generalroboticslab/Cartesian_Hand/media/hand-axes.jpg

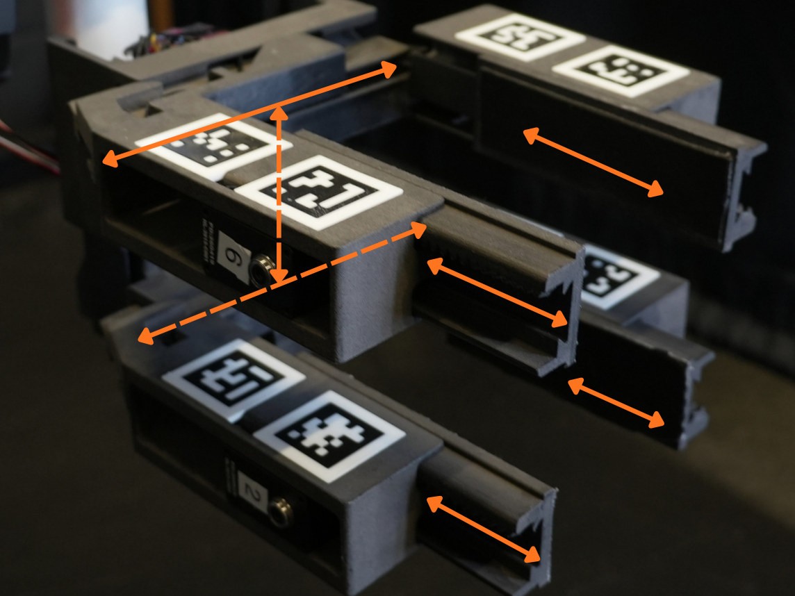
media/hand-axes.jpg
