generalroboticslab/Cartesian_Hand/assets/cartesian_hand/meshes/bridge__steel.obj

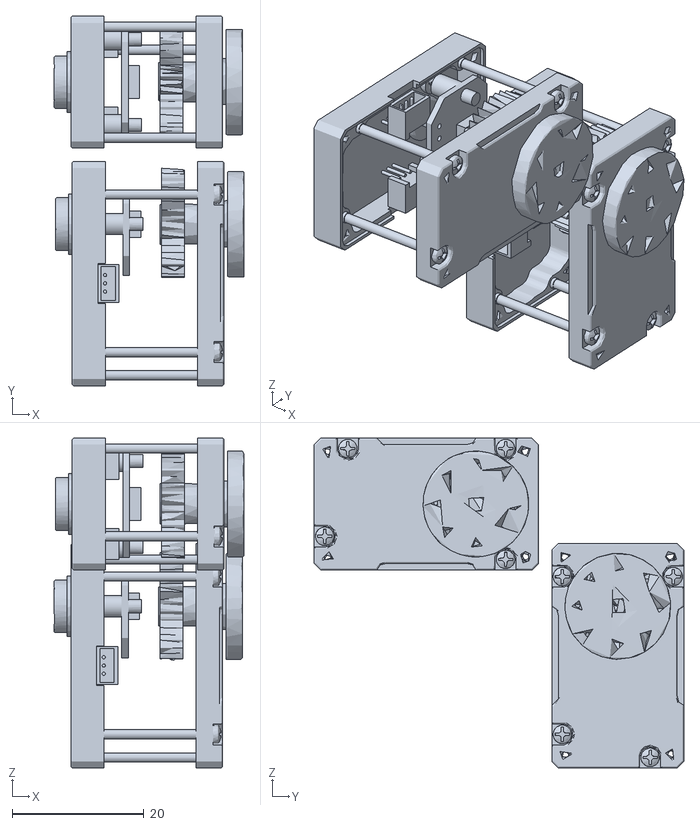
[picture p11: CAD file, 2026-09-22]
assets/cartesian_hand/meshes/bridge__steel.obj
28.7 x 56.0 x 50.0
