generalroboticslab/Cartesian_Hand/assets/cartesian_hand/meshes/collision_pieces/base_02.obj

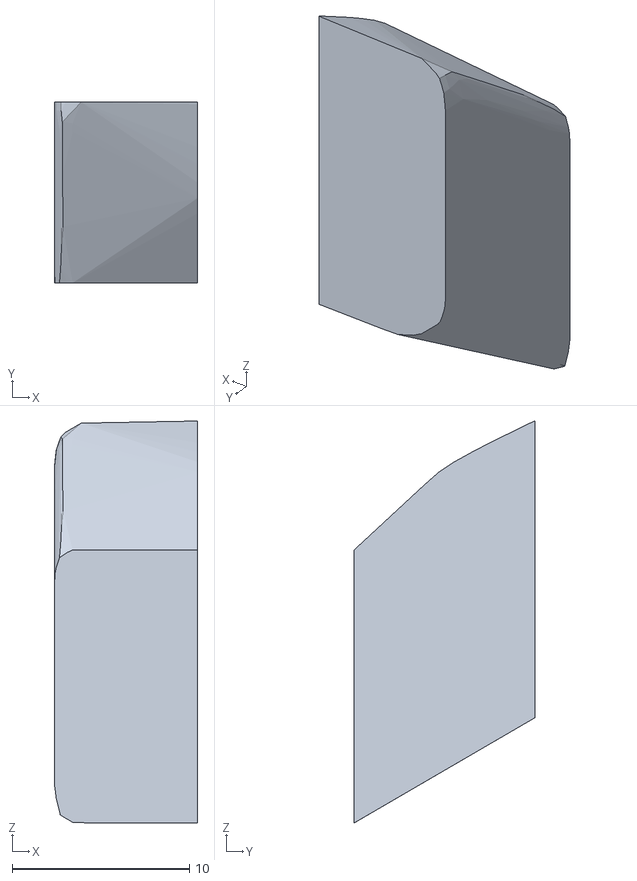
[picture p12: CAD file, 2026-09-22]
assets/cartesian_hand/meshes/collision_pieces/base_02.obj
8.08 x 10.2 x 22.7
