generalroboticslab/Cartesian_Hand/hardware/CAD/franka_mount.step

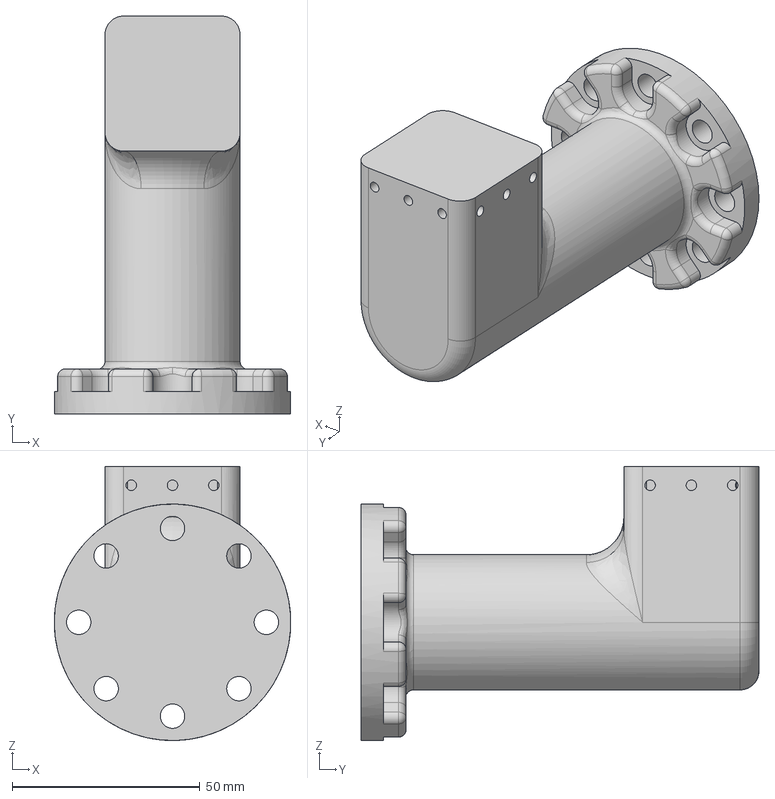
[picture p14: CAD file, 2026-09-28]
hardware/CAD/franka_mount.step
63.0 x 106.0 x 73.0 mm
