generalroboticslab/Cartesian_Hand/assets/cartesian_hand/meshes/collision_pieces/bridge_69.obj

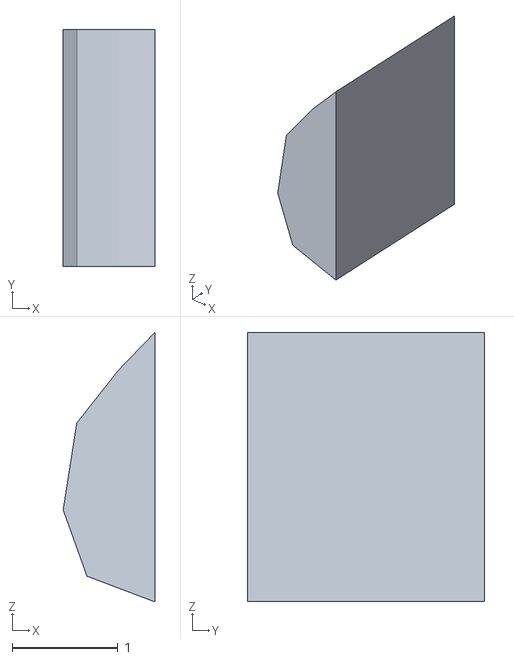
[picture p15: CAD file, 2026-09-22]
assets/cartesian_hand/meshes/collision_pieces/bridge_69.obj
0.865 x 2.24 x 2.54
