generalroboticslab/Cartesian_Hand/assets/cartesian_hand/meshes/left_up_finger__nylon.obj

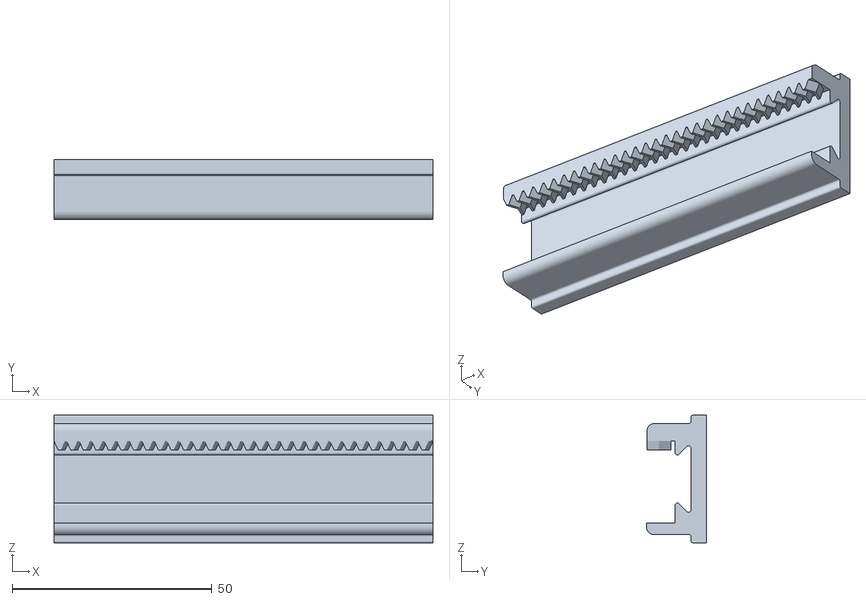
[picture p16: CAD file, 2026-09-22]
assets/cartesian_hand/meshes/left_up_finger__nylon.obj
94.9 x 15.1 x 32.0
