generalroboticslab/Cartesian_Hand/hardware/CAD/finger.step

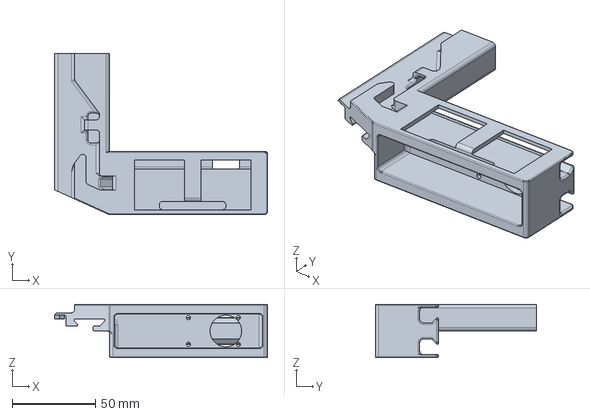
[picture p17: CAD file, 2026-09-28]
hardware/CAD/finger.step
127.9 x 97.0 x 31.9 mm
