generalroboticslab/Cartesian_Hand/assets/cartesian_hand/meshes/collision_pieces/bridge_27.obj

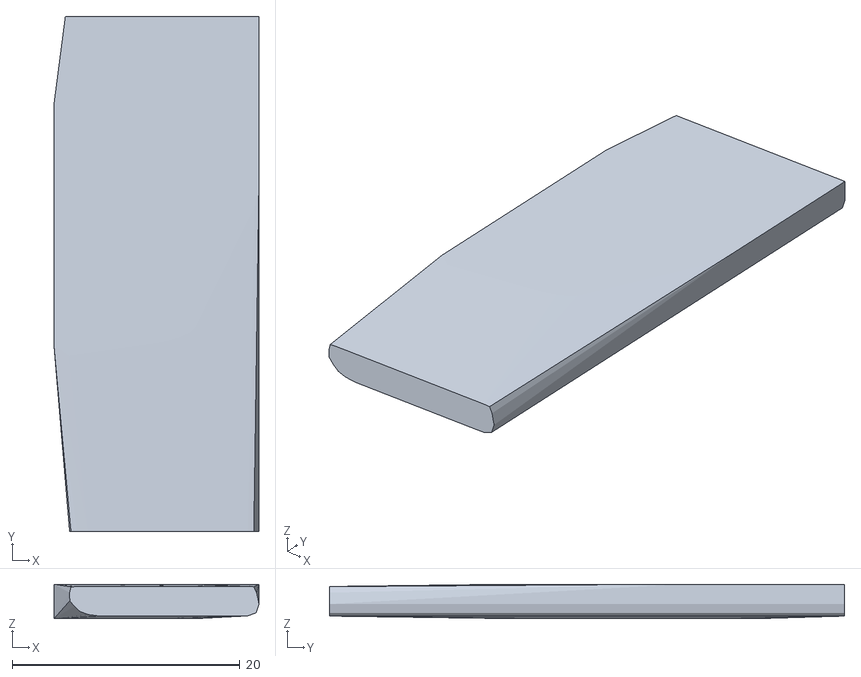
[picture p18: CAD file, 2026-09-22]
assets/cartesian_hand/meshes/collision_pieces/bridge_27.obj
18.0 x 45.2 x 3.02
