generalroboticslab/Cartesian_Hand/assets/cartesian_hand/meshes/collision_pieces/bridge_21.obj

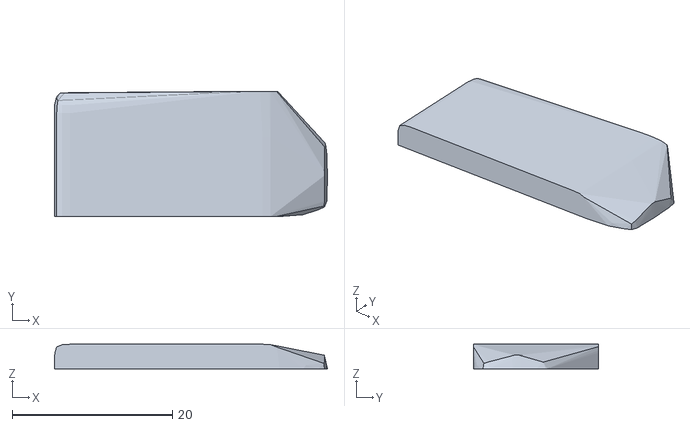
[picture p20: CAD file, 2026-09-22]
assets/cartesian_hand/meshes/collision_pieces/bridge_21.obj
34.1 x 15.6 x 3.07
