generalroboticslab/Cartesian_Hand/assets/cartesian_hand/meshes/left_down_rack__nylon.obj

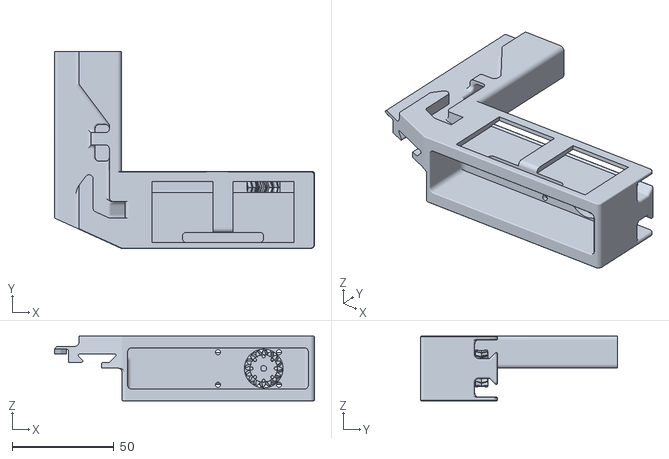
[picture p21: CAD file, 2026-09-22]
assets/cartesian_hand/meshes/left_down_rack__nylon.obj
127.9 x 97.0 x 31.9
