generalroboticslab/Cartesian_Hand/hardware/CAD/base gripper rail.step

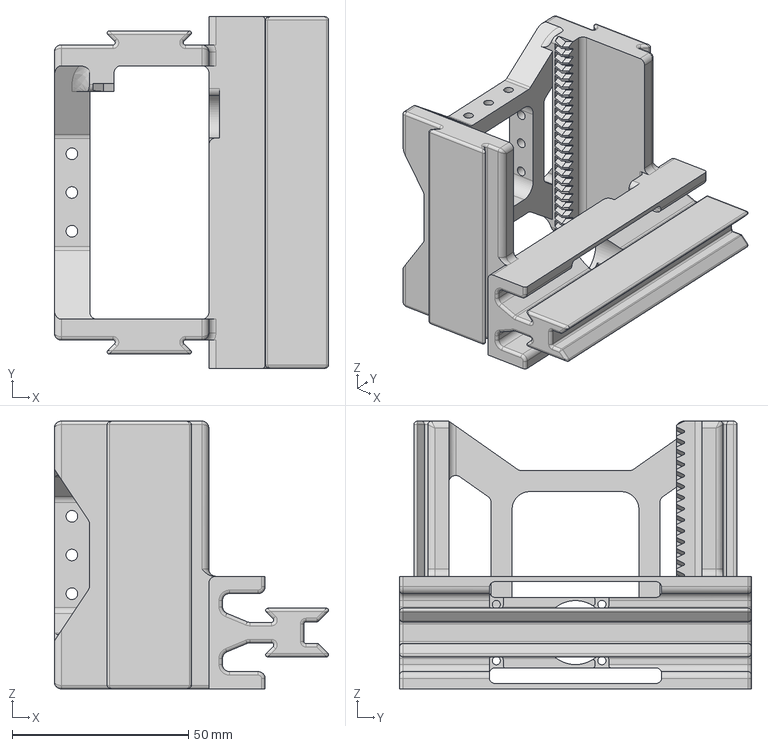
[picture p22: CAD file, 2026-09-28]
hardware/CAD/base gripper rail.step
78.0 x 100.0 x 76.1 mm
