generalroboticslab/Cartesian_Hand/assets/cartesian_hand/meshes/bridge__nylon.obj

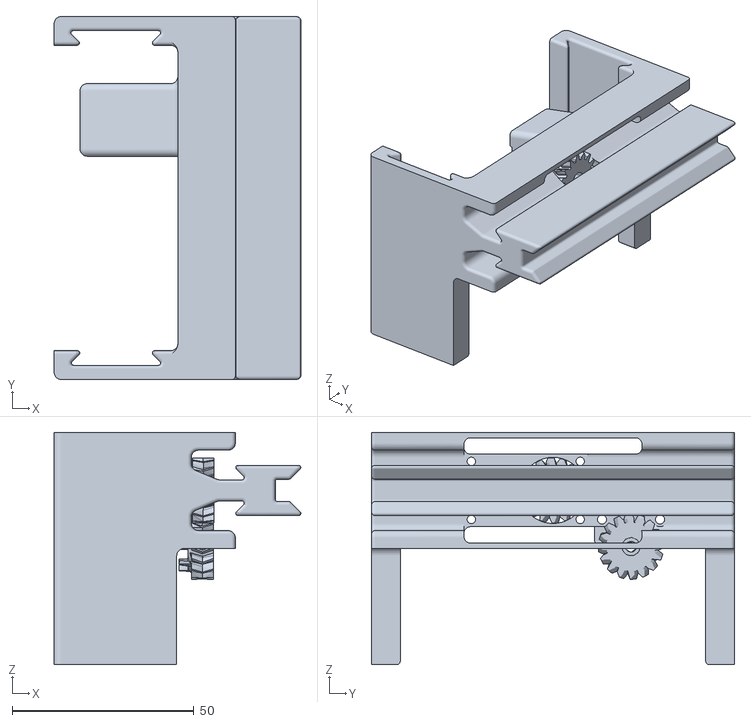
[picture p23: CAD file, 2026-09-22]
assets/cartesian_hand/meshes/bridge__nylon.obj
68.0 x 100.0 x 64.0
