generalroboticslab/Cartesian_Hand/assets/cartesian_hand/meshes/collision_pieces/base_80.obj

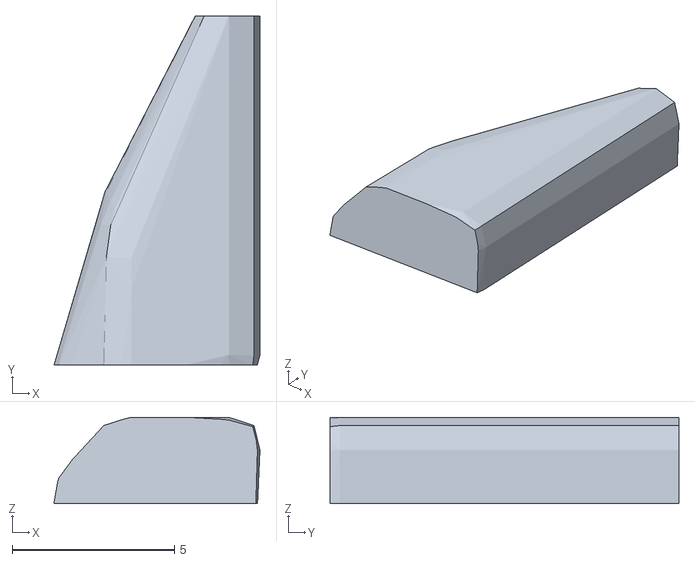
[picture p24: CAD file, 2026-09-22]
assets/cartesian_hand/meshes/collision_pieces/base_80.obj
6.35 x 10.8 x 2.66
