generalroboticslab/Cartesian_Hand/hardware/CAD/gear.step

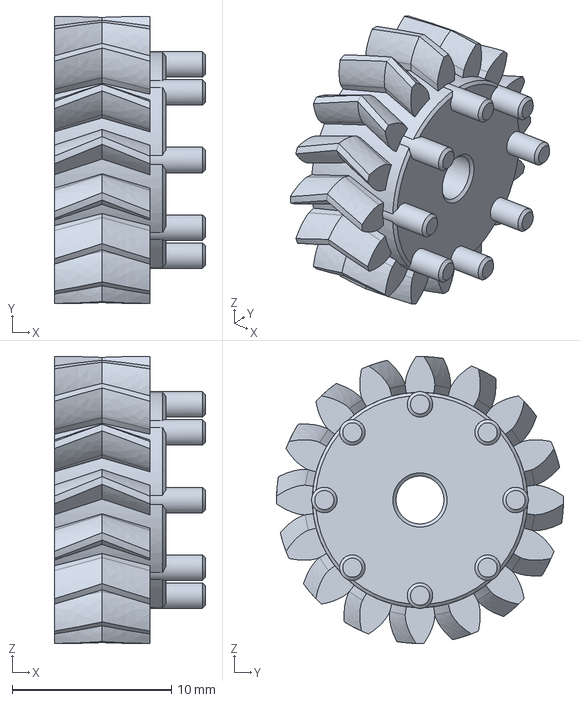
[picture p25: CAD file, 2026-09-28]
hardware/CAD/gear.step
9.50 x 18.0 x 18.0 mm
