generalroboticslab/Cartesian_Hand/assets/cartesian_hand/meshes/collision_pieces/base_18.obj

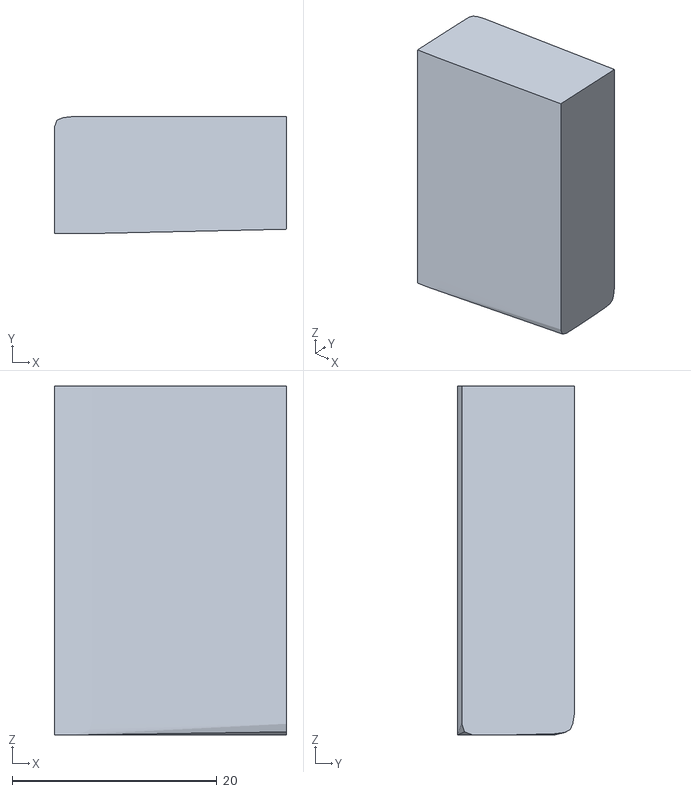
[picture p26: CAD file, 2026-09-22]
assets/cartesian_hand/meshes/collision_pieces/base_18.obj
22.7 x 11.4 x 34.1
