generalroboticslab/Cartesian_Hand/assets/cartesian_hand/meshes/left_up_rack__red.obj

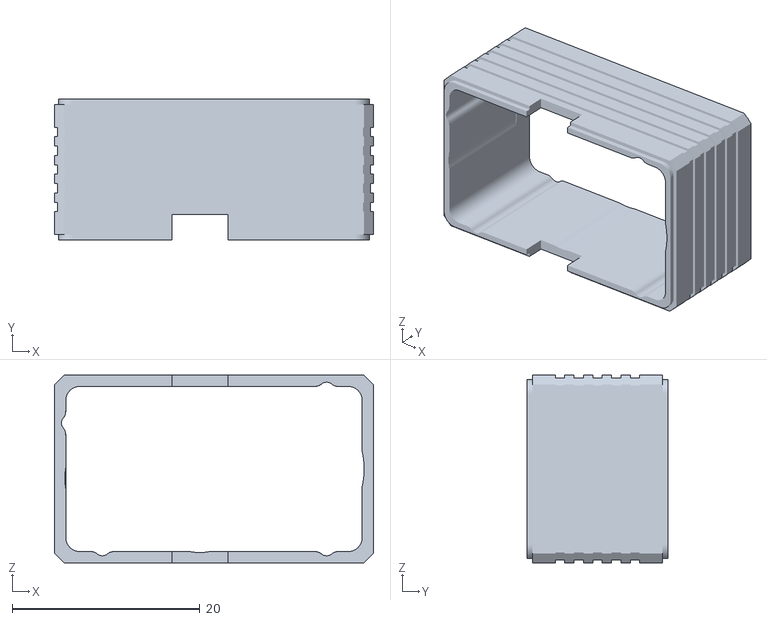
[picture p27: CAD file, 2026-09-22]
assets/cartesian_hand/meshes/left_up_rack__red.obj
34.0 x 15.0 x 20.0
