generalroboticslab/Cartesian_Hand/hardware/CAD/auxiliary gripper rail.step

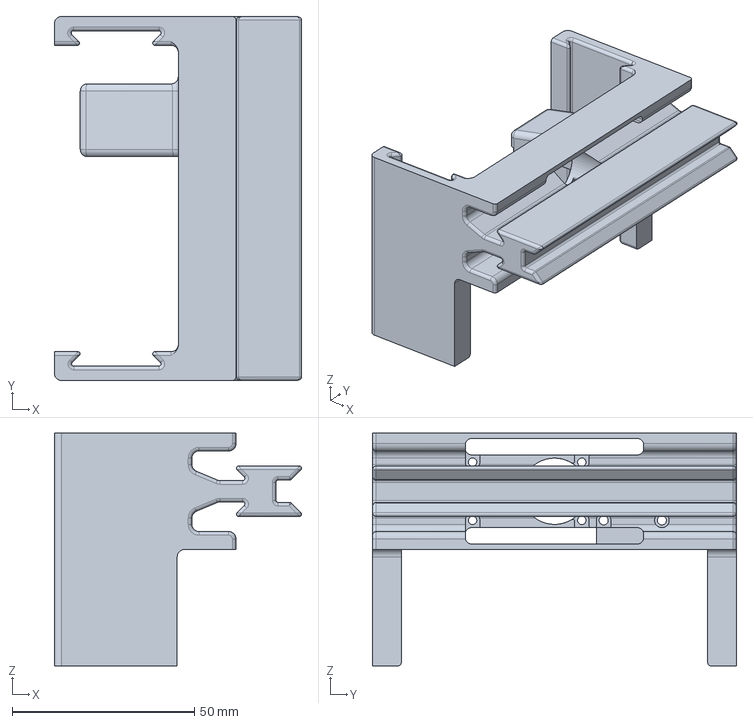
[picture p28: CAD file, 2026-09-28]
hardware/CAD/auxiliary gripper rail.step
68.0 x 100.0 x 64.0 mm
