generalroboticslab/Cartesian_Hand/assets/cartesian_hand/meshes/collision_pieces/bridge_06.obj

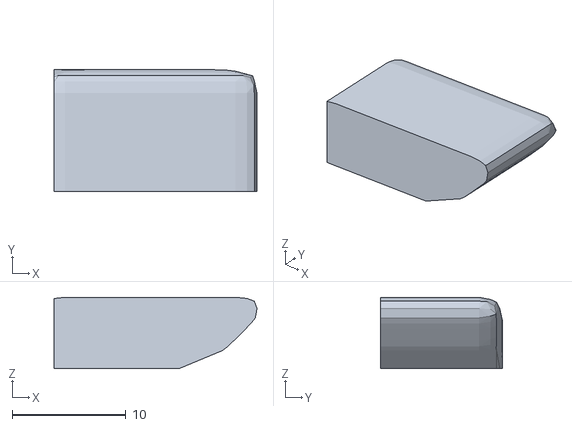
[picture p29: CAD file, 2026-09-22]
assets/cartesian_hand/meshes/collision_pieces/bridge_06.obj
17.9 x 10.7 x 6.29
