generalroboticslab/Cartesian_Hand/assets/cartesian_hand/meshes/collision_pieces/base_56.obj

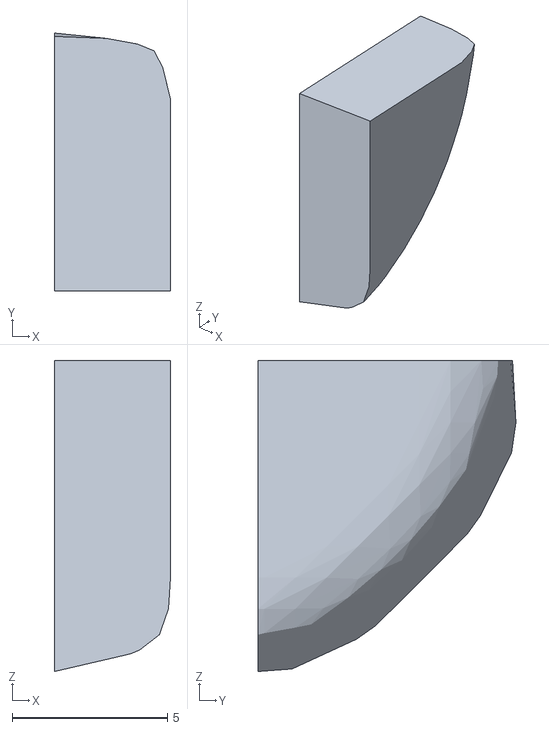
[picture p30: CAD file, 2026-09-22]
assets/cartesian_hand/meshes/collision_pieces/base_56.obj
3.74 x 8.31 x 10.0
