generalroboticslab/Cartesian_Hand/assets/cartesian_hand/meshes/collision_pieces/base_74.obj

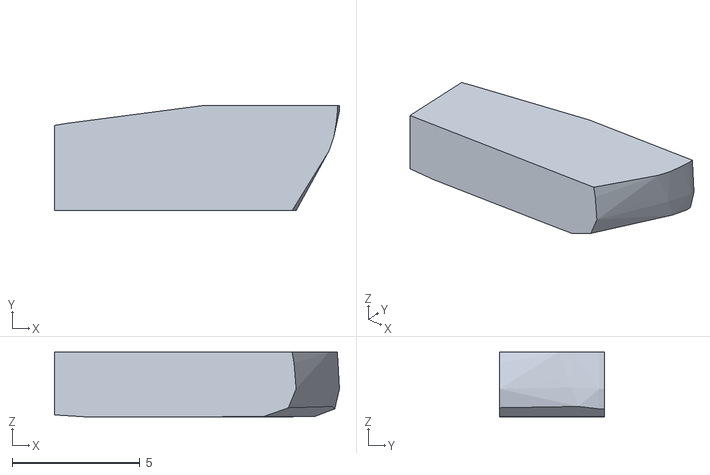
[picture p31: CAD file, 2026-09-22]
assets/cartesian_hand/meshes/collision_pieces/base_74.obj
11.1 x 4.12 x 2.53
