generalroboticslab/Cartesian_Hand/assets/cartesian_hand/meshes/collision_pieces/bridge_62.obj

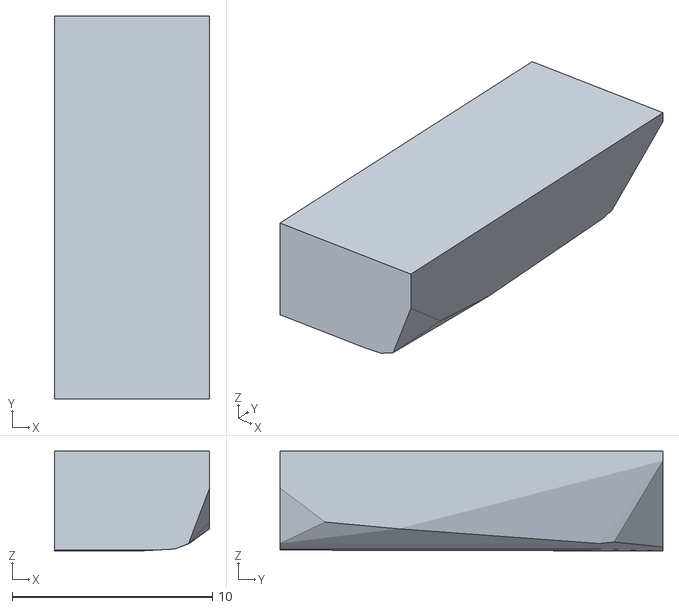
[picture p32: CAD file, 2026-09-22]
assets/cartesian_hand/meshes/collision_pieces/bridge_62.obj
7.74 x 19.1 x 4.98
