generalroboticslab/Cartesian_Hand/assets/cartesian_hand/meshes/collision_pieces/bridge_18.obj

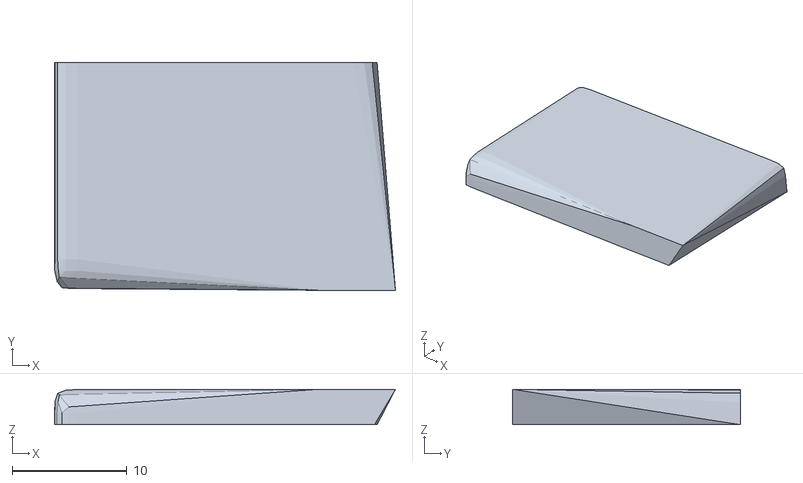
[picture p33: CAD file, 2026-09-22]
assets/cartesian_hand/meshes/collision_pieces/bridge_18.obj
29.7 x 19.8 x 3.07
