generalroboticslab/Cartesian_Hand/assets/cartesian_hand/meshes/left_up_rack__steel.obj

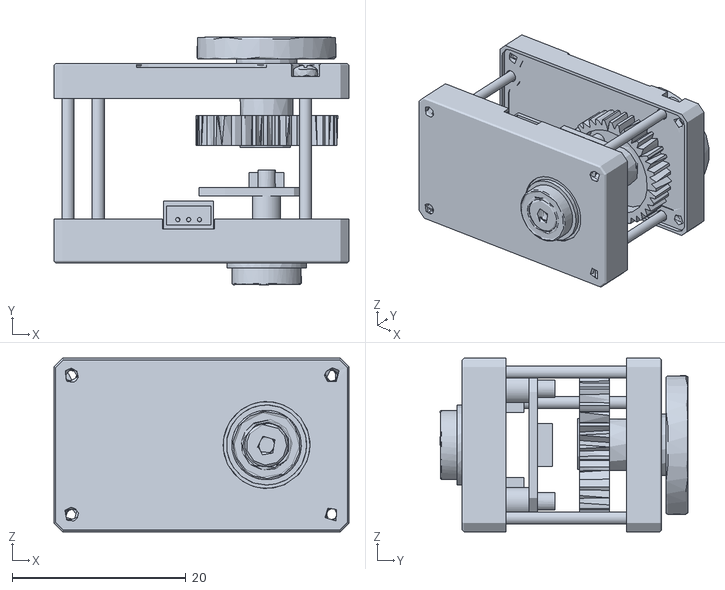
[picture p34: CAD file, 2026-09-22]
assets/cartesian_hand/meshes/left_up_rack__steel.obj
34.0 x 28.5 x 20.0
