generalroboticslab/Cartesian_Hand/assets/cartesian_hand/meshes/collision_pieces/base_32.obj

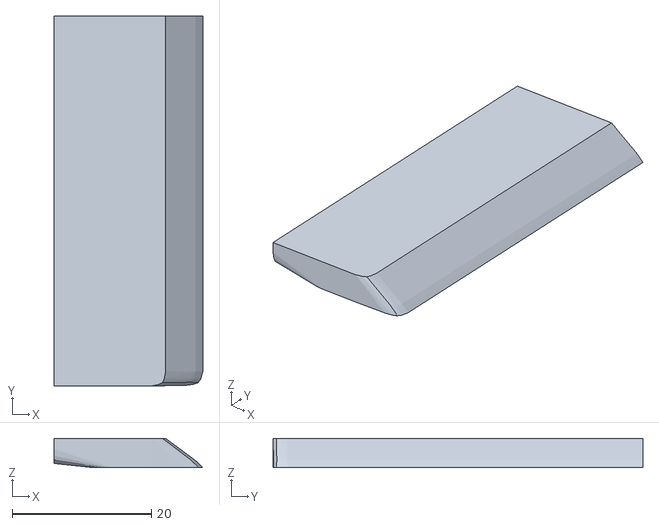
[picture p35: CAD file, 2026-09-22]
assets/cartesian_hand/meshes/collision_pieces/base_32.obj
21.4 x 53.2 x 4.22
