generalroboticslab/Cartesian_Hand/assets/cartesian_hand/meshes/collision_pieces/base_53.obj

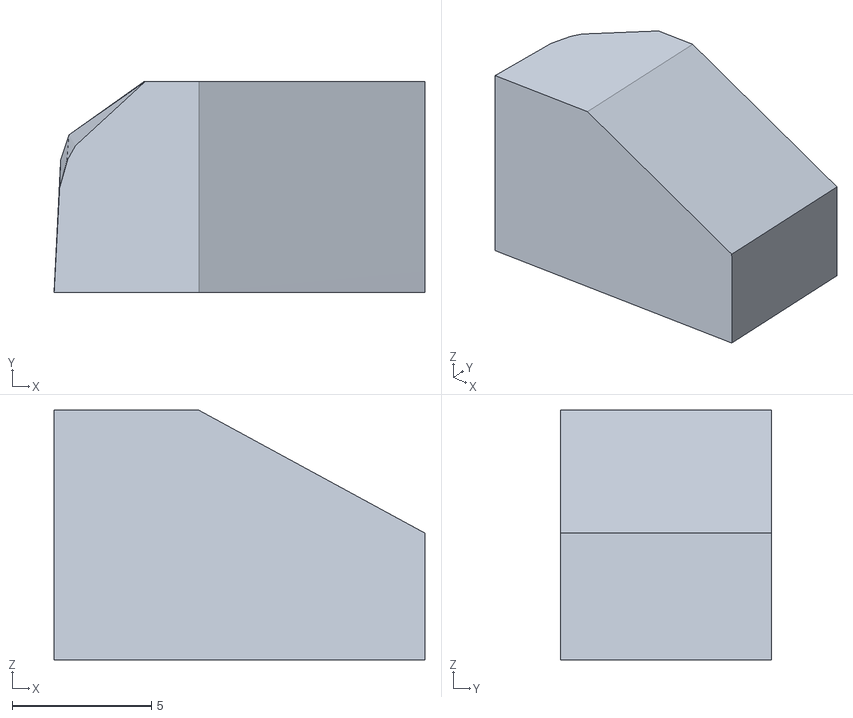
[picture p36: CAD file, 2026-09-22]
assets/cartesian_hand/meshes/collision_pieces/base_53.obj
13.3 x 7.57 x 8.96
