generalroboticslab/Cartesian_Hand/assets/cartesian_hand/meshes/bridge__red.obj

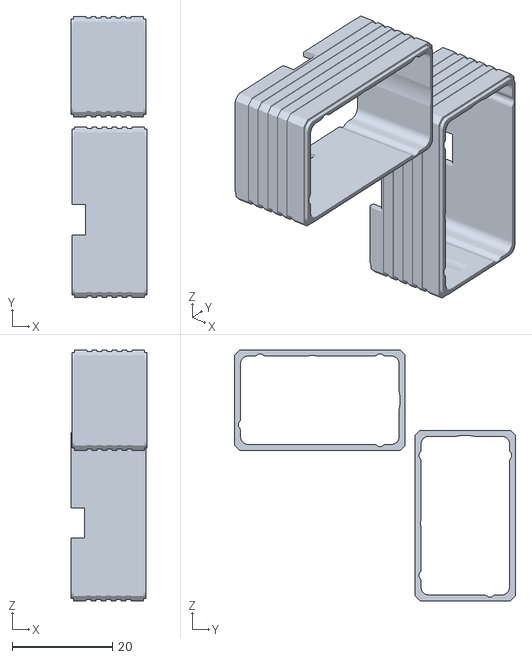
[picture p37: CAD file, 2026-09-22]
assets/cartesian_hand/meshes/bridge__red.obj
15.2 x 56.0 x 50.0
