generalroboticslab/Cartesian_Hand/assets/cartesian_hand/meshes/collision_pieces/bridge_11.obj

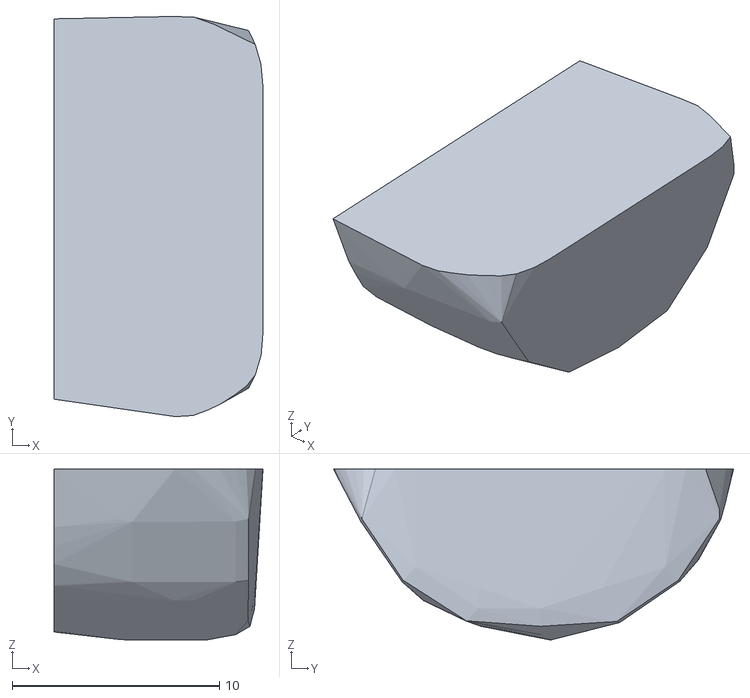
[picture p38: CAD file, 2026-09-22]
assets/cartesian_hand/meshes/collision_pieces/bridge_11.obj
10.1 x 19.3 x 8.23
