generalroboticslab/Cartesian_Hand/assets/cartesian_hand/meshes/collision_pieces/base_63.obj

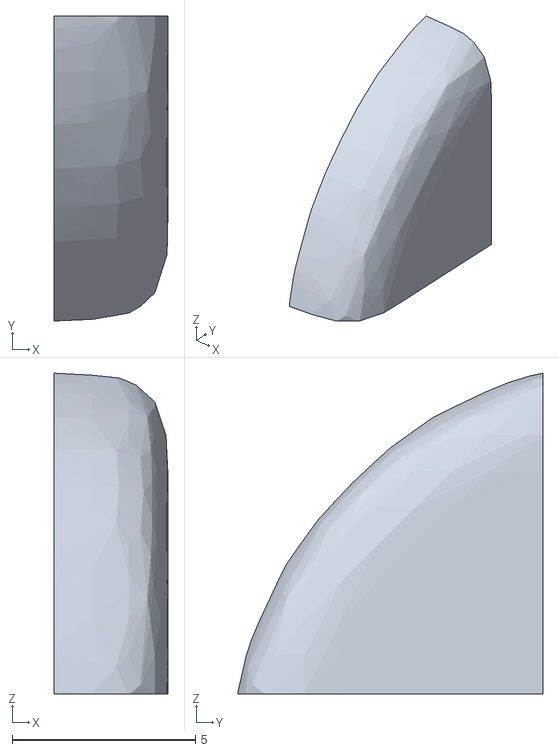
[picture p39: CAD file, 2026-09-22]
assets/cartesian_hand/meshes/collision_pieces/base_63.obj
3.10 x 8.32 x 8.75
