generalroboticslab/Cartesian_Hand/assets/cartesian_hand/meshes/collision_pieces/base_04.obj

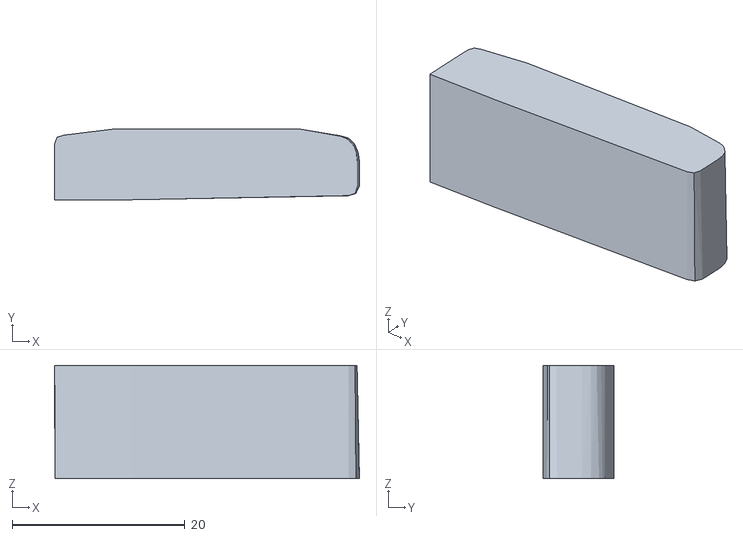
[picture p40: CAD file, 2026-09-22]
assets/cartesian_hand/meshes/collision_pieces/base_04.obj
35.4 x 8.18 x 13.1
