generalroboticslab/Cartesian_Hand/assets/cartesian_hand/meshes/collision_pieces/base_62.obj

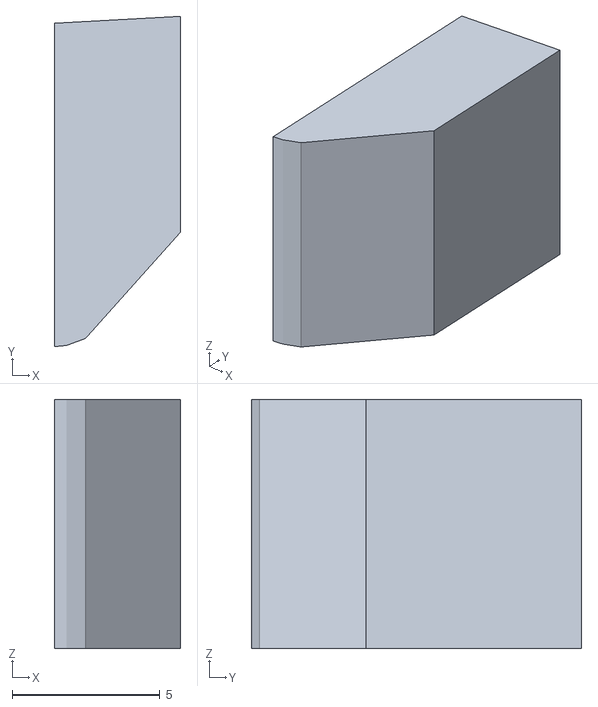
[picture p41: CAD file, 2026-09-22]
assets/cartesian_hand/meshes/collision_pieces/base_62.obj
4.27 x 11.2 x 8.44
