generalroboticslab/Cartesian_Hand/assets/cartesian_hand/meshes/collision_pieces/base_64.obj

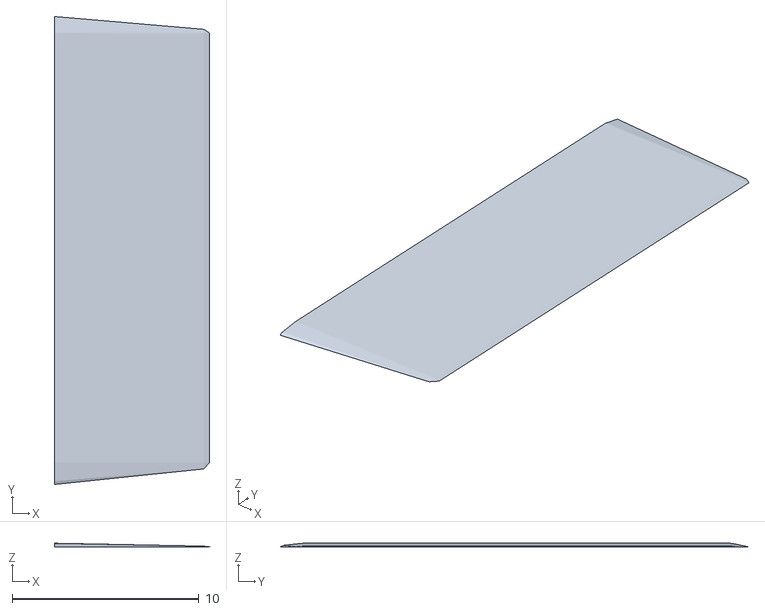
[picture p42: CAD file, 2026-09-22]
assets/cartesian_hand/meshes/collision_pieces/base_64.obj
8.32 x 25.1 x 0.195
