generalroboticslab/Cartesian_Hand/assets/cartesian_hand/meshes/base__nylon.obj

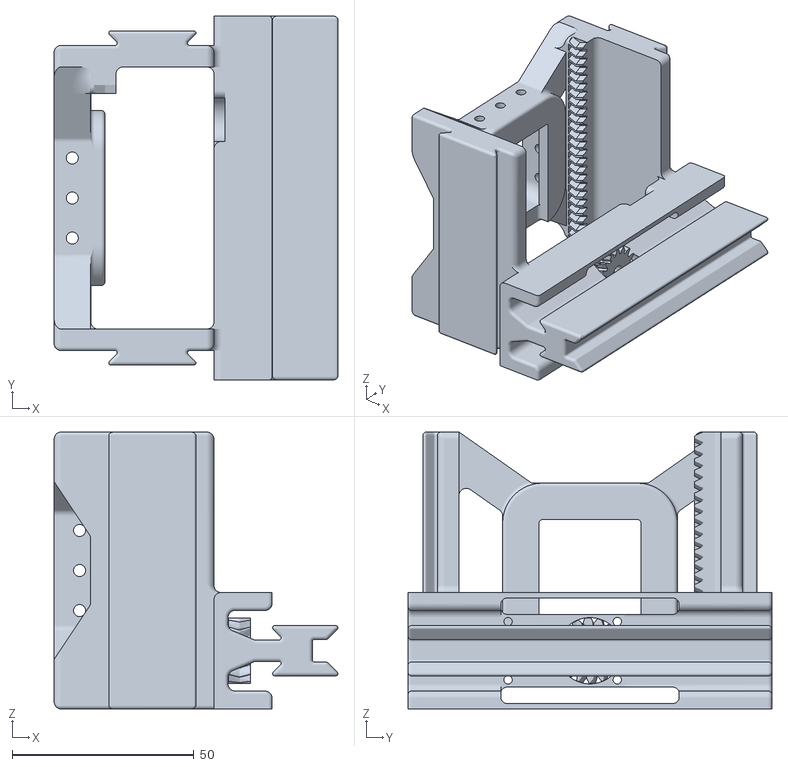
[picture p43: CAD file, 2026-09-22]
assets/cartesian_hand/meshes/base__nylon.obj
78.0 x 100.0 x 76.1
