generalroboticslab/Cartesian_Hand/assets/cartesian_hand/meshes/collision_pieces/base_17.obj

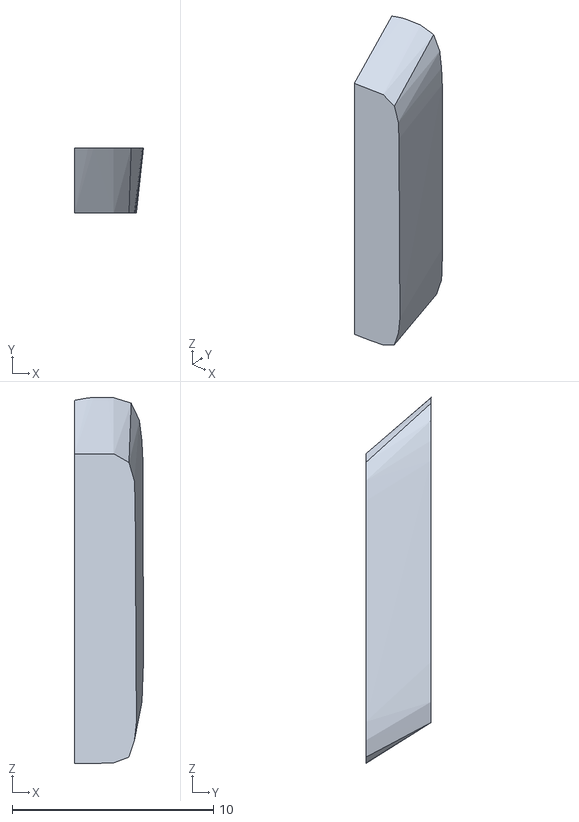
[picture p44: CAD file, 2026-09-22]
assets/cartesian_hand/meshes/collision_pieces/base_17.obj
3.43 x 3.25 x 18.2
