generalroboticslab/Cartesian_Hand/assets/cartesian_hand/meshes/collision_pieces/base_65.obj

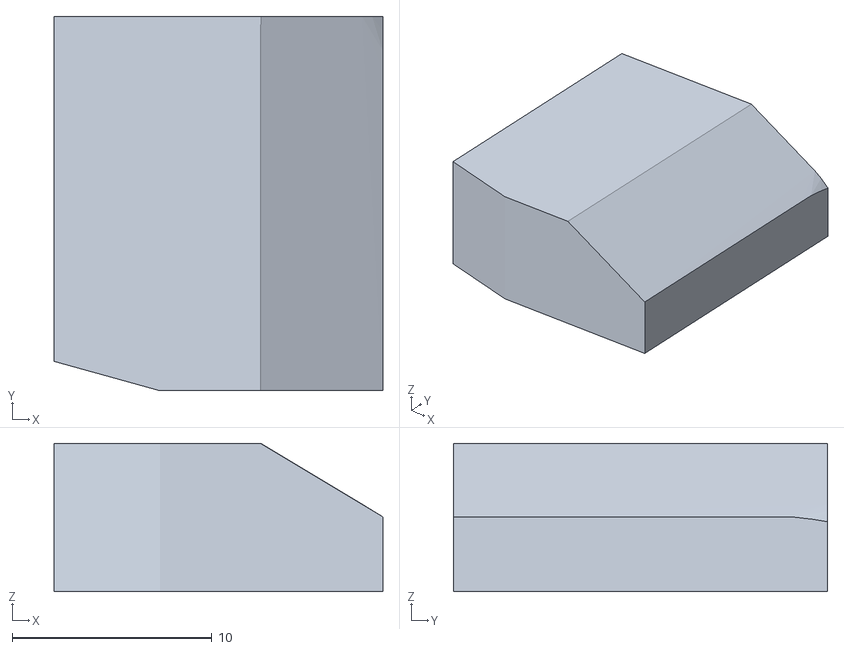
[picture p45: CAD file, 2026-09-22]
assets/cartesian_hand/meshes/collision_pieces/base_65.obj
16.5 x 18.7 x 7.42
