generalroboticslab/Cartesian_Hand/assets/cartesian_hand/meshes/collision_pieces/bridge_49.obj

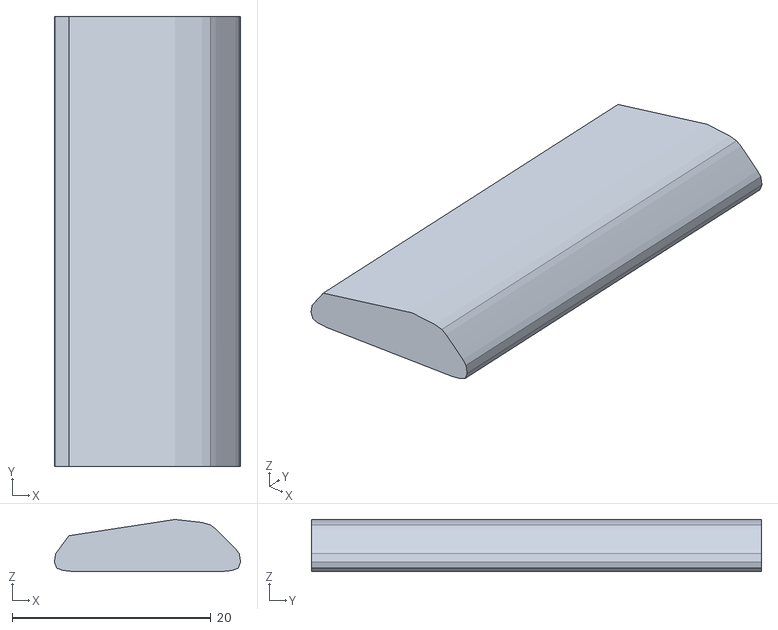
[picture p46: CAD file, 2026-09-22]
assets/cartesian_hand/meshes/collision_pieces/bridge_49.obj
18.7 x 45.2 x 5.23
