generalroboticslab/Cartesian_Hand/assets/cartesian_hand/meshes/collision_pieces/base_55.obj

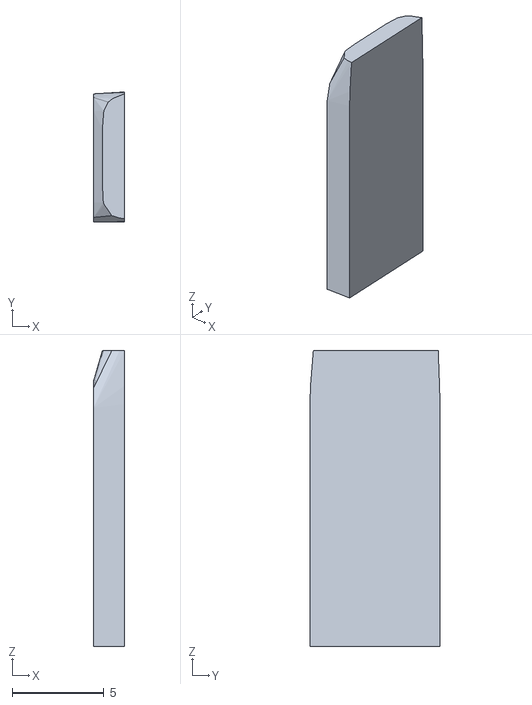
[picture p47: CAD file, 2026-09-22]
assets/cartesian_hand/meshes/collision_pieces/base_55.obj
1.70 x 7.08 x 16.1
