generalroboticslab/Cartesian_Hand/assets/cartesian_hand/meshes/collision_pieces/base_76.obj

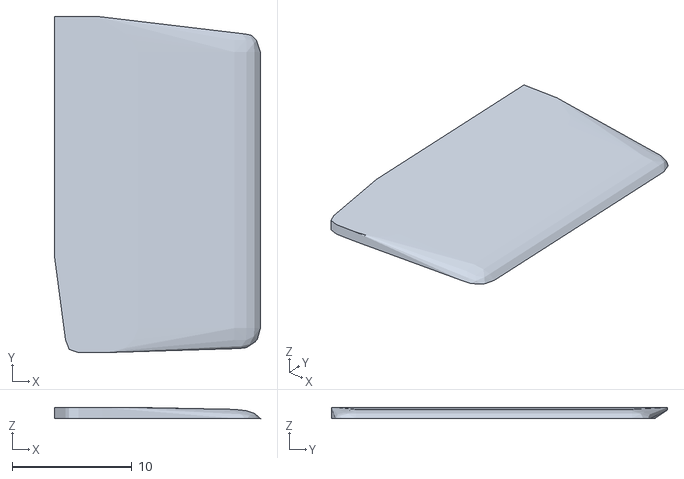
[picture p48: CAD file, 2026-09-22]
assets/cartesian_hand/meshes/collision_pieces/base_76.obj
17.2 x 28.0 x 0.921
