generalroboticslab/Cartesian_Hand/assets/cartesian_hand/meshes/collision_pieces/bridge_00.obj

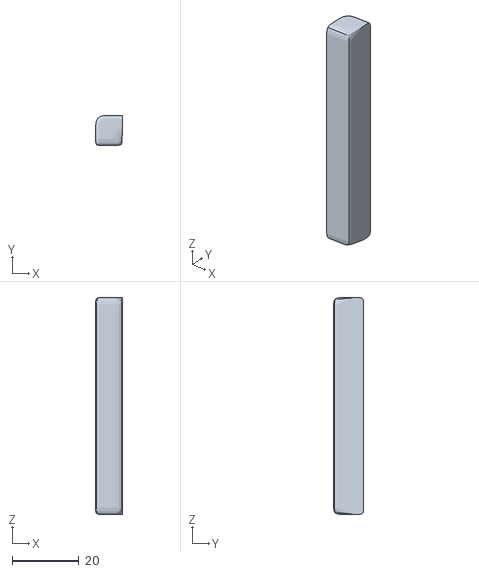
[picture p49: CAD file, 2026-09-22]
assets/cartesian_hand/meshes/collision_pieces/bridge_00.obj
8.02 x 9.03 x 65.1
