generalroboticslab/Cartesian_Hand/assets/cartesian_hand/meshes/collision_pieces/bridge_61.obj

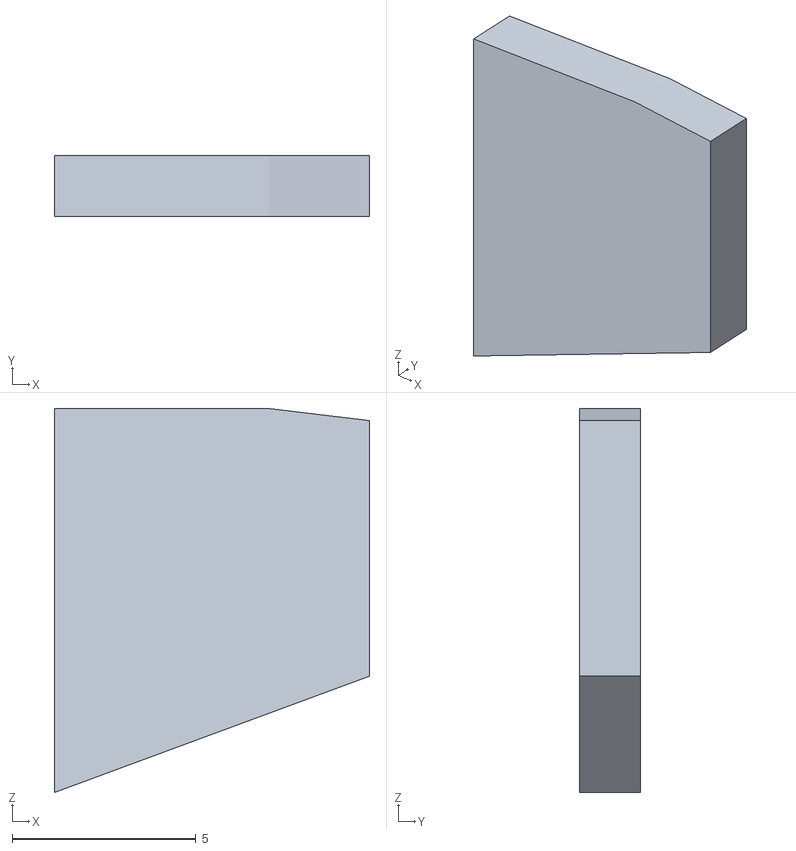
[picture p50: CAD file, 2026-09-22]
assets/cartesian_hand/meshes/collision_pieces/bridge_61.obj
8.57 x 1.66 x 10.4
