generalroboticslab/Cartesian_Hand/assets/cartesian_hand/meshes/collision_pieces/bridge_65.obj

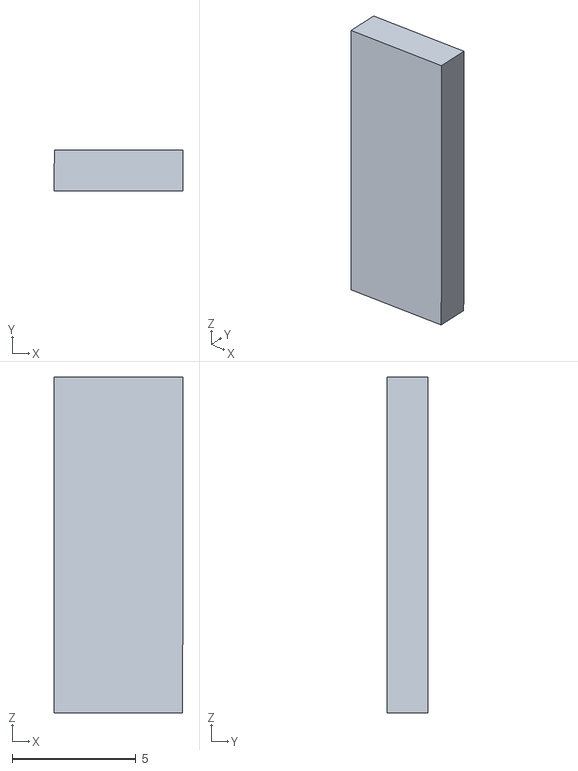
[picture p51: CAD file, 2026-09-22]
assets/cartesian_hand/meshes/collision_pieces/bridge_65.obj
5.19 x 1.66 x 13.6
