generalroboticslab/Cartesian_Hand/assets/cartesian_hand/meshes/collision_pieces/base_45.obj

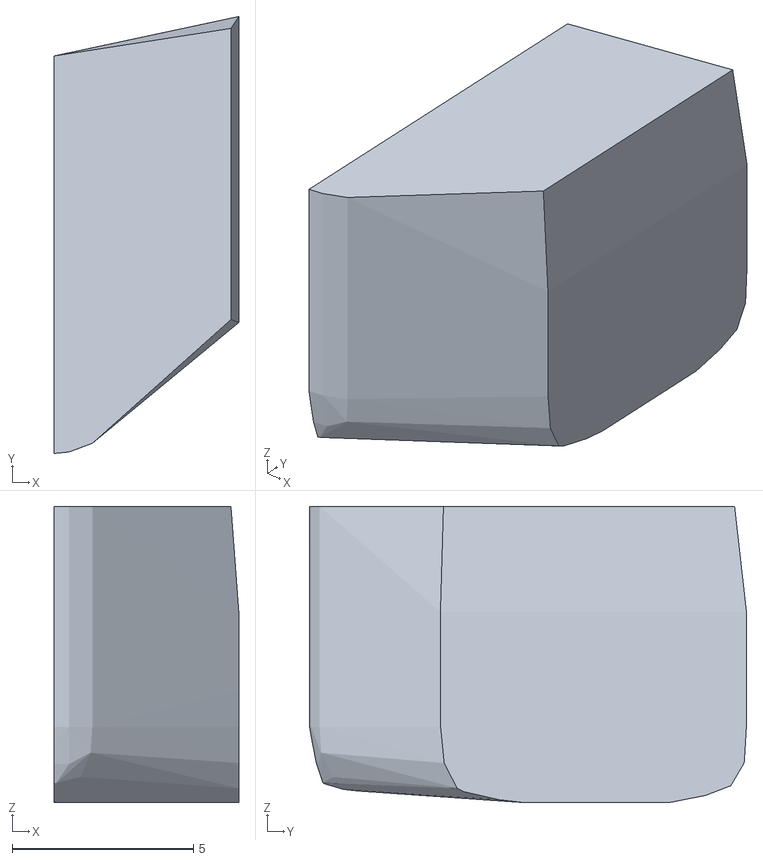
[picture p52: CAD file, 2026-09-22]
assets/cartesian_hand/meshes/collision_pieces/base_45.obj
5.09 x 12.1 x 8.17
