generalroboticslab/Cartesian_Hand/assets/cartesian_hand/meshes/collision_pieces/bridge_34.obj

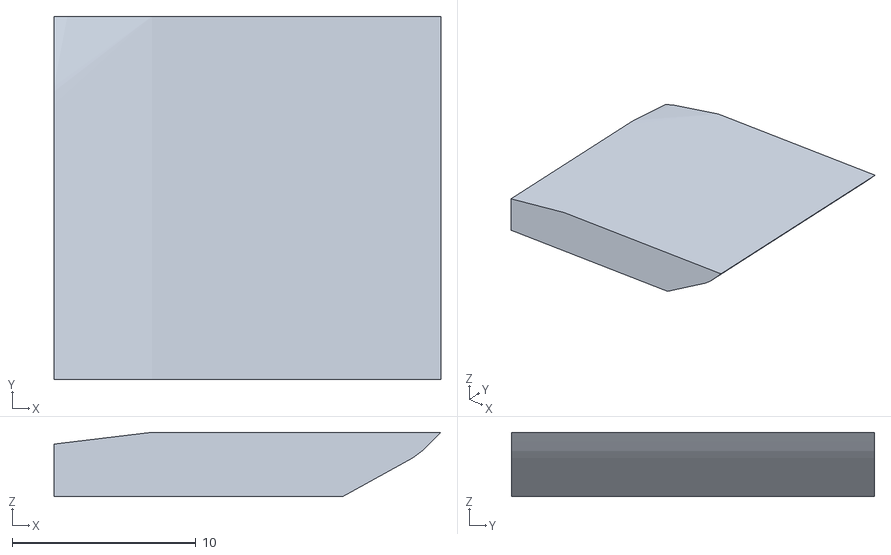
[picture p53: CAD file, 2026-09-22]
assets/cartesian_hand/meshes/collision_pieces/bridge_34.obj
21.1 x 19.8 x 3.51
