generalroboticslab/Cartesian_Hand/assets/cartesian_hand/meshes/collision_pieces/base_66.obj

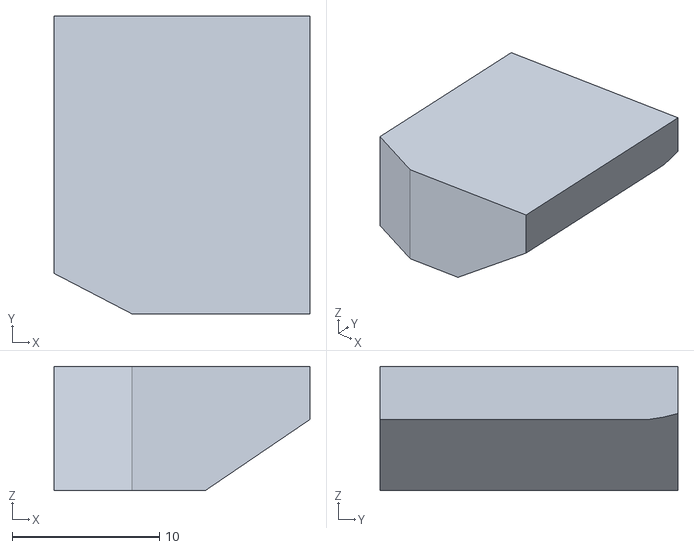
[picture p54: CAD file, 2026-09-22]
assets/cartesian_hand/meshes/collision_pieces/base_66.obj
17.4 x 20.3 x 8.44
