generalroboticslab/Cartesian_Hand/assets/cartesian_hand/meshes/collision_pieces/base_77.obj

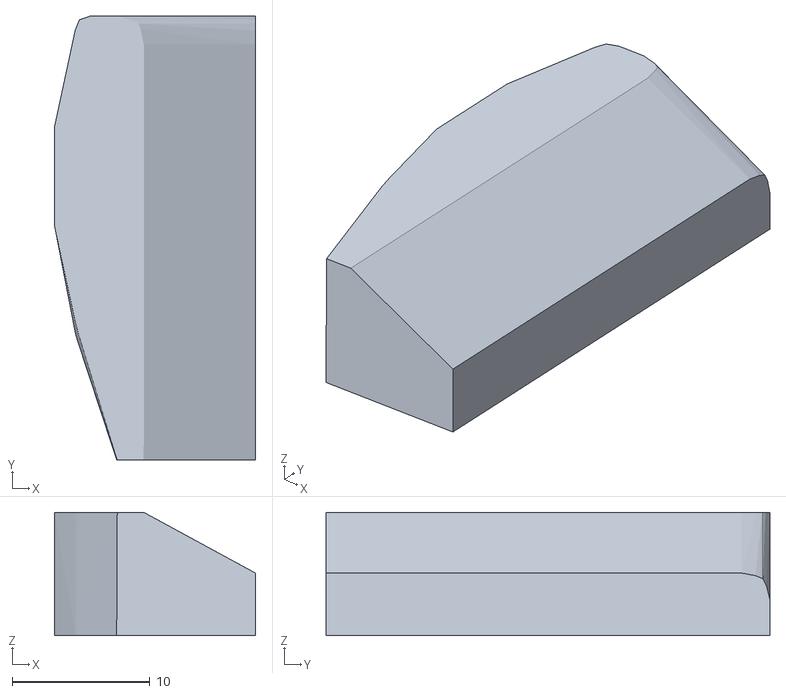
[picture p55: CAD file, 2026-09-22]
assets/cartesian_hand/meshes/collision_pieces/base_77.obj
14.6 x 32.2 x 8.96
