generalroboticslab/Cartesian_Hand/assets/cartesian_hand/meshes/collision_pieces/base_08.obj

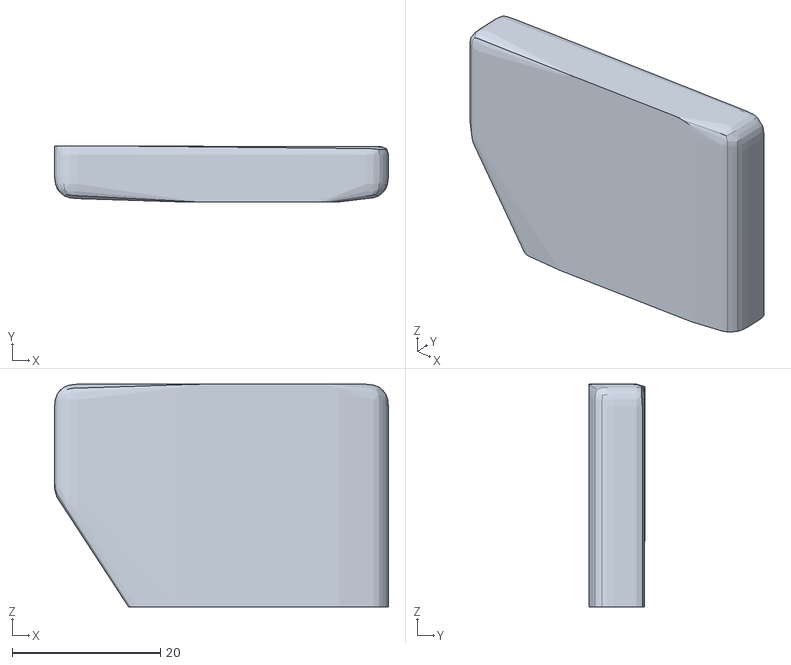
[picture p56: CAD file, 2026-09-22]
assets/cartesian_hand/meshes/collision_pieces/base_08.obj
45.0 x 7.51 x 30.0
