generalroboticslab/Cartesian_Hand/assets/cartesian_hand/meshes/collision_pieces/bridge_43.obj

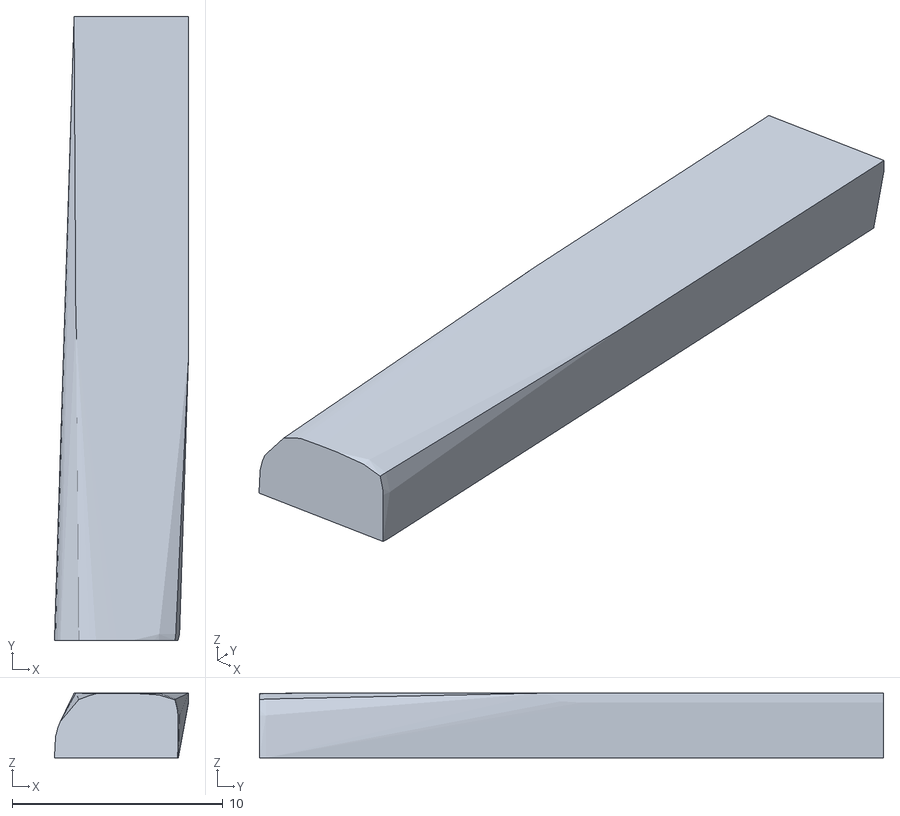
[picture p57: CAD file, 2026-09-22]
assets/cartesian_hand/meshes/collision_pieces/bridge_43.obj
6.37 x 29.6 x 3.08
