generalroboticslab/Cartesian_Hand/assets/cartesian_hand/meshes/collision_pieces/base_33.obj

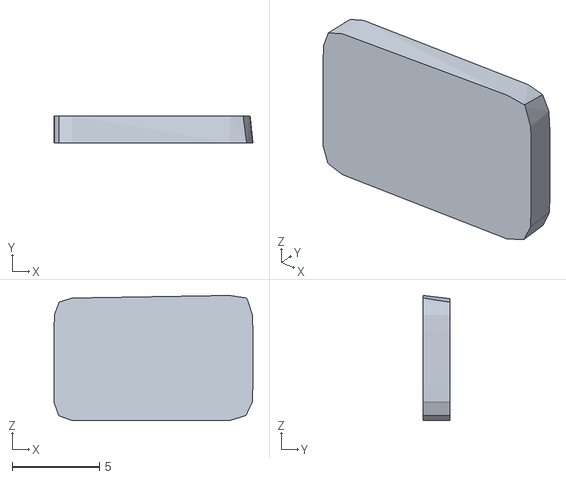
[picture p58: CAD file, 2026-09-22]
assets/cartesian_hand/meshes/collision_pieces/base_33.obj
11.4 x 1.52 x 7.16
