generalroboticslab/Cartesian_Hand/assets/cartesian_hand/meshes/collision_pieces/base_24.obj

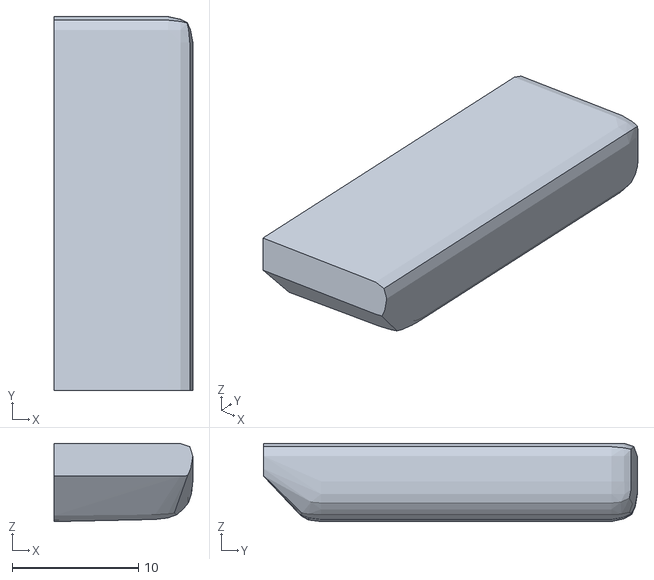
[picture p59: CAD file, 2026-09-22]
assets/cartesian_hand/meshes/collision_pieces/base_24.obj
11.0 x 29.6 x 6.19
