generalroboticslab/Cartesian_Hand/assets/cartesian_hand/meshes/collision_pieces/base_23.obj

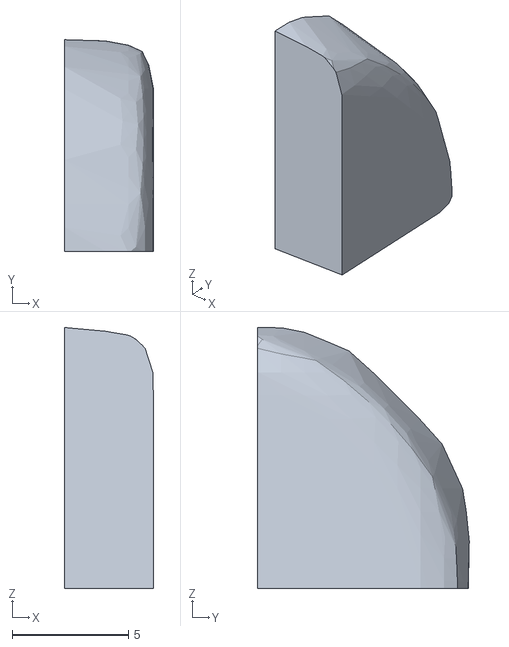
[picture p60: CAD file, 2026-09-22]
assets/cartesian_hand/meshes/collision_pieces/base_23.obj
3.81 x 9.09 x 11.2
