generalroboticslab/Cartesian_Hand/assets/cartesian_hand/meshes/collision_pieces/bridge_24.obj

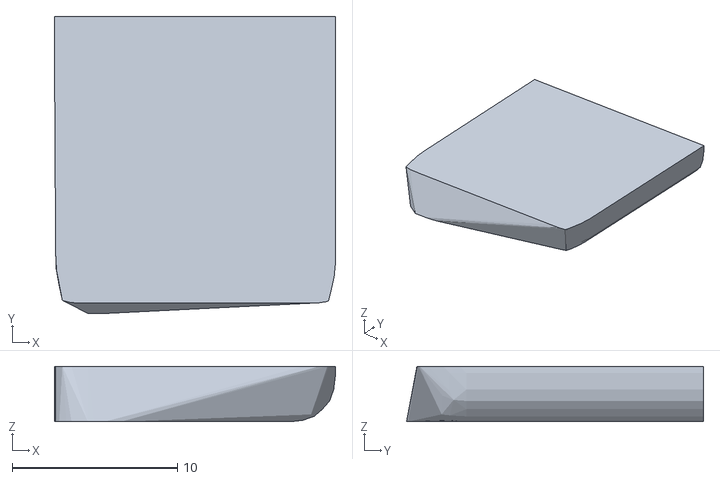
[picture p61: CAD file, 2026-09-22]
assets/cartesian_hand/meshes/collision_pieces/bridge_24.obj
17.0 x 18.0 x 3.35
