generalroboticslab/Cartesian_Hand/assets/cartesian_hand/meshes/collision_pieces/base_79.obj

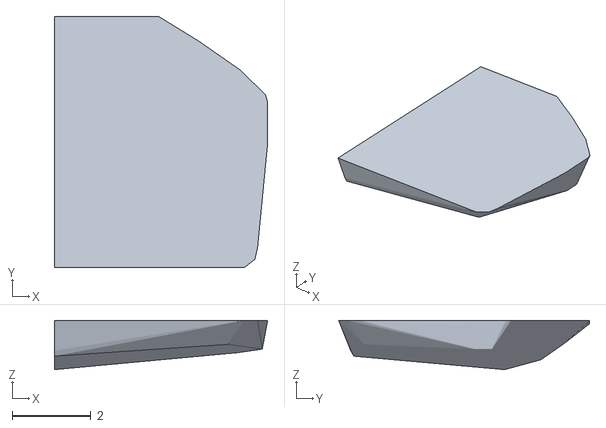
[picture p62: CAD file, 2026-09-22]
assets/cartesian_hand/meshes/collision_pieces/base_79.obj
5.42 x 6.37 x 1.25
