generalroboticslab/Cartesian_Hand/assets/cartesian_hand/meshes/collision_pieces/base_85.obj

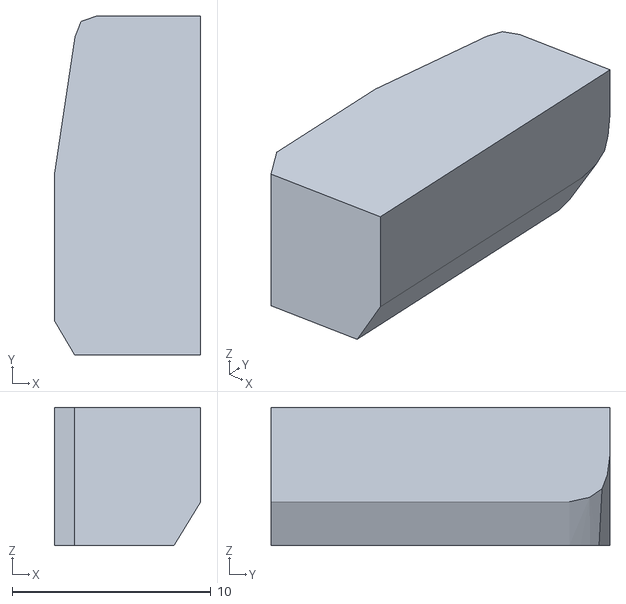
[picture p63: CAD file, 2026-09-22]
assets/cartesian_hand/meshes/collision_pieces/base_85.obj
7.37 x 17.1 x 6.95
