generalroboticslab/Cartesian_Hand/assets/cartesian_hand/meshes/collision_pieces/bridge_54.obj

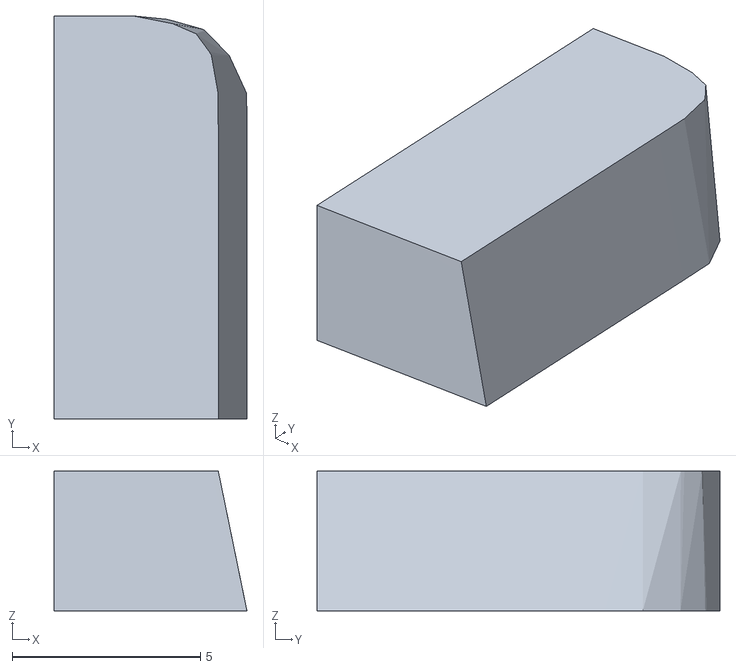
[picture p64: CAD file, 2026-09-22]
assets/cartesian_hand/meshes/collision_pieces/bridge_54.obj
5.13 x 10.7 x 3.72
