generalroboticslab/Cartesian_Hand/assets/cartesian_hand/meshes/collision_pieces/bridge_41.obj

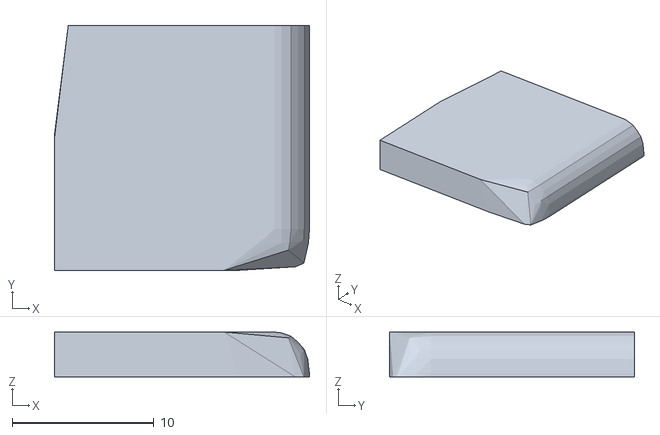
[picture p65: CAD file, 2026-09-22]
assets/cartesian_hand/meshes/collision_pieces/bridge_41.obj
18.0 x 17.3 x 3.17
