generalroboticslab/Cartesian_Hand/assets/cartesian_hand/meshes/collision_pieces/base_47.obj

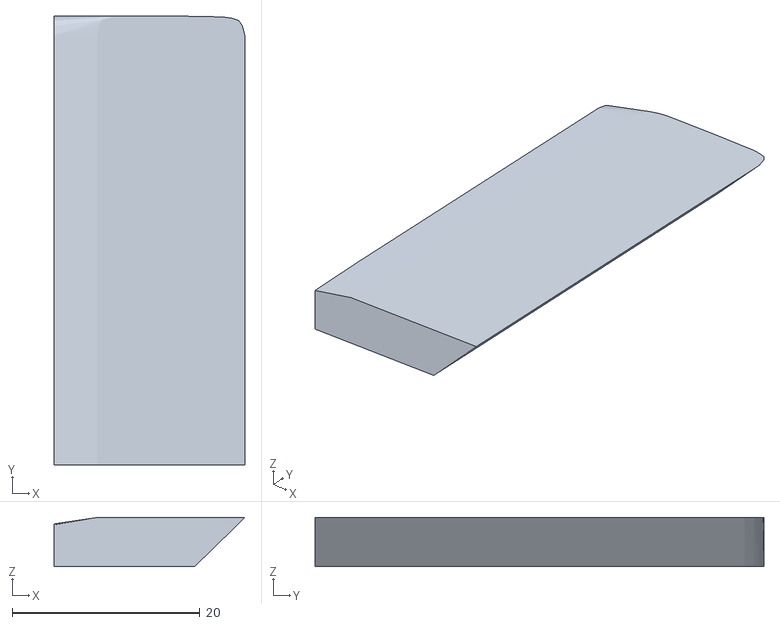
[picture p66: CAD file, 2026-09-22]
assets/cartesian_hand/meshes/collision_pieces/base_47.obj
20.3 x 47.9 x 5.23
