generalroboticslab/Cartesian_Hand/assets/cartesian_hand/meshes/collision_pieces/base_57.obj

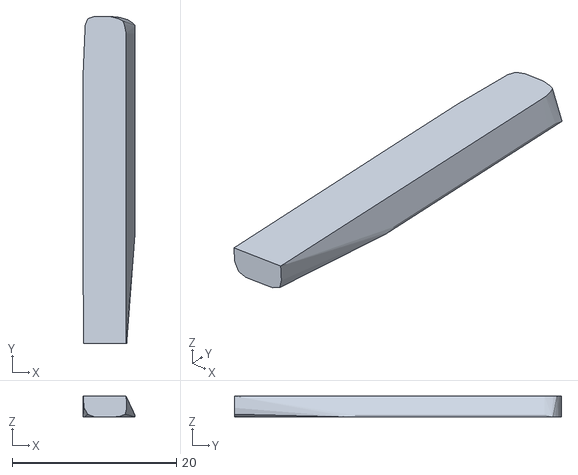
[picture p67: CAD file, 2026-09-22]
assets/cartesian_hand/meshes/collision_pieces/base_57.obj
6.38 x 39.8 x 2.54
