generalroboticslab/Cartesian_Hand/assets/cartesian_hand/meshes/collision_pieces/base_46.obj

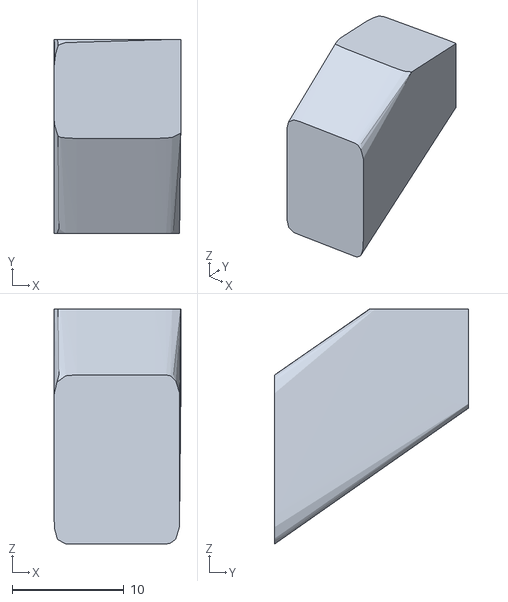
[picture p68: CAD file, 2026-09-22]
assets/cartesian_hand/meshes/collision_pieces/base_46.obj
11.3 x 17.4 x 21.1
