generalroboticslab/Cartesian_Hand/assets/cartesian_hand/meshes/collision_pieces/base_09.obj

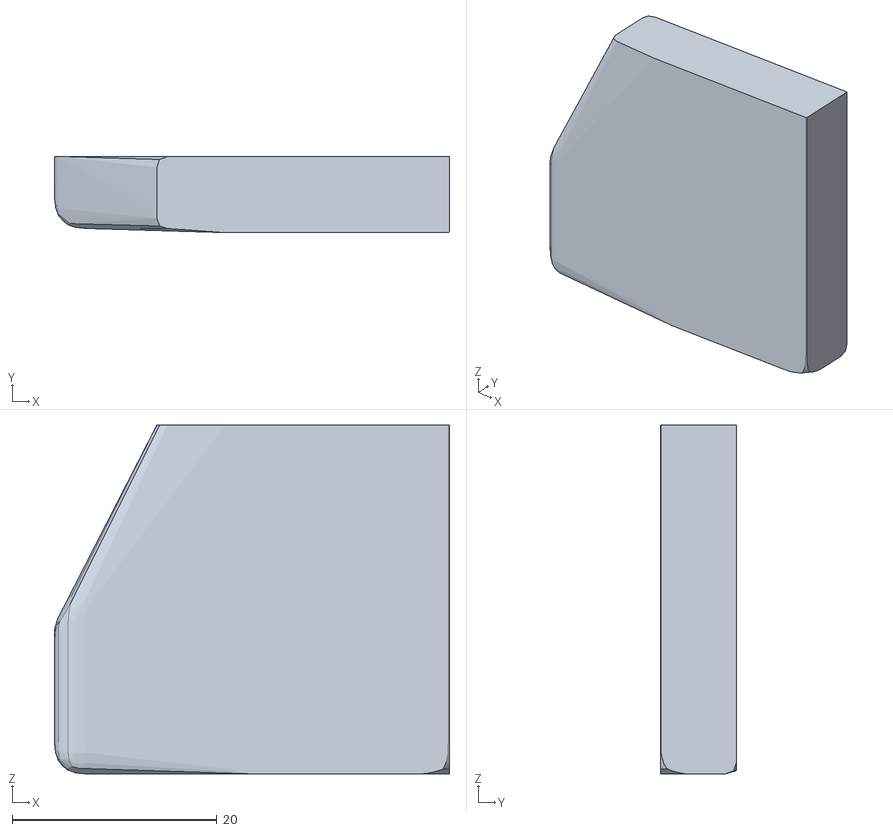
[picture p69: CAD file, 2026-09-22]
assets/cartesian_hand/meshes/collision_pieces/base_09.obj
38.6 x 7.46 x 34.1
