generalroboticslab/Cartesian_Hand/assets/cartesian_hand/meshes/collision_pieces/base_13.obj

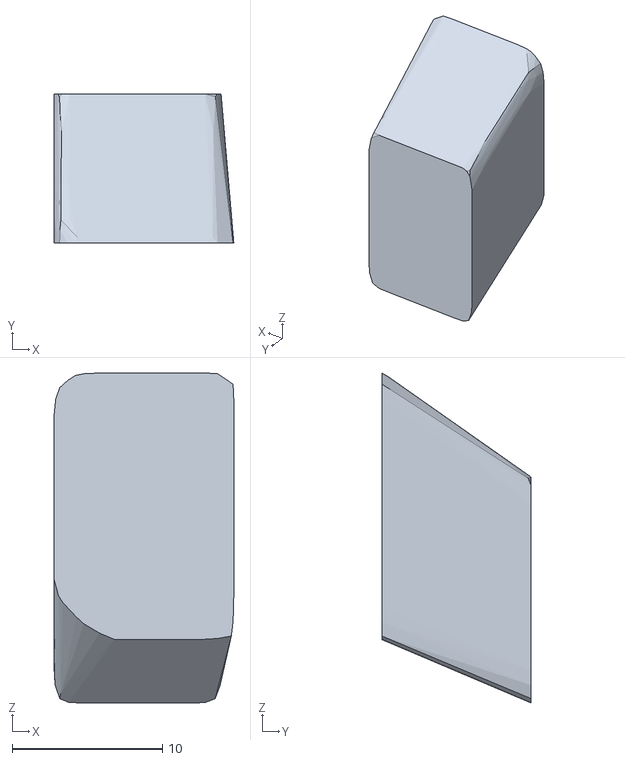
[picture p70: CAD file, 2026-09-22]
assets/cartesian_hand/meshes/collision_pieces/base_13.obj
11.9 x 9.92 x 21.9
