generalroboticslab/Cartesian_Hand/assets/cartesian_hand/meshes/collision_pieces/base_81.obj

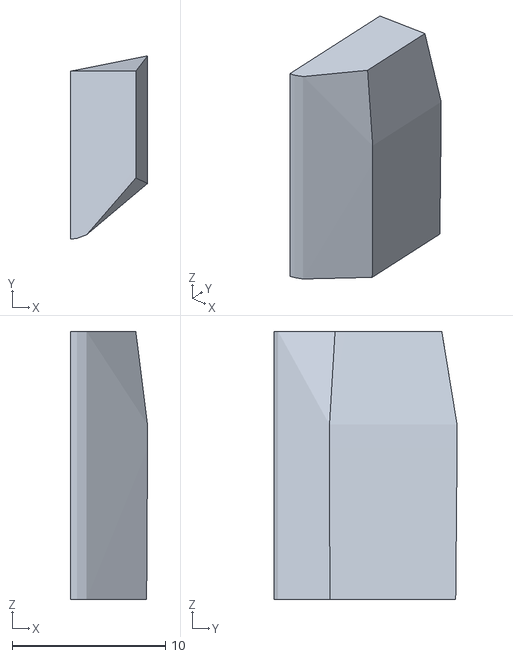
[picture p71: CAD file, 2026-09-22]
assets/cartesian_hand/meshes/collision_pieces/base_81.obj
5.04 x 12.0 x 17.5
