generalroboticslab/Cartesian_Hand/assets/cartesian_hand/meshes/collision_pieces/base_54.obj

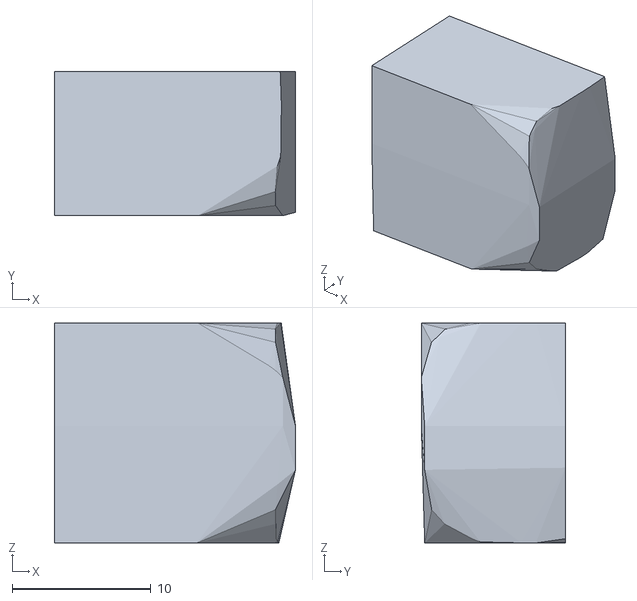
[picture p72: CAD file, 2026-09-22]
assets/cartesian_hand/meshes/collision_pieces/base_54.obj
17.4 x 10.4 x 15.9
