generalroboticslab/Cartesian_Hand/assets/cartesian_hand/meshes/collision_pieces/base_40.obj

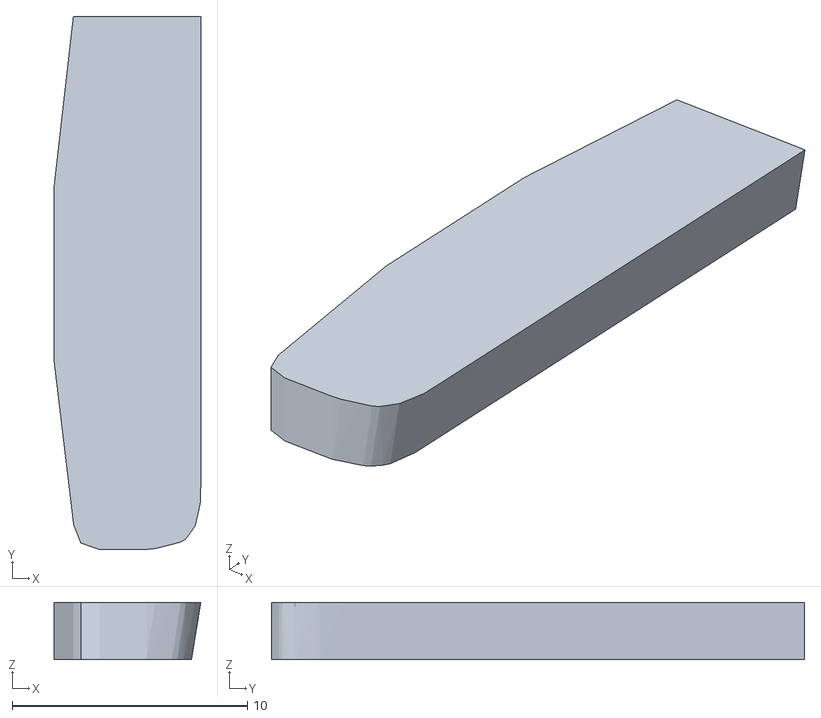
[picture p73: CAD file, 2026-09-22]
assets/cartesian_hand/meshes/collision_pieces/base_40.obj
6.24 x 22.7 x 2.43
