generalroboticslab/Cartesian_Hand/assets/cartesian_hand/meshes/collision_pieces/base_72.obj

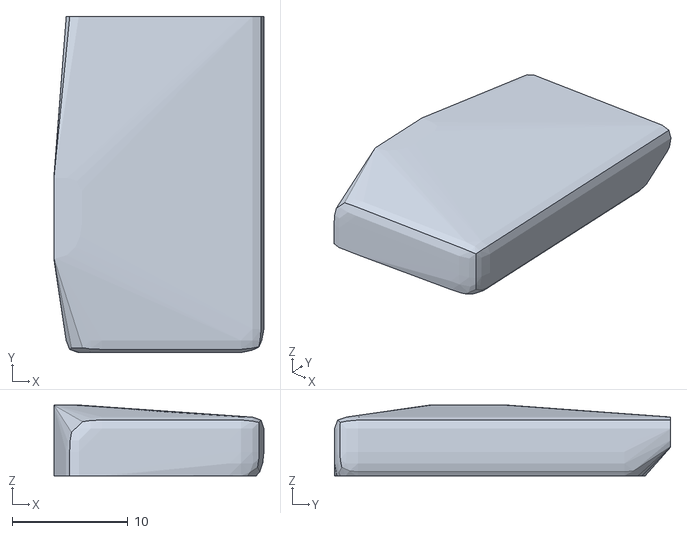
[picture p74: CAD file, 2026-09-22]
assets/cartesian_hand/meshes/collision_pieces/base_72.obj
18.1 x 29.0 x 6.09
