generalroboticslab/Cartesian_Hand/assets/cartesian_hand/meshes/collision_pieces/bridge_04.obj

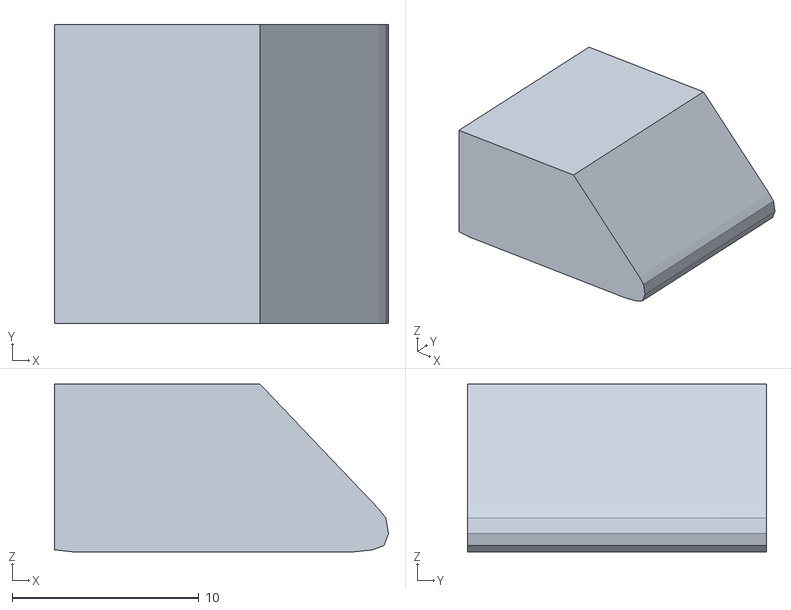
[picture p75: CAD file, 2026-09-22]
assets/cartesian_hand/meshes/collision_pieces/bridge_04.obj
17.9 x 16.0 x 8.97
