generalroboticslab/Cartesian_Hand/assets/cartesian_hand/meshes/collision_pieces/base_71.obj

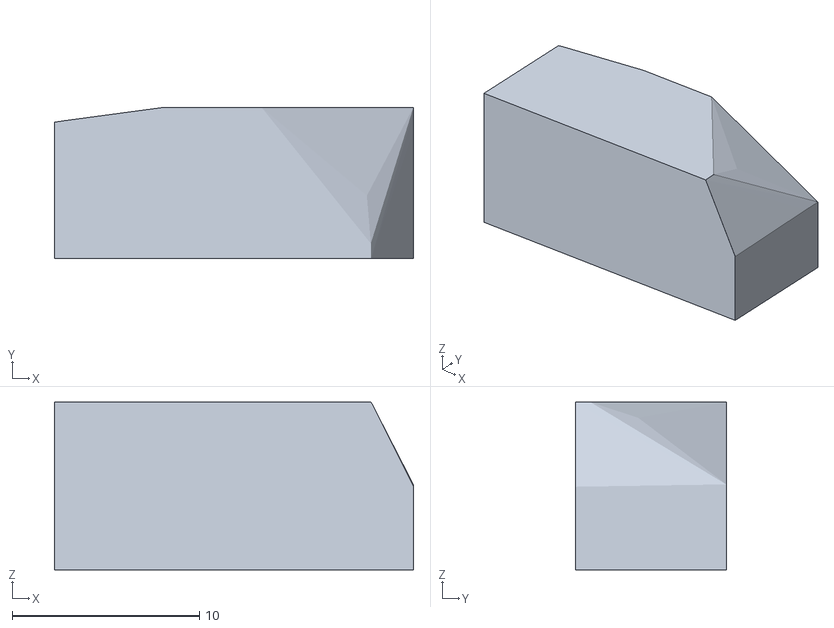
[picture p76: CAD file, 2026-09-22]
assets/cartesian_hand/meshes/collision_pieces/base_71.obj
19.2 x 8.09 x 8.96
