generalroboticslab/Cartesian_Hand/assets/cartesian_hand/meshes/collision_pieces/bridge_07.obj

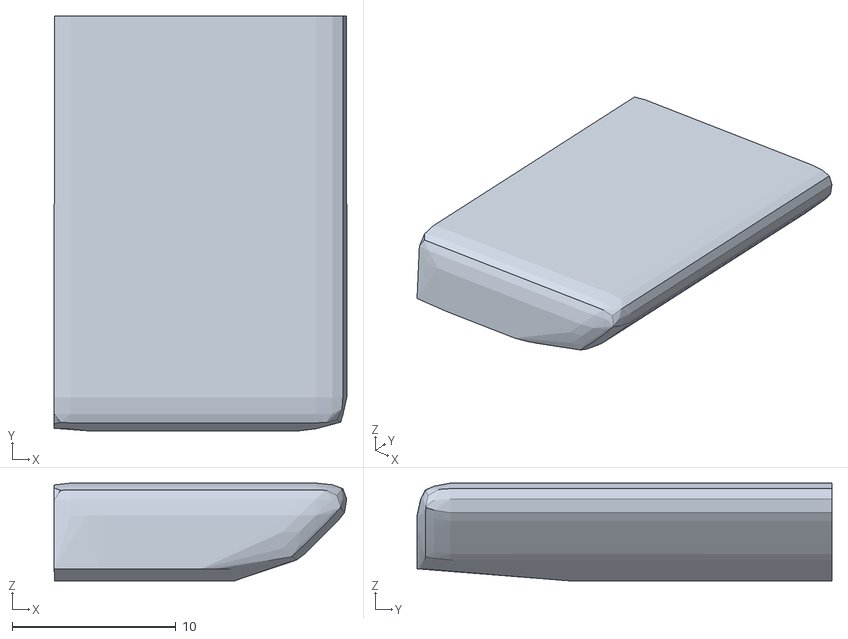
[picture p77: CAD file, 2026-09-22]
assets/cartesian_hand/meshes/collision_pieces/bridge_07.obj
17.9 x 25.3 x 5.98
