generalroboticslab/Cartesian_Hand/assets/cartesian_hand/meshes/collision_pieces/base_78.obj

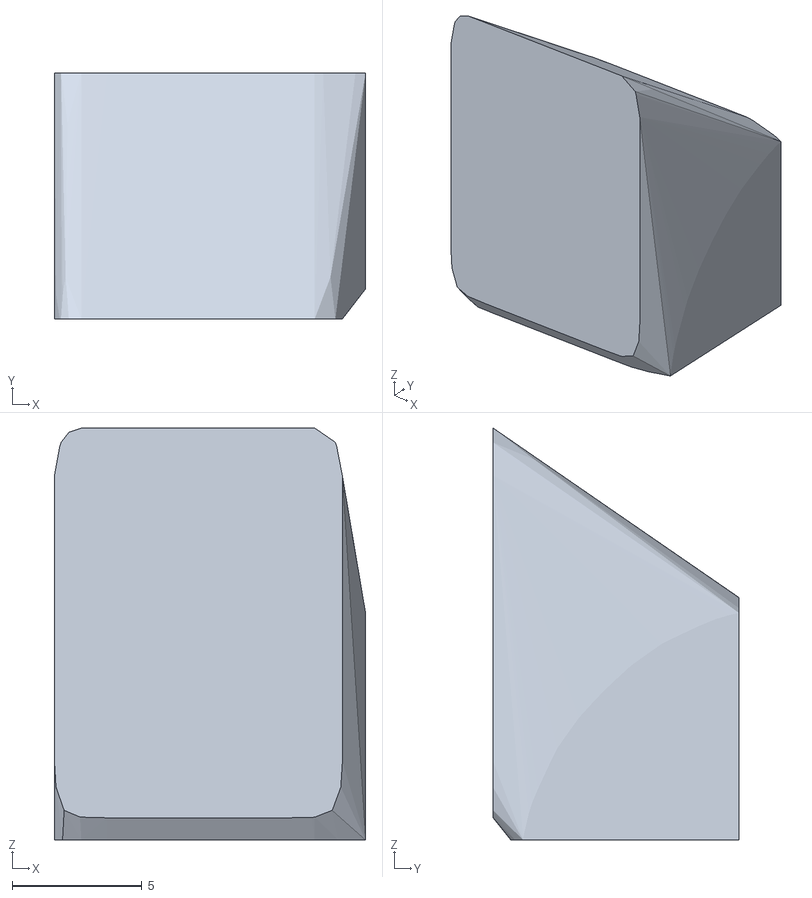
[picture p78: CAD file, 2026-09-22]
assets/cartesian_hand/meshes/collision_pieces/base_78.obj
12.0 x 9.48 x 15.9
