generalroboticslab/Cartesian_Hand/assets/cartesian_hand/meshes/collision_pieces/base_41.obj

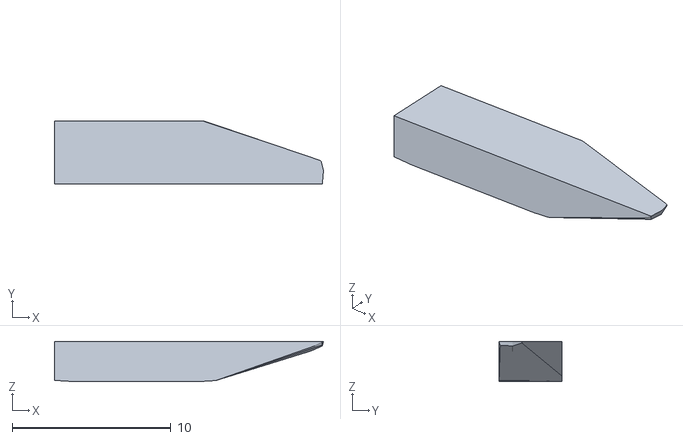
[picture p79: CAD file, 2026-09-22]
assets/cartesian_hand/meshes/collision_pieces/base_41.obj
17.0 x 3.95 x 2.53
