generalroboticslab/Cartesian_Hand/assets/cartesian_hand/meshes/collision_pieces/base_30.obj

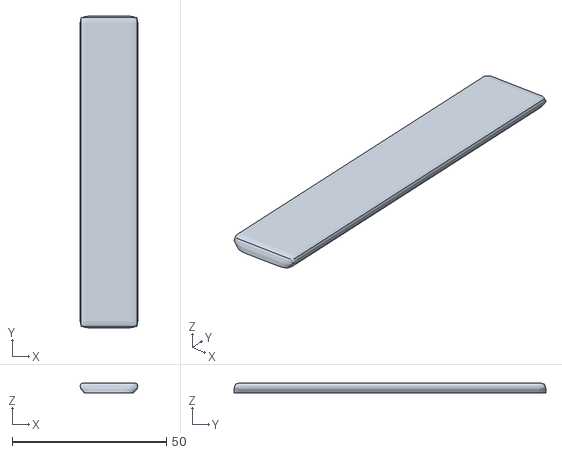
[picture p80: CAD file, 2026-09-22]
assets/cartesian_hand/meshes/collision_pieces/base_30.obj
18.7 x 101.1 x 3.32
