generalroboticslab/Cartesian_Hand/assets/cartesian_hand/meshes/collision_pieces/base_00.obj

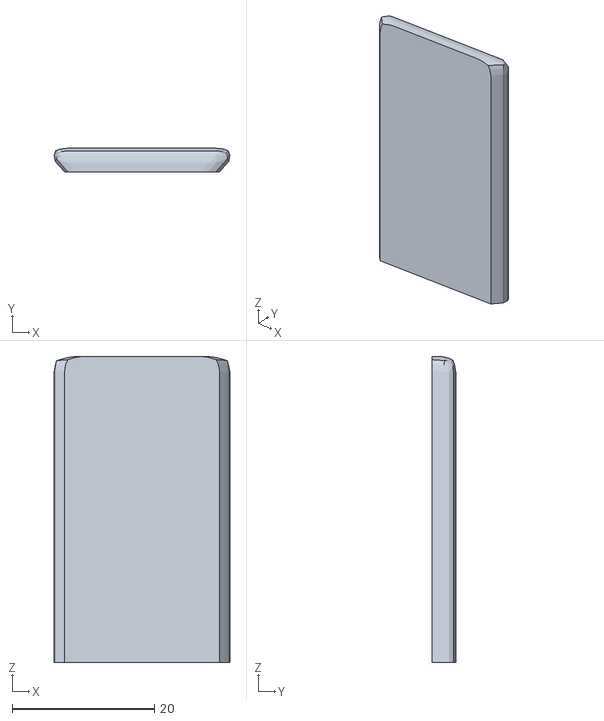
[picture p81: CAD file, 2026-09-22]
assets/cartesian_hand/meshes/collision_pieces/base_00.obj
24.7 x 3.31 x 43.1
