generalroboticslab/Cartesian_Hand/assets/cartesian_hand/meshes/collision_pieces/bridge_22.obj

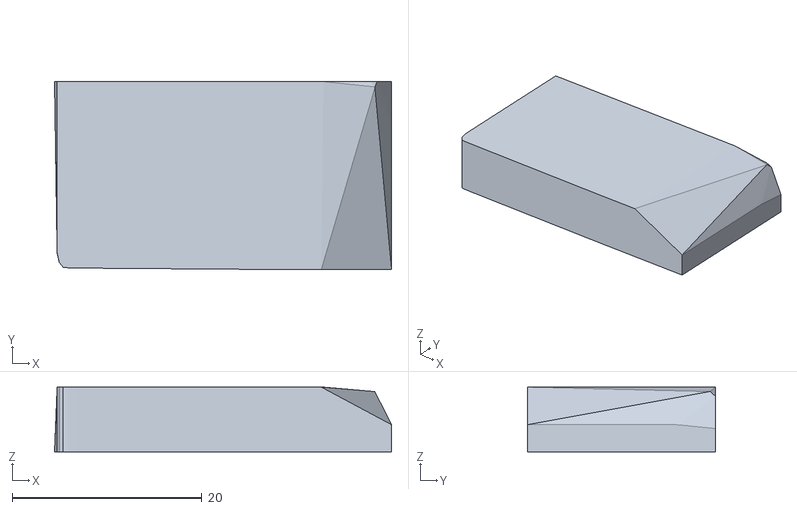
[picture p82: CAD file, 2026-09-22]
assets/cartesian_hand/meshes/collision_pieces/bridge_22.obj
35.5 x 19.8 x 6.82
