generalroboticslab/Cartesian_Hand/assets/cartesian_hand/meshes/collision_pieces/base_20.obj

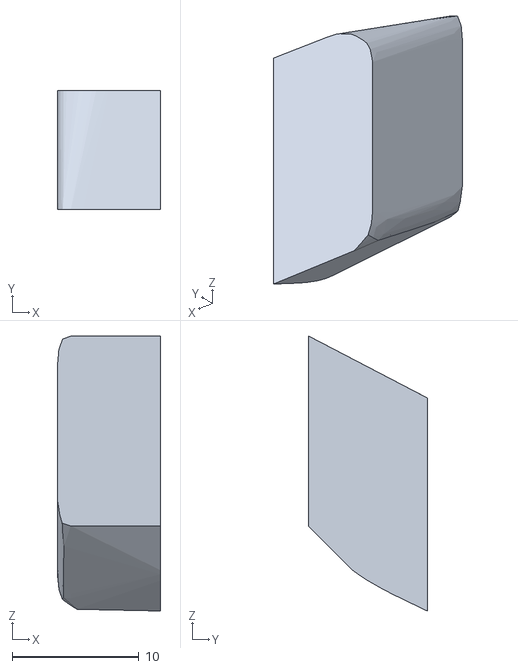
[picture p83: CAD file, 2026-09-22]
assets/cartesian_hand/meshes/collision_pieces/base_20.obj
8.10 x 9.39 x 21.7
