generalroboticslab/Cartesian_Hand/assets/cartesian_hand/meshes/collision_pieces/bridge_59.obj

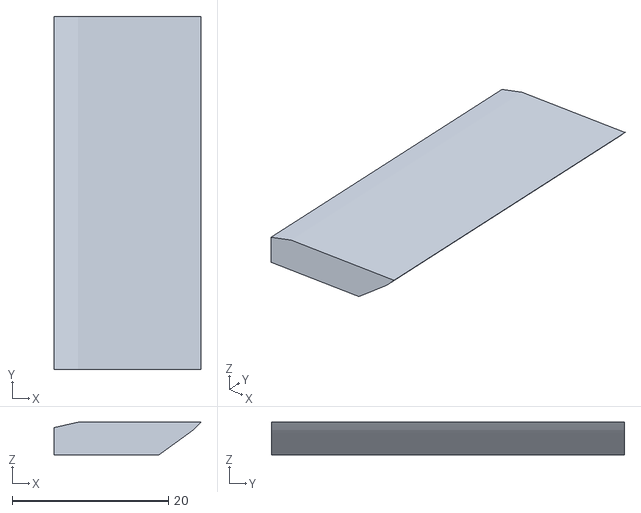
[picture p84: CAD file, 2026-09-22]
assets/cartesian_hand/meshes/collision_pieces/bridge_59.obj
18.8 x 45.2 x 4.18
