generalroboticslab/Cartesian_Hand/assets/cartesian_hand/meshes/collision_pieces/base_37.obj

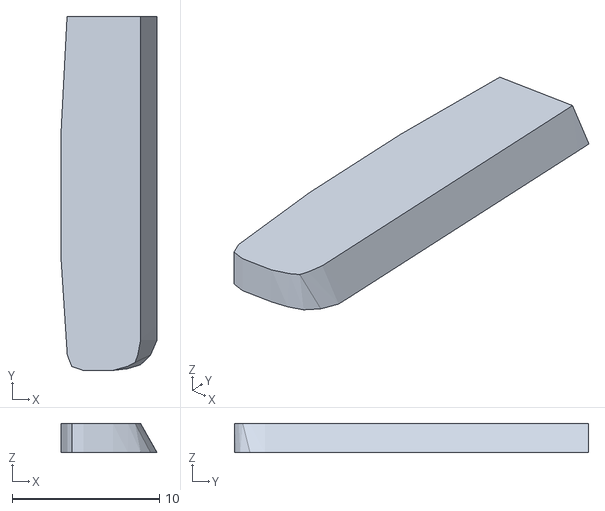
[picture p85: CAD file, 2026-09-22]
assets/cartesian_hand/meshes/collision_pieces/base_37.obj
6.54 x 24.0 x 1.99
