generalroboticslab/Cartesian_Hand/assets/cartesian_hand/meshes/collision_pieces/base_58.obj

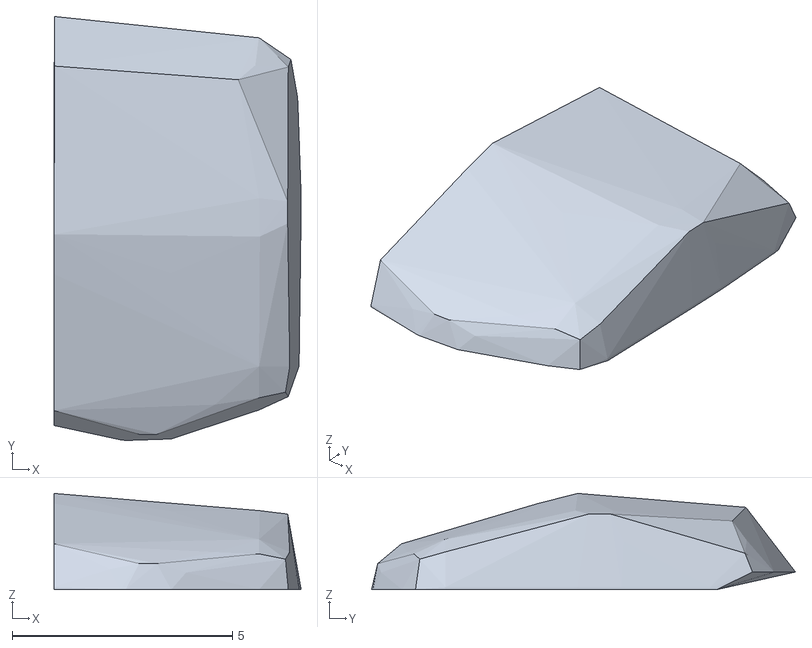
[picture p86: CAD file, 2026-09-22]
assets/cartesian_hand/meshes/collision_pieces/base_58.obj
5.60 x 9.62 x 2.18
