generalroboticslab/Cartesian_Hand/assets/cartesian_hand/meshes/collision_pieces/bridge_46.obj

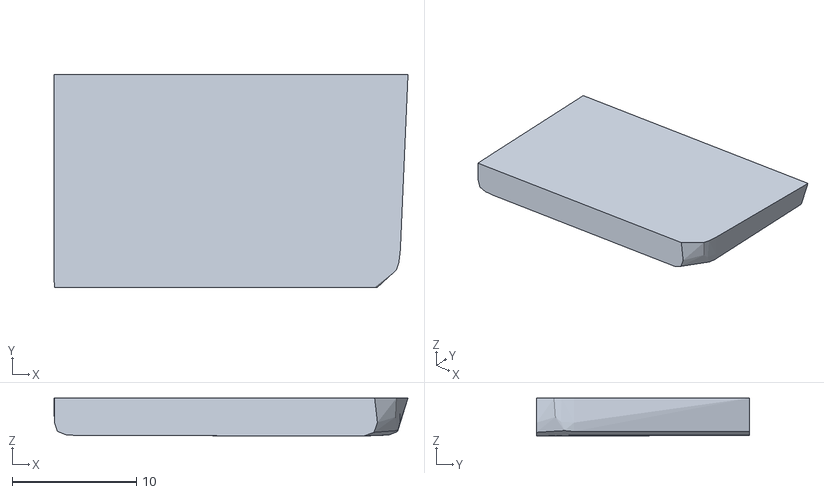
[picture p87: CAD file, 2026-09-22]
assets/cartesian_hand/meshes/collision_pieces/bridge_46.obj
28.5 x 17.1 x 3.04
