generalroboticslab/Cartesian_Hand/assets/cartesian_hand/meshes/collision_pieces/base_03.obj

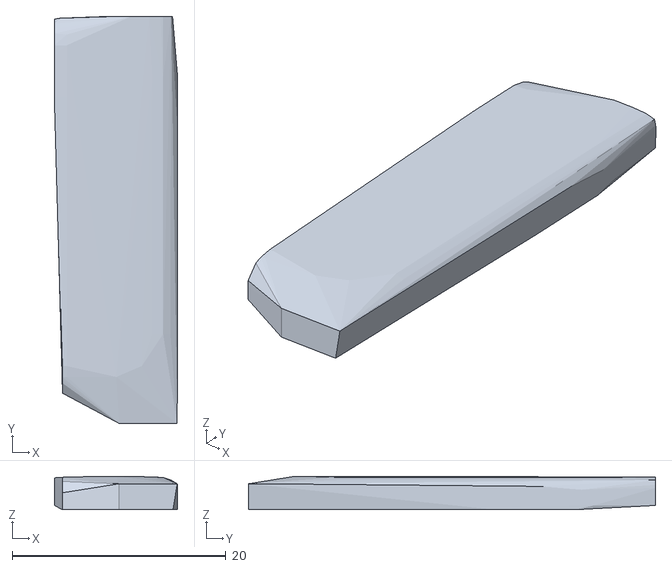
[picture p88: CAD file, 2026-09-22]
assets/cartesian_hand/meshes/collision_pieces/base_03.obj
11.5 x 38.0 x 3.13
