generalroboticslab/Cartesian_Hand/assets/cartesian_hand/meshes/collision_pieces/base_10.obj

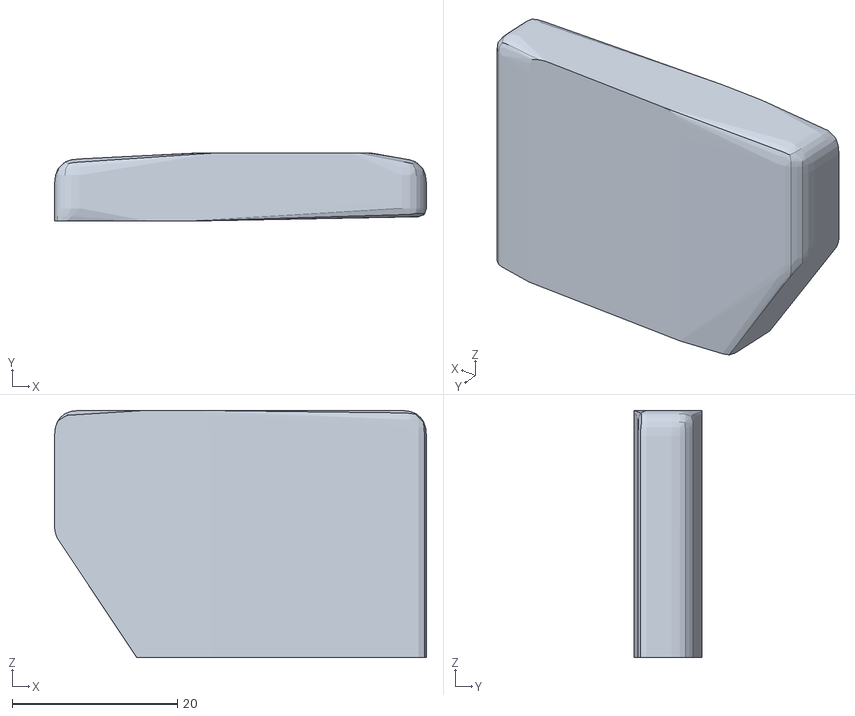
[picture p89: CAD file, 2026-09-22]
assets/cartesian_hand/meshes/collision_pieces/base_10.obj
45.0 x 8.18 x 29.9
