generalroboticslab/Cartesian_Hand/assets/cartesian_hand/meshes/collision_pieces/bridge_29.obj

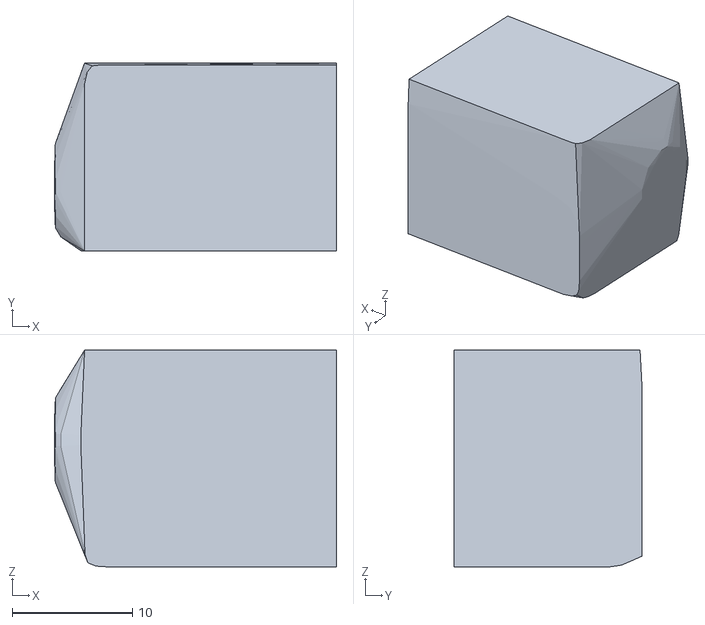
[picture p90: CAD file, 2026-09-22]
assets/cartesian_hand/meshes/collision_pieces/bridge_29.obj
23.4 x 15.6 x 18.0
