generalroboticslab/Cartesian_Hand/assets/cartesian_hand/meshes/collision_pieces/base_16.obj

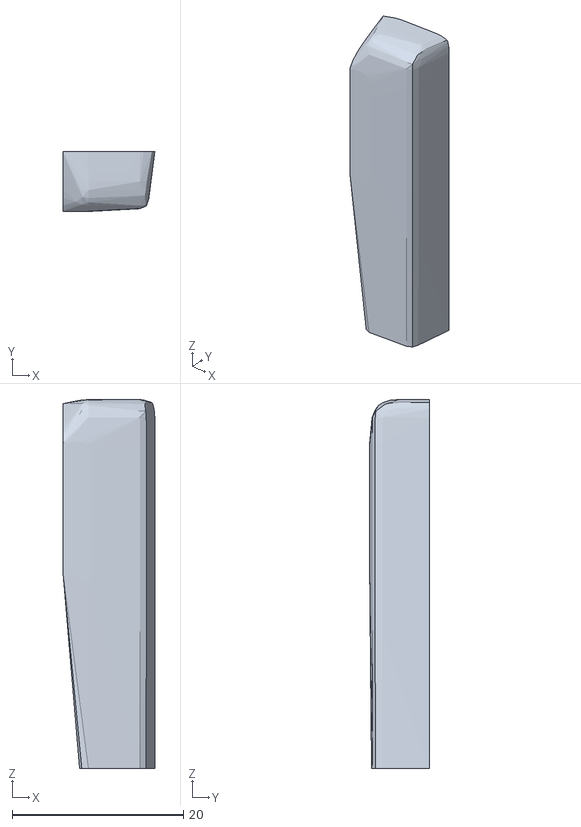
[picture p91: CAD file, 2026-09-22]
assets/cartesian_hand/meshes/collision_pieces/base_16.obj
10.7 x 6.95 x 43.1
