generalroboticslab/Cartesian_Hand/assets/cartesian_hand/meshes/collision_pieces/bridge_60.obj

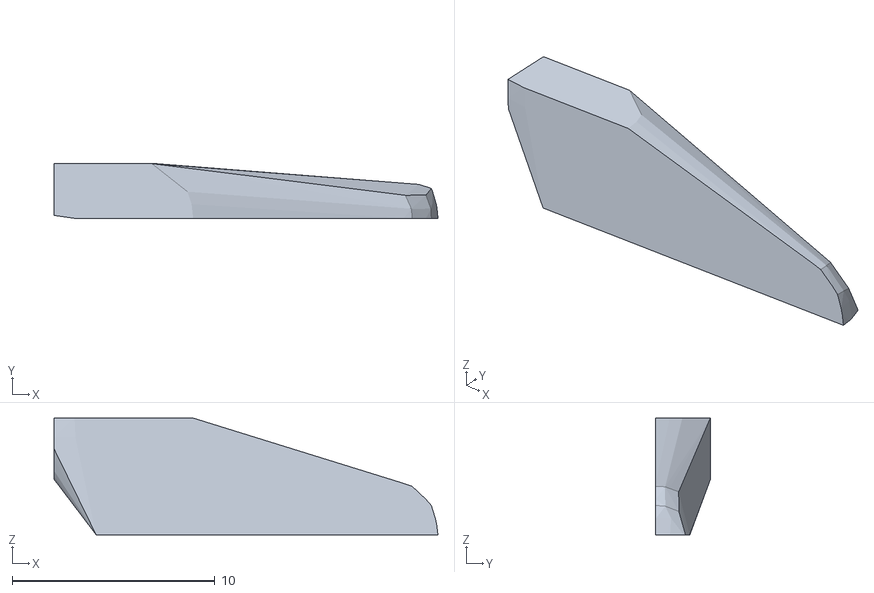
[picture p92: CAD file, 2026-09-22]
assets/cartesian_hand/meshes/collision_pieces/bridge_60.obj
18.9 x 2.69 x 5.76
