generalroboticslab/Cartesian_Hand/assets/cartesian_hand/meshes/collision_pieces/base_73.obj

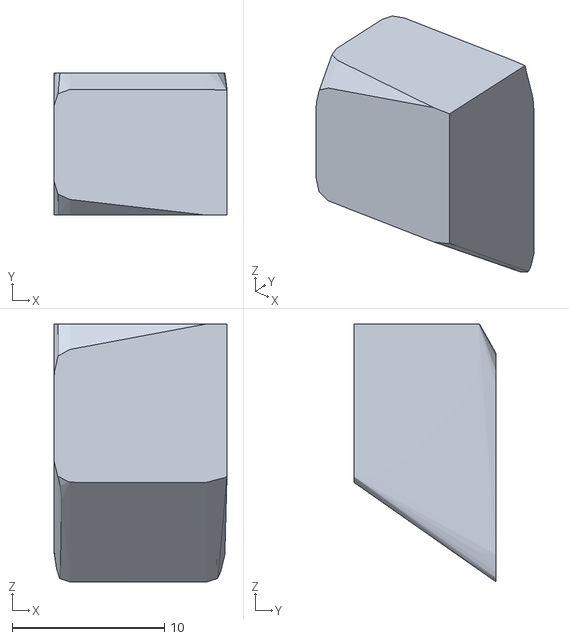
[picture p93: CAD file, 2026-09-22]
assets/cartesian_hand/meshes/collision_pieces/base_73.obj
11.4 x 9.35 x 16.9
