generalroboticslab/Cartesian_Hand/assets/cartesian_hand/meshes/collision_pieces/bridge_57.obj

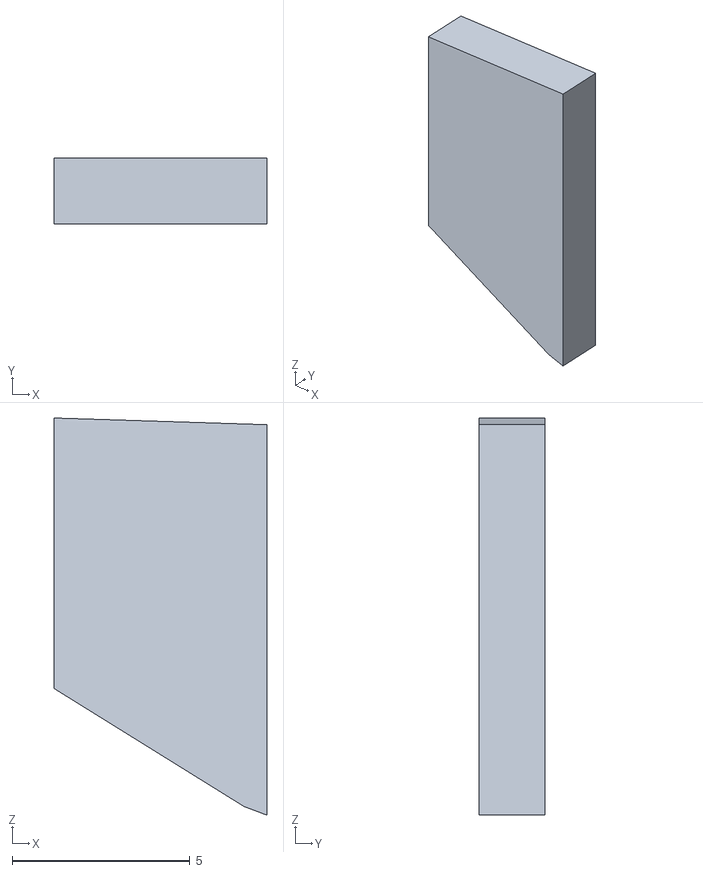
[picture p94: CAD file, 2026-09-22]
assets/cartesian_hand/meshes/collision_pieces/bridge_57.obj
5.98 x 1.85 x 11.2
