generalroboticslab/Cartesian_Hand/assets/cartesian_hand/meshes/collision_pieces/base_52.obj

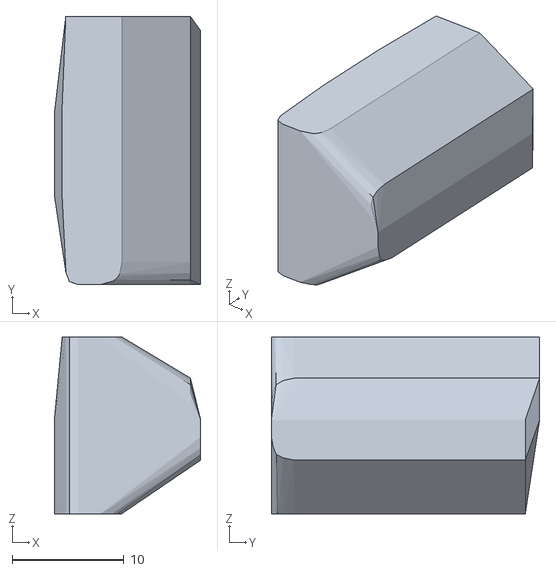
[picture p95: CAD file, 2026-09-22]
assets/cartesian_hand/meshes/collision_pieces/base_52.obj
13.1 x 24.0 x 15.9
