generalroboticslab/Cartesian_Hand/assets/cartesian_hand/meshes/collision_pieces/base_82.obj

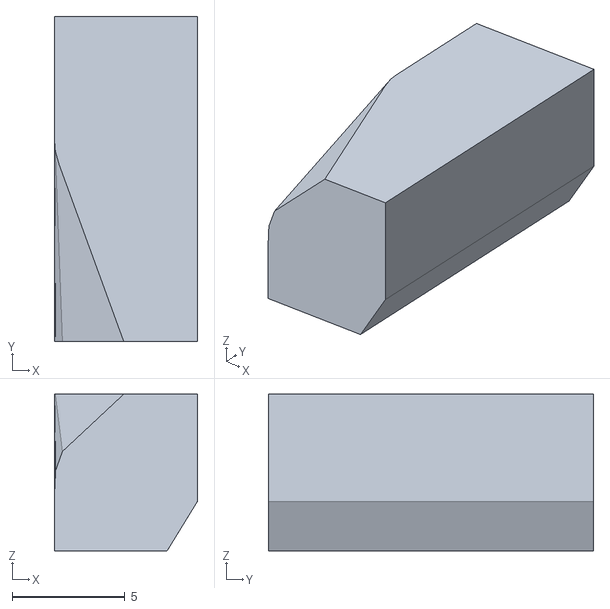
[picture p96: CAD file, 2026-09-22]
assets/cartesian_hand/meshes/collision_pieces/base_82.obj
6.35 x 14.4 x 6.95
