generalroboticslab/Cartesian_Hand/assets/cartesian_hand/meshes/collision_pieces/base_59.obj

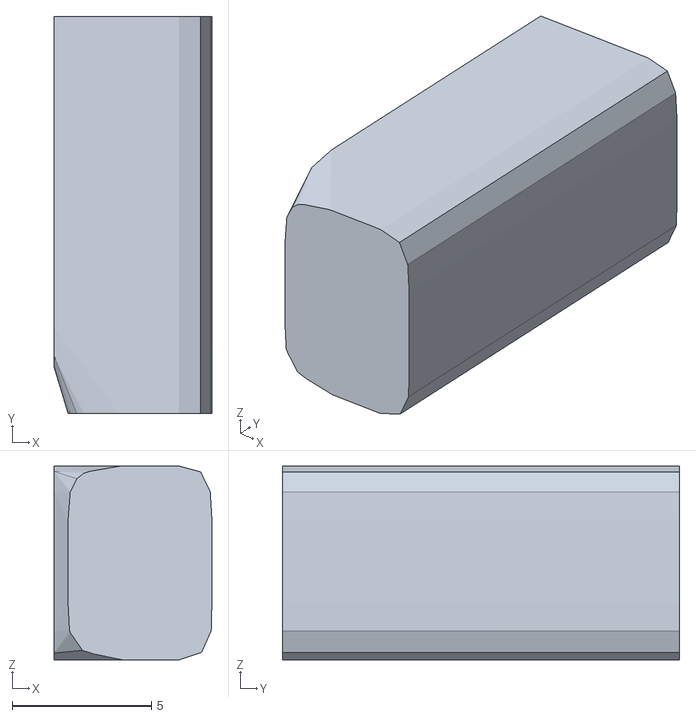
[picture p97: CAD file, 2026-09-22]
assets/cartesian_hand/meshes/collision_pieces/base_59.obj
5.68 x 14.3 x 6.98
