generalroboticslab/Cartesian_Hand/assets/cartesian_hand/meshes/collision_pieces/bridge_02.obj

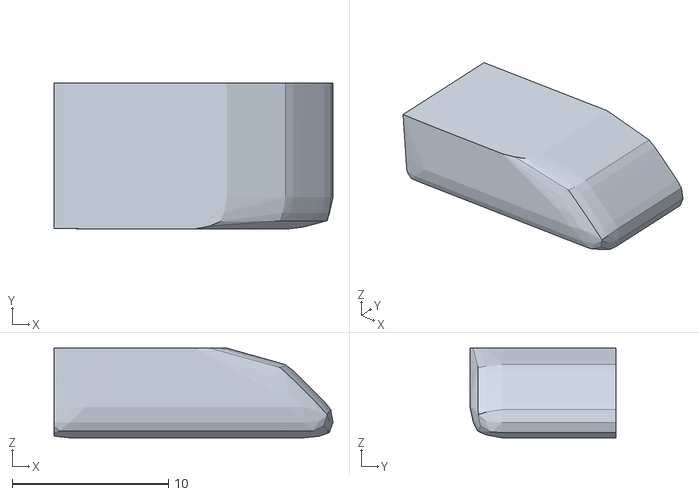
[picture p98: CAD file, 2026-09-22]
assets/cartesian_hand/meshes/collision_pieces/bridge_02.obj
17.9 x 9.37 x 5.75
