generalroboticslab/Cartesian_Hand/assets/cartesian_hand/meshes/collision_pieces/bridge_76.obj

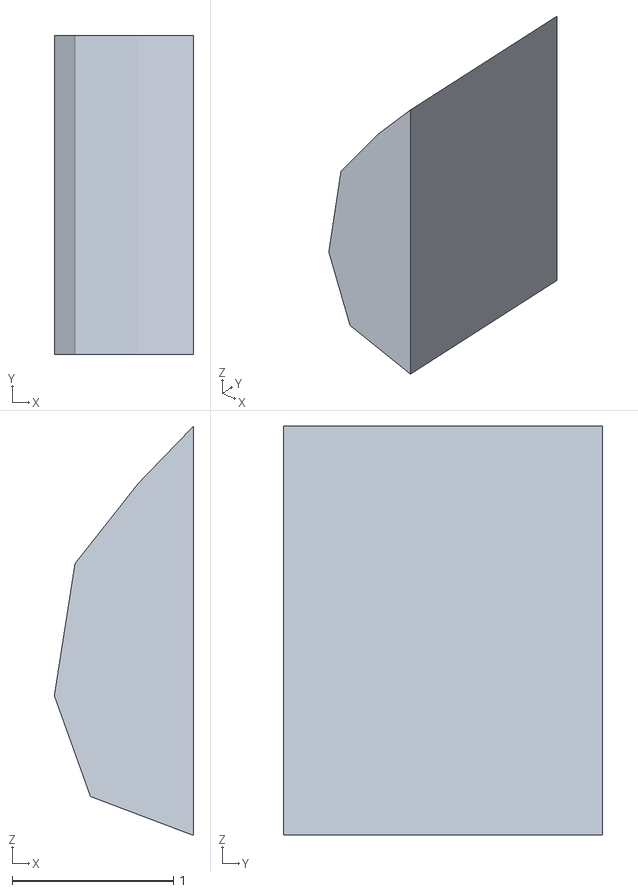
[picture p99: CAD file, 2026-09-22]
assets/cartesian_hand/meshes/collision_pieces/bridge_76.obj
0.865 x 1.98 x 2.54
