generalroboticslab/Cartesian_Hand/assets/cartesian_hand/meshes/collision_pieces/bridge_77.obj

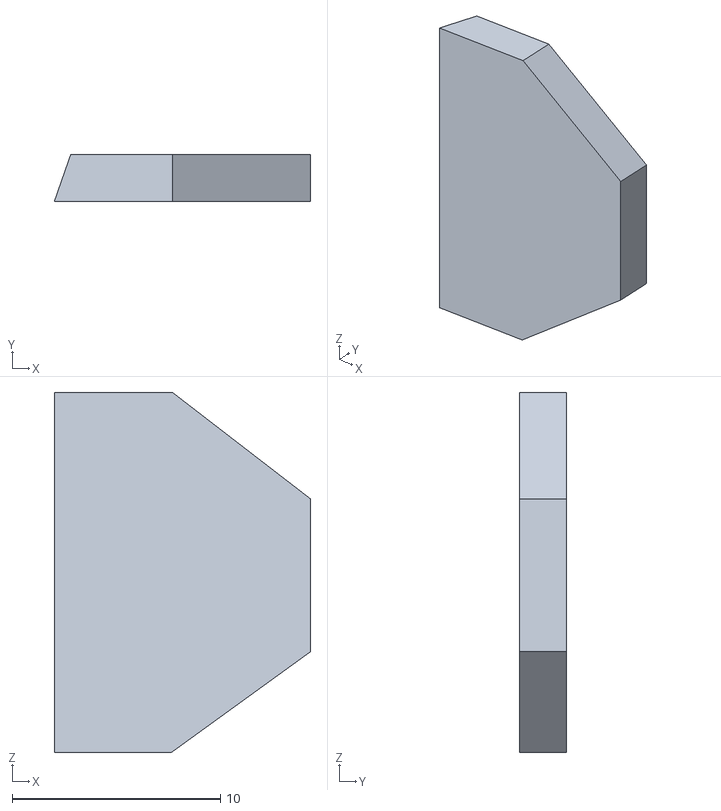
[picture p100: CAD file, 2026-09-22]
assets/cartesian_hand/meshes/collision_pieces/bridge_77.obj
12.3 x 2.24 x 17.3
