generalroboticslab/Cartesian_Hand/assets/cartesian_hand/meshes/collision_pieces/bridge_63.obj

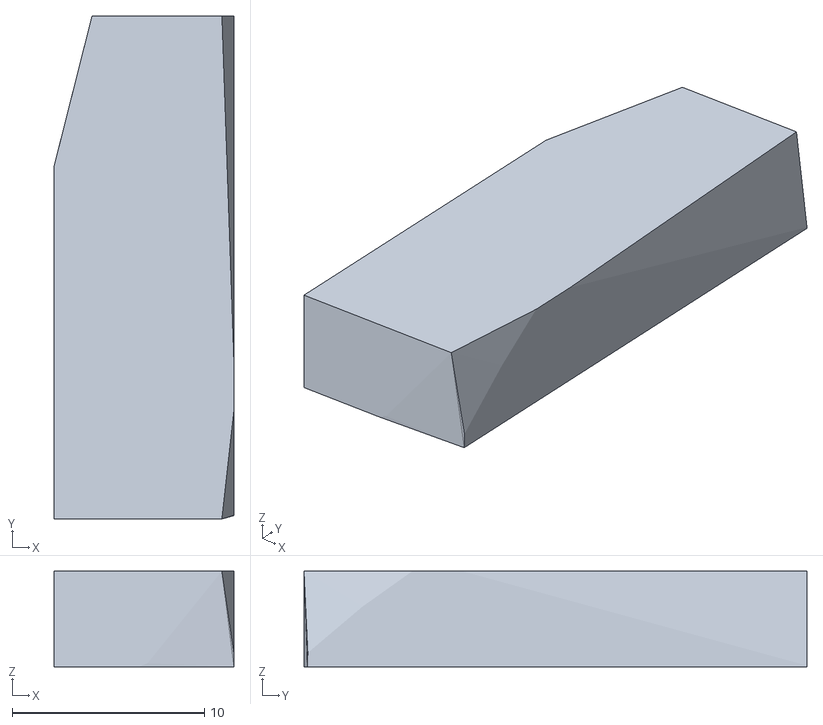
[picture p101: CAD file, 2026-09-22]
assets/cartesian_hand/meshes/collision_pieces/bridge_63.obj
9.34 x 26.1 x 4.98
