generalroboticslab/Cartesian_Hand/assets/cartesian_hand/meshes/collision_pieces/bridge_50.obj

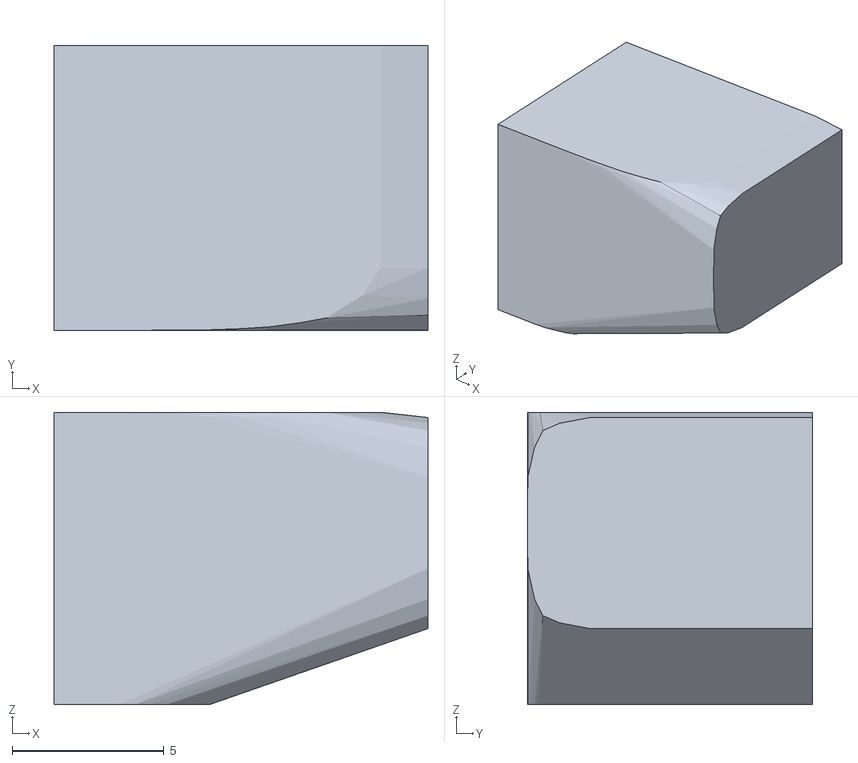
[picture p102: CAD file, 2026-09-22]
assets/cartesian_hand/meshes/collision_pieces/bridge_50.obj
12.3 x 9.37 x 9.63
