generalroboticslab/Cartesian_Hand/assets/cartesian_hand/meshes/collision_pieces/base_68.obj

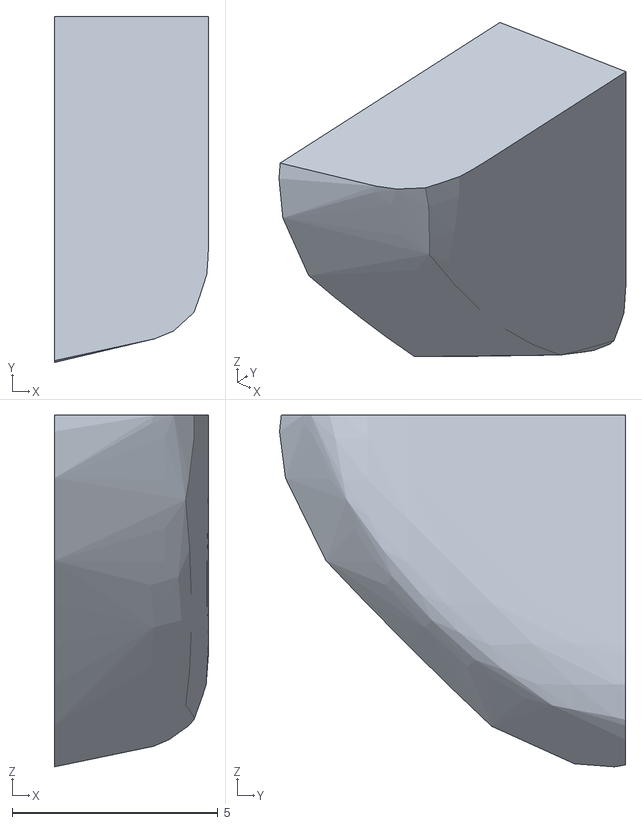
[picture p103: CAD file, 2026-09-22]
assets/cartesian_hand/meshes/collision_pieces/base_68.obj
3.75 x 8.41 x 8.55
