generalroboticslab/Cartesian_Hand/assets/cartesian_hand/meshes/collision_pieces/bridge_58.obj

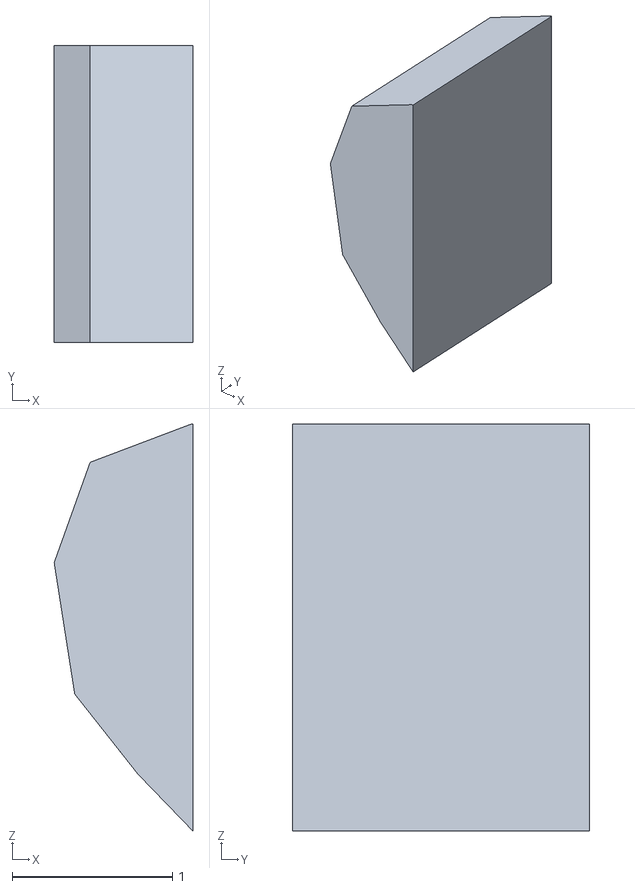
[picture p104: CAD file, 2026-09-22]
assets/cartesian_hand/meshes/collision_pieces/bridge_58.obj
0.865 x 1.85 x 2.54
