generalroboticslab/Cartesian_Hand/assets/cartesian_hand/meshes/collision_pieces/base_69.obj

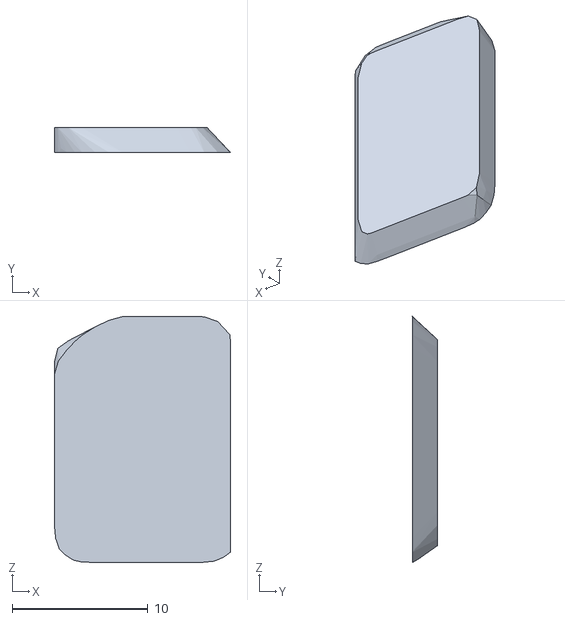
[picture p105: CAD file, 2026-09-22]
assets/cartesian_hand/meshes/collision_pieces/base_69.obj
13.0 x 1.84 x 18.1
