generalroboticslab/Cartesian_Hand/assets/cartesian_hand/meshes/collision_pieces/base_31.obj

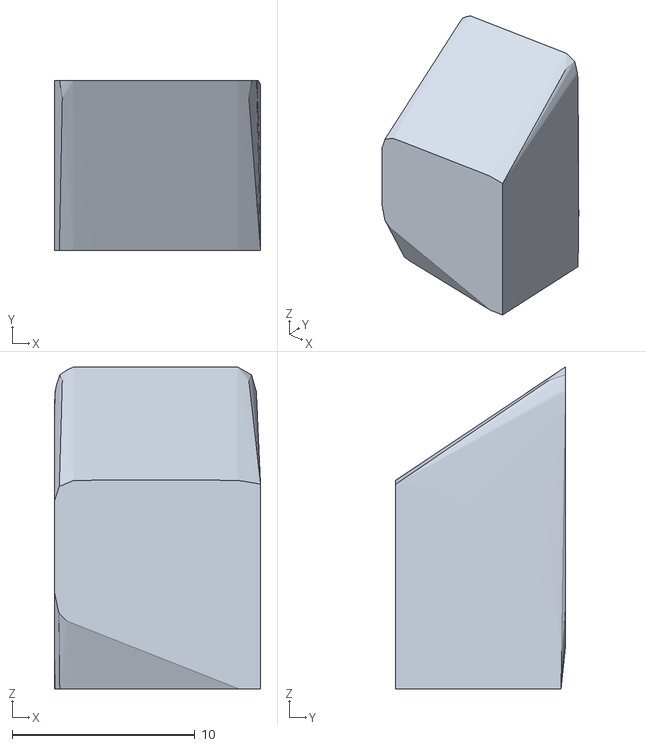
[picture p106: CAD file, 2026-09-22]
assets/cartesian_hand/meshes/collision_pieces/base_31.obj
11.3 x 9.29 x 17.6
