generalroboticslab/Cartesian_Hand/assets/cartesian_hand/meshes/collision_pieces/base_83.obj

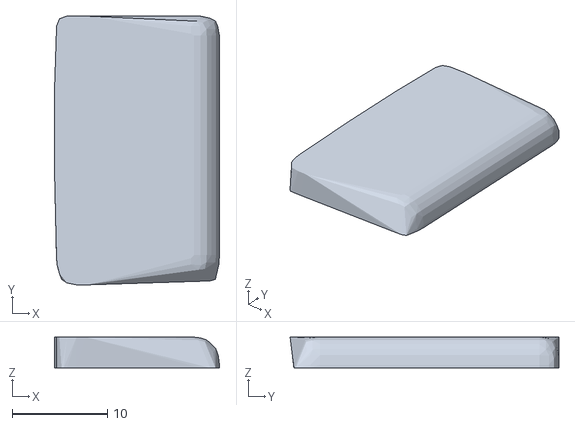
[picture p107: CAD file, 2026-09-22]
assets/cartesian_hand/meshes/collision_pieces/base_83.obj
17.3 x 28.2 x 3.22
