generalroboticslab/Cartesian_Hand/assets/cartesian_hand/meshes/collision_pieces/bridge_47.obj

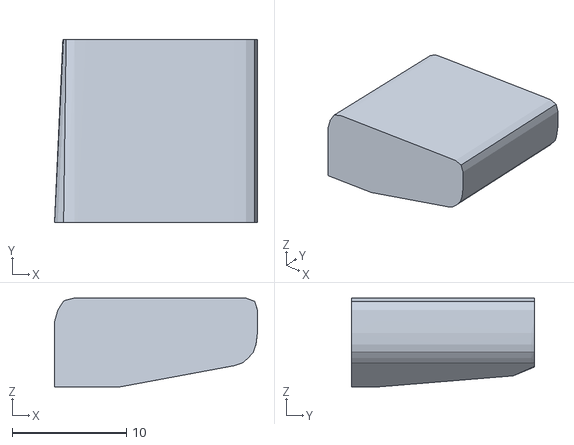
[picture p108: CAD file, 2026-09-22]
assets/cartesian_hand/meshes/collision_pieces/bridge_47.obj
17.7 x 16.0 x 7.77
