generalroboticslab/Cartesian_Hand/assets/cartesian_hand/meshes/collision_pieces/bridge_37.obj

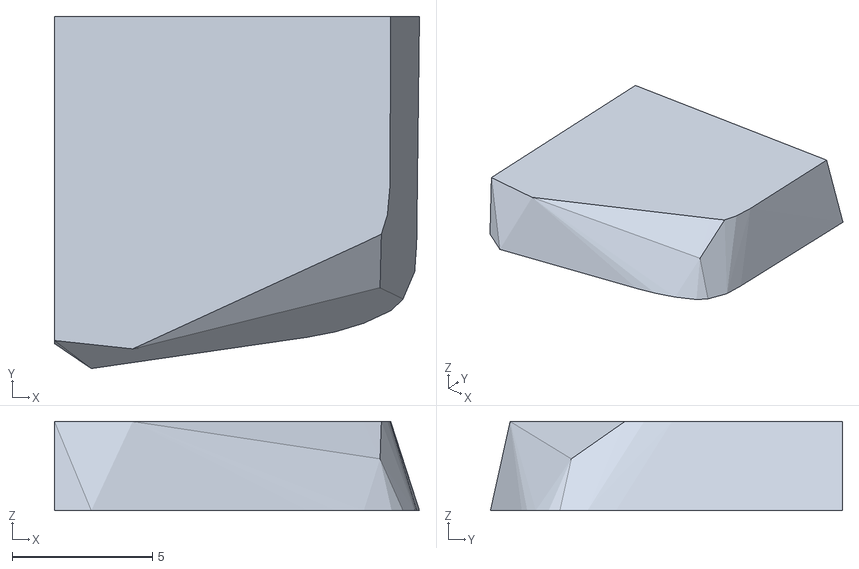
[picture p109: CAD file, 2026-09-22]
assets/cartesian_hand/meshes/collision_pieces/bridge_37.obj
13.0 x 12.5 x 3.17
