generalroboticslab/Cartesian_Hand/assets/cartesian_hand/meshes/collision_pieces/base_36.obj

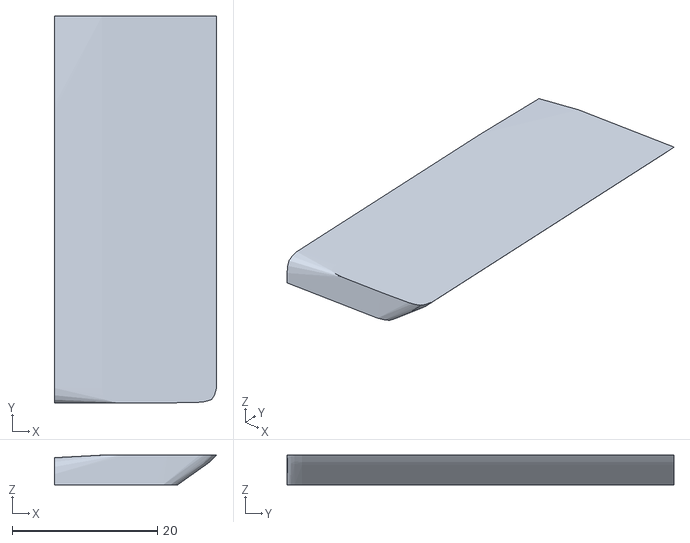
[picture p110: CAD file, 2026-09-22]
assets/cartesian_hand/meshes/collision_pieces/base_36.obj
22.3 x 53.2 x 4.09
