generalroboticslab/Cartesian_Hand/assets/cartesian_hand/meshes/collision_pieces/bridge_13.obj

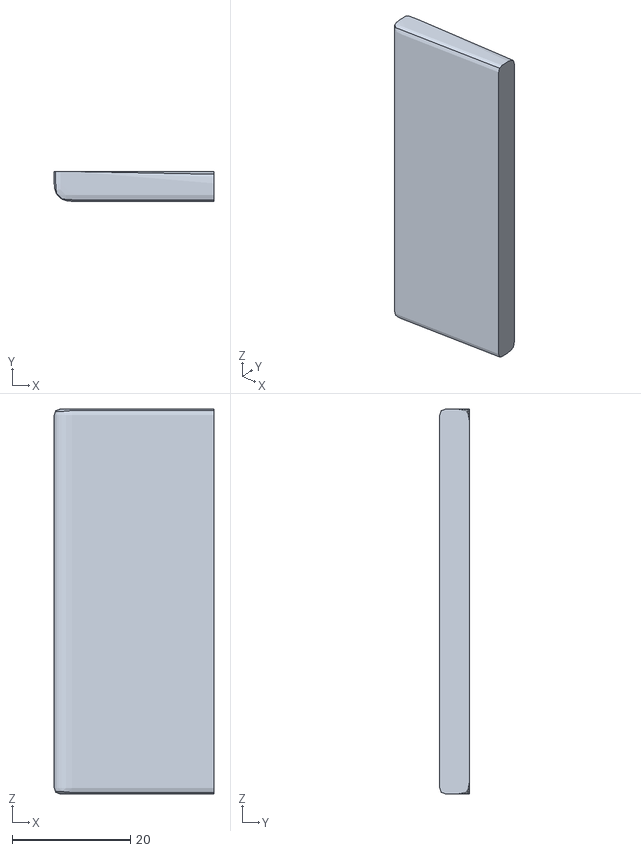
[picture p111: CAD file, 2026-09-22]
assets/cartesian_hand/meshes/collision_pieces/bridge_13.obj
27.0 x 5.03 x 65.1
