generalroboticslab/Cartesian_Hand/assets/cartesian_hand/meshes/collision_pieces/base_01.obj

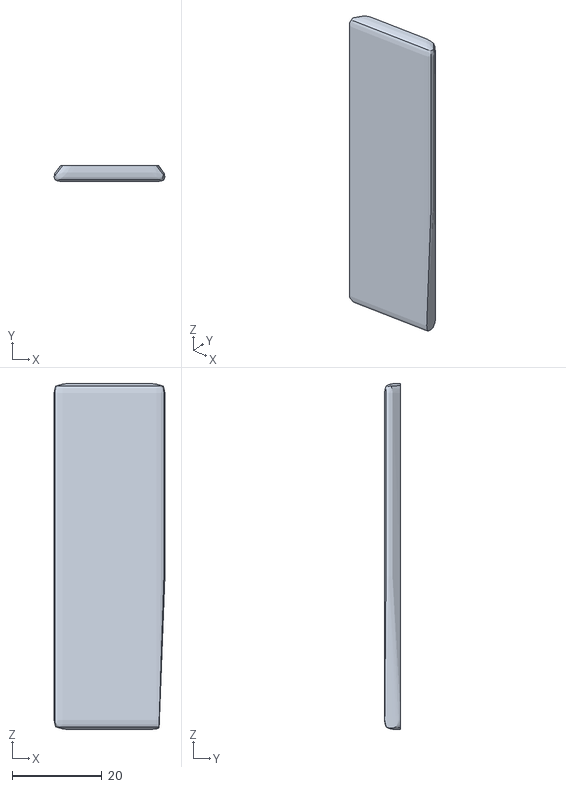
[picture p112: CAD file, 2026-09-22]
assets/cartesian_hand/meshes/collision_pieces/base_01.obj
24.7 x 3.59 x 77.2
