generalroboticslab/Cartesian_Hand/assets/cartesian_hand/meshes/collision_pieces/bridge_45.obj

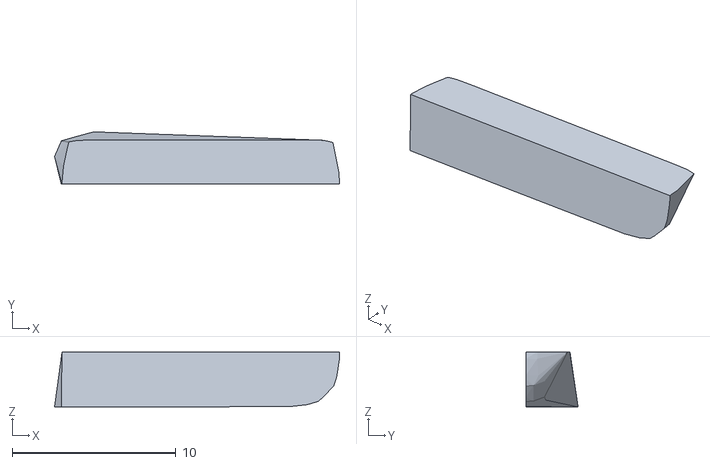
[picture p113: CAD file, 2026-09-22]
assets/cartesian_hand/meshes/collision_pieces/bridge_45.obj
17.4 x 3.19 x 3.35
