generalroboticslab/Cartesian_Hand/assets/cartesian_hand/meshes/collision_pieces/bridge_36.obj

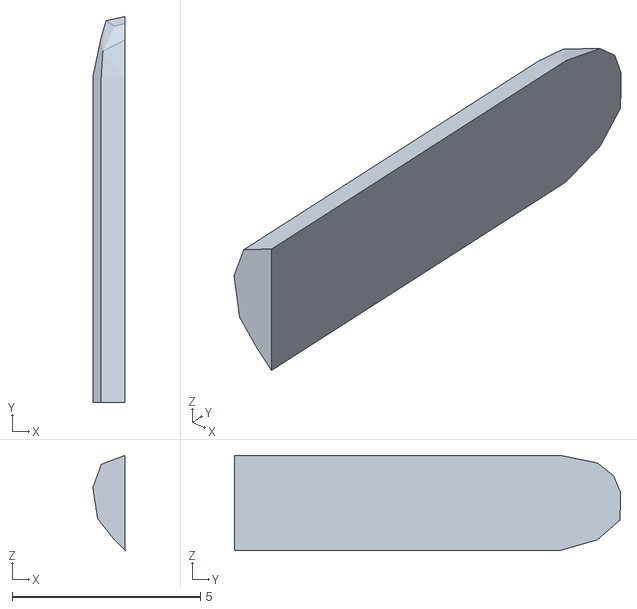
[picture p114: CAD file, 2026-09-22]
assets/cartesian_hand/meshes/collision_pieces/bridge_36.obj
0.861 x 10.3 x 2.53
