generalroboticslab/Cartesian_Hand/assets/cartesian_hand/meshes/collision_pieces/bridge_66.obj

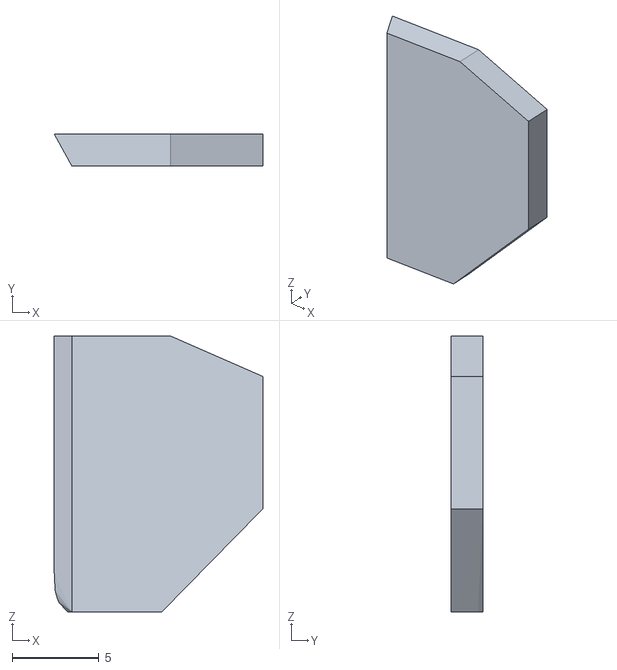
[picture p115: CAD file, 2026-09-22]
assets/cartesian_hand/meshes/collision_pieces/bridge_66.obj
12.0 x 1.85 x 15.9
