generalroboticslab/Cartesian_Hand/assets/cartesian_hand/meshes/collision_pieces/bridge_12.obj

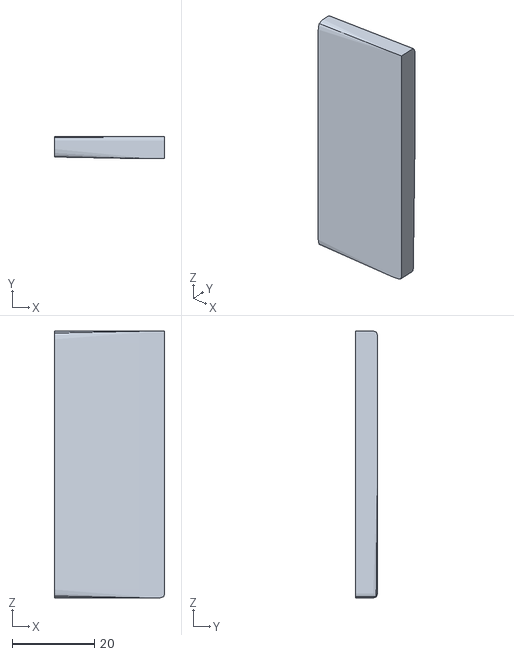
[picture p116: CAD file, 2026-09-22]
assets/cartesian_hand/meshes/collision_pieces/bridge_12.obj
26.9 x 5.41 x 65.1
