generalroboticslab/Cartesian_Hand/assets/cartesian_hand/meshes/collision_pieces/bridge_31.obj

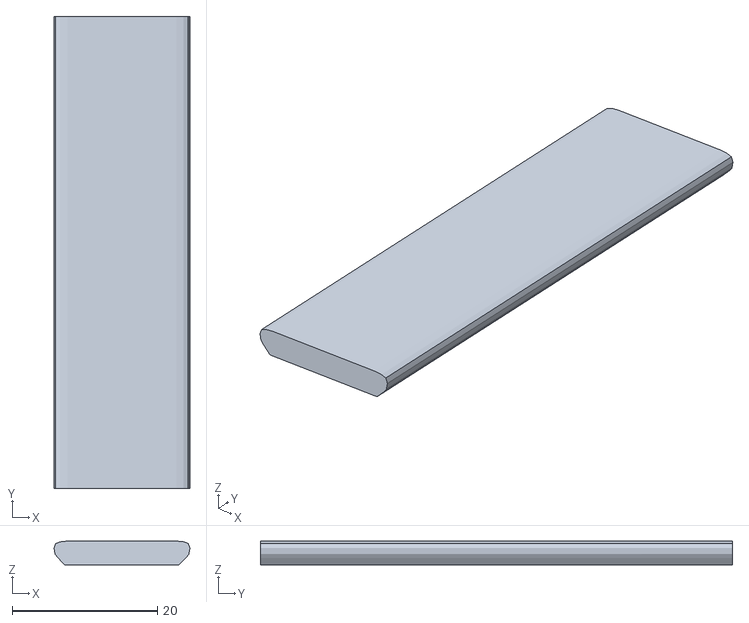
[picture p117: CAD file, 2026-09-22]
assets/cartesian_hand/meshes/collision_pieces/bridge_31.obj
18.7 x 65.0 x 3.31
