generalroboticslab/Cartesian_Hand/assets/cartesian_hand/meshes/collision_pieces/bridge_26.obj

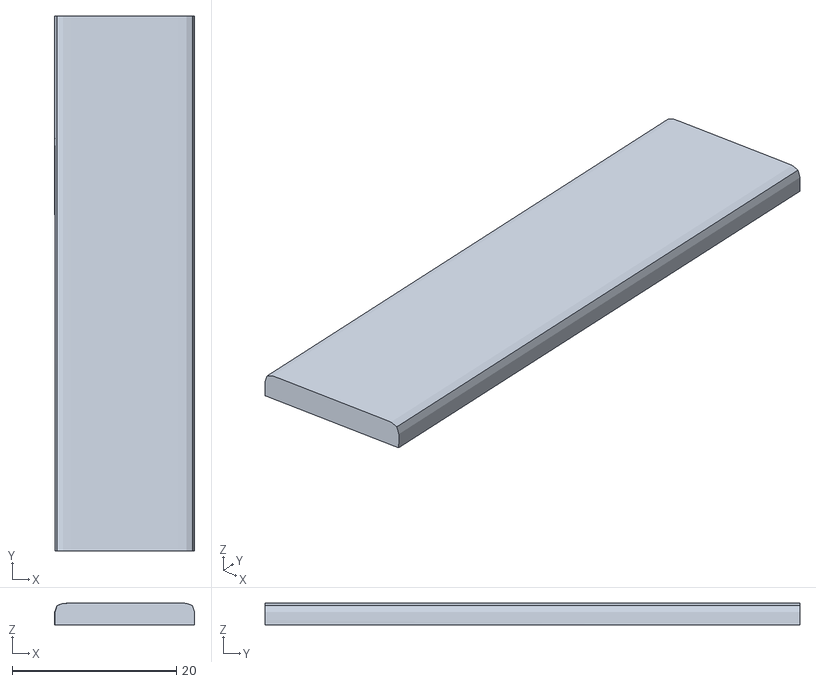
[picture p118: CAD file, 2026-09-22]
assets/cartesian_hand/meshes/collision_pieces/bridge_26.obj
17.0 x 65.0 x 2.64
