generalroboticslab/Cartesian_Hand/assets/cartesian_hand/meshes/collision_pieces/base_15.obj

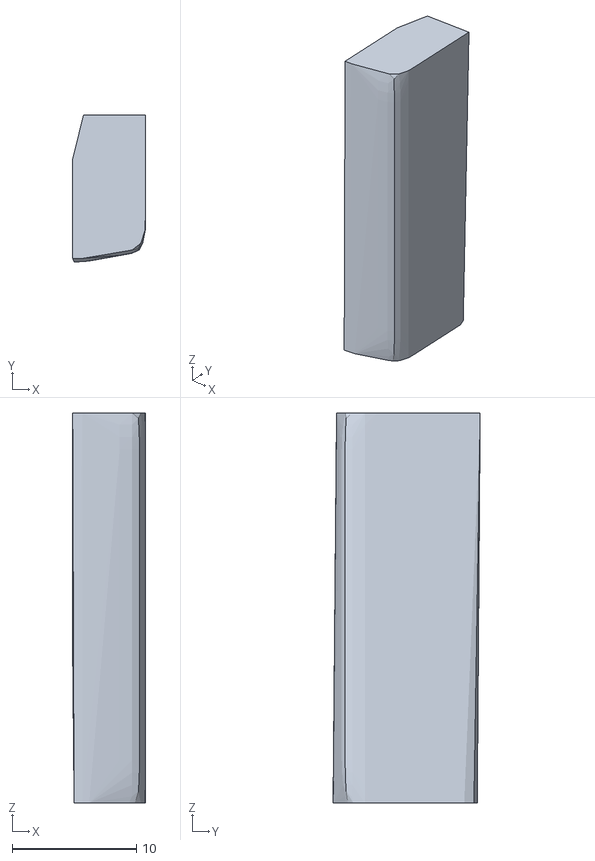
[picture p119: CAD file, 2026-09-22]
assets/cartesian_hand/meshes/collision_pieces/base_15.obj
5.84 x 11.8 x 31.4
