generalroboticslab/Cartesian_Hand/assets/cartesian_hand/meshes/collision_pieces/base_21.obj

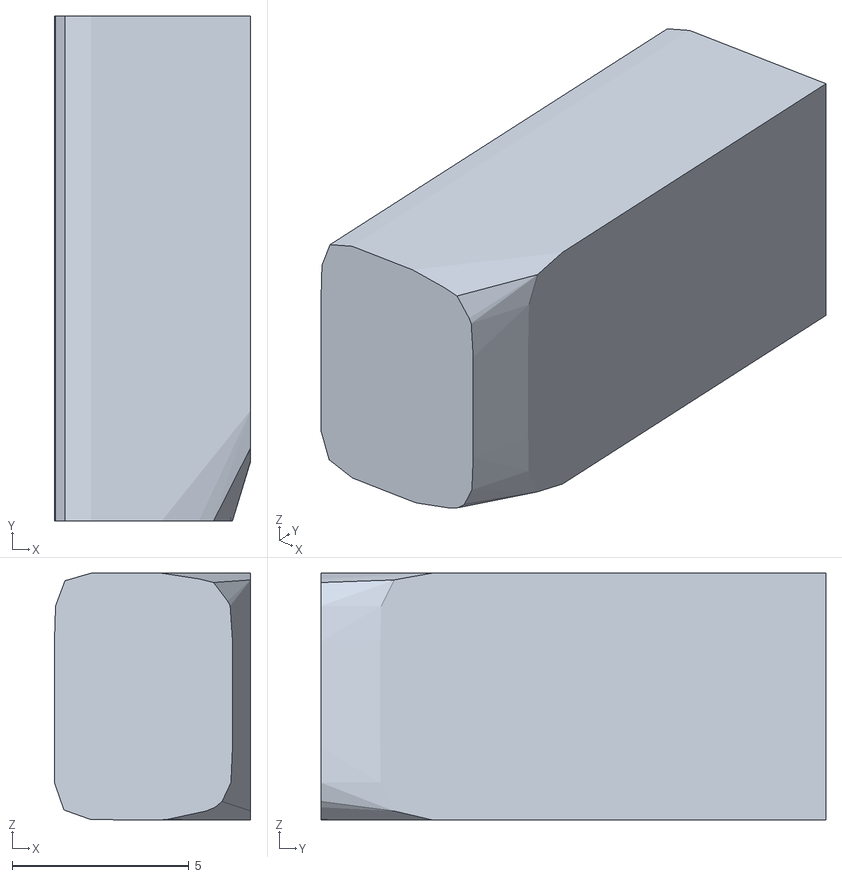
[picture p120: CAD file, 2026-09-22]
assets/cartesian_hand/meshes/collision_pieces/base_21.obj
5.55 x 14.3 x 6.97
