generalroboticslab/Cartesian_Hand/assets/cartesian_hand/meshes/collision_pieces/bridge_78.obj

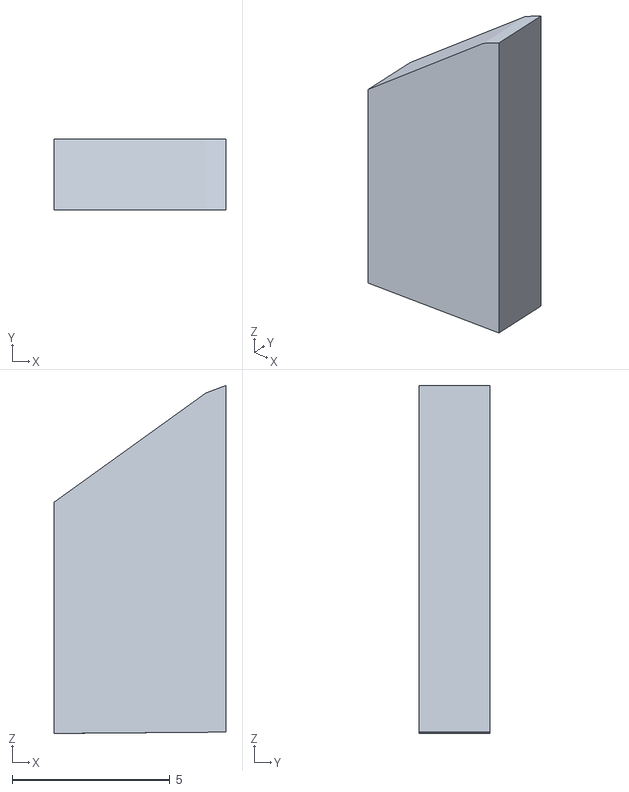
[picture p121: CAD file, 2026-09-22]
assets/cartesian_hand/meshes/collision_pieces/bridge_78.obj
5.45 x 2.24 x 11.0
