generalroboticslab/Cartesian_Hand/assets/cartesian_hand/meshes/collision_pieces/bridge_52.obj

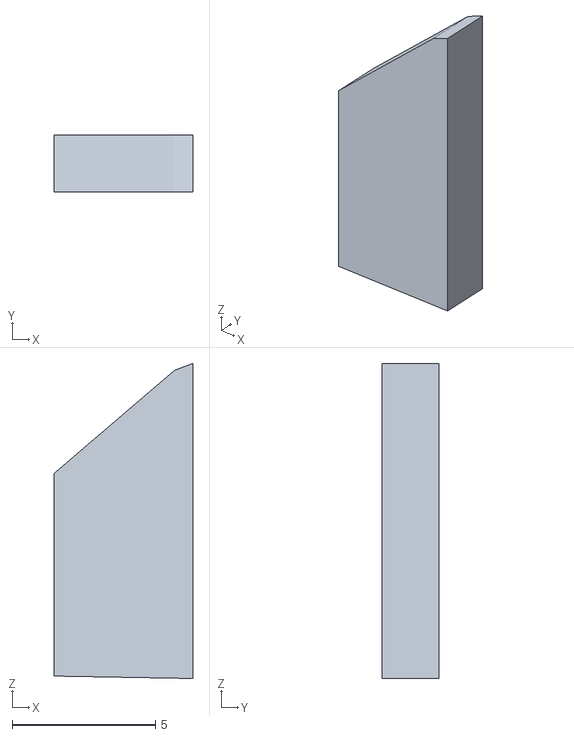
[picture p122: CAD file, 2026-09-22]
assets/cartesian_hand/meshes/collision_pieces/bridge_52.obj
4.84 x 1.98 x 11.0
