generalroboticslab/Cartesian_Hand/assets/cartesian_hand/meshes/collision_pieces/bridge_79.obj

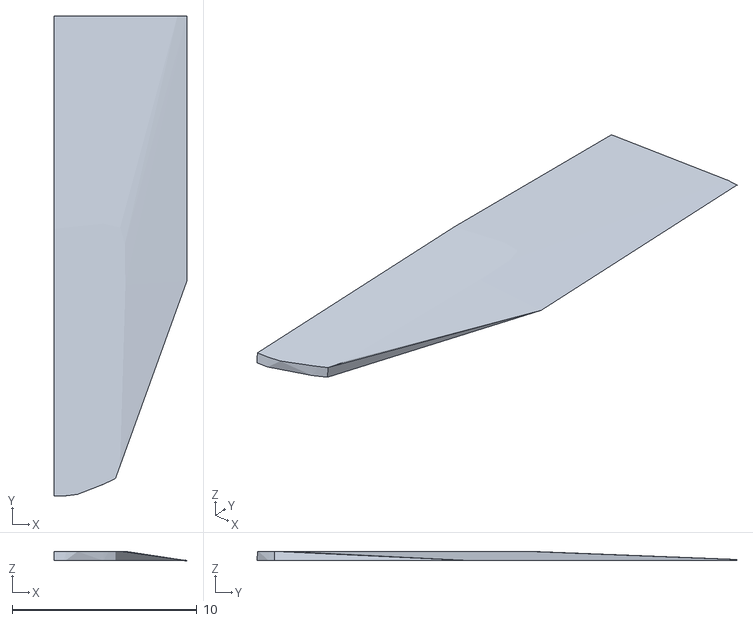
[picture p123: CAD file, 2026-09-22]
assets/cartesian_hand/meshes/collision_pieces/bridge_79.obj
7.18 x 26.0 x 0.507
