generalroboticslab/Cartesian_Hand/assets/cartesian_hand/meshes/collision_pieces/bridge_68.obj

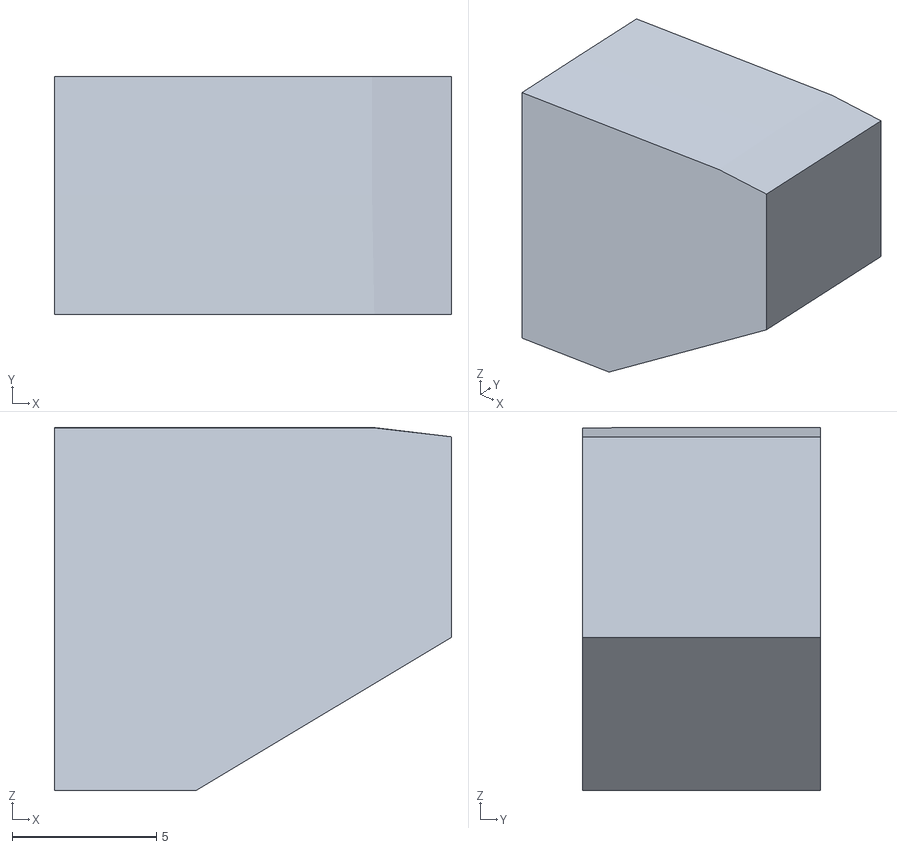
[picture p124: CAD file, 2026-09-22]
assets/cartesian_hand/meshes/collision_pieces/bridge_68.obj
13.8 x 8.25 x 12.6
