generalroboticslab/Cartesian_Hand/assets/cartesian_hand/meshes/collision_pieces/base_12.obj

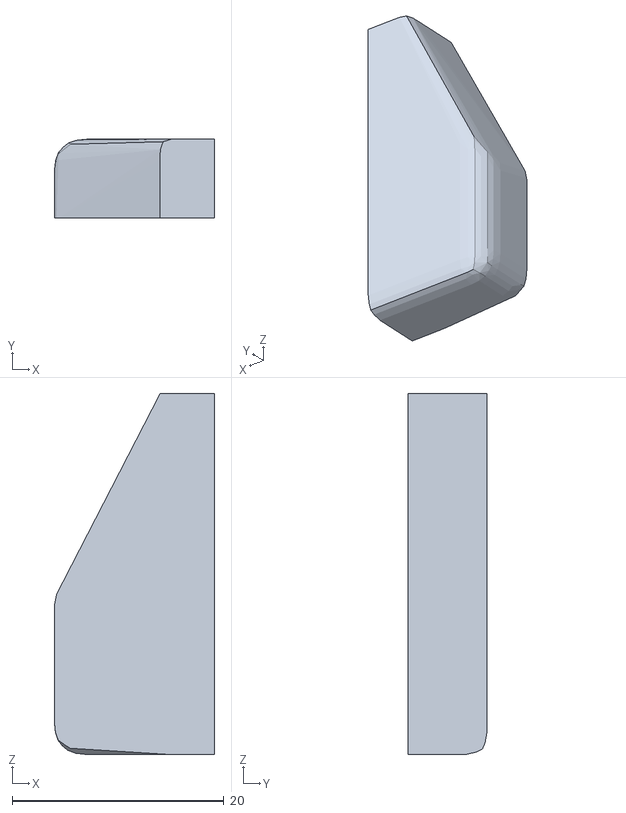
[picture p125: CAD file, 2026-09-22]
assets/cartesian_hand/meshes/collision_pieces/base_12.obj
15.2 x 7.46 x 34.1
