generalroboticslab/Cartesian_Hand/assets/cartesian_hand/meshes/collision_pieces/base_35.obj

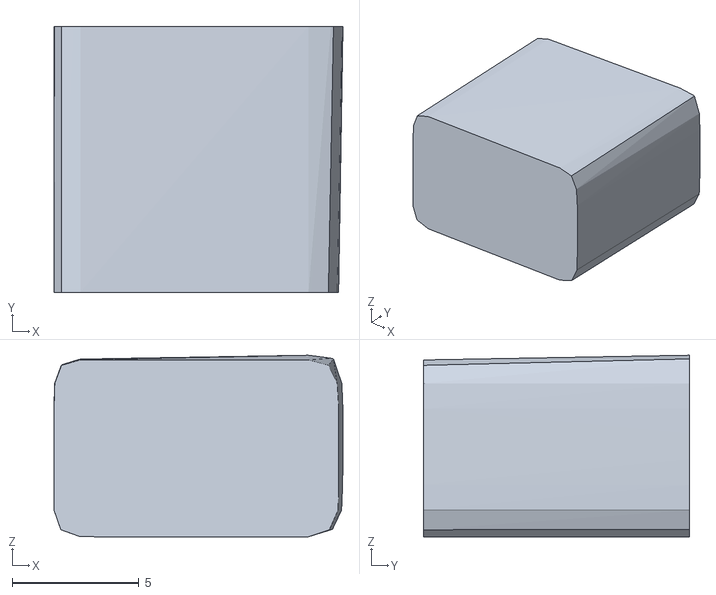
[picture p126: CAD file, 2026-09-22]
assets/cartesian_hand/meshes/collision_pieces/base_35.obj
11.4 x 10.5 x 7.16
