generalroboticslab/Cartesian_Hand/assets/cartesian_hand/meshes/collision_pieces/bridge_70.obj

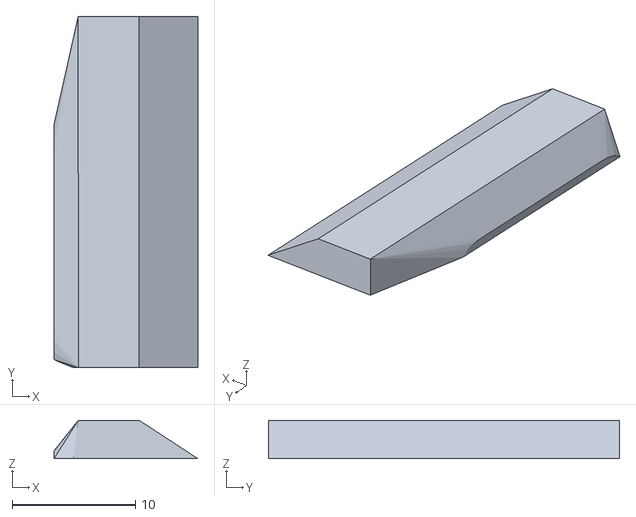
[picture p127: CAD file, 2026-09-22]
assets/cartesian_hand/meshes/collision_pieces/bridge_70.obj
11.7 x 28.6 x 3.12
