generalroboticslab/Cartesian_Hand/assets/cartesian_hand/meshes/collision_pieces/base_38.obj

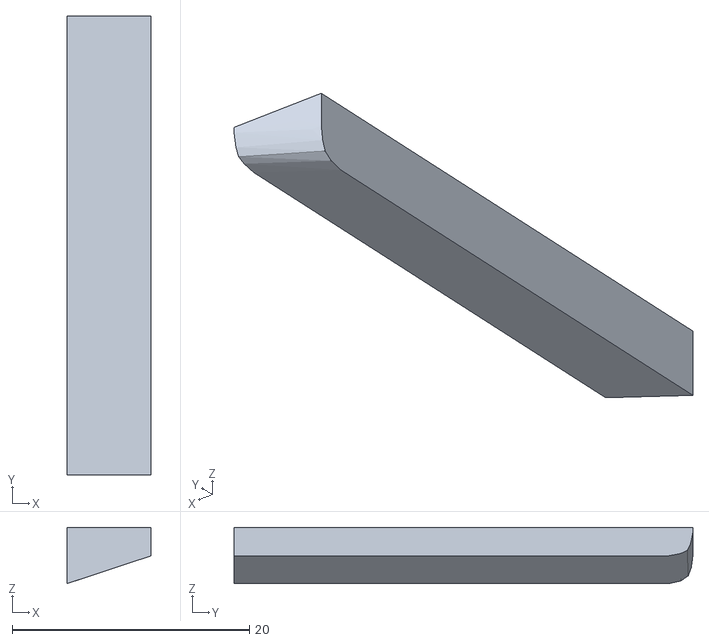
[picture p128: CAD file, 2026-09-22]
assets/cartesian_hand/meshes/collision_pieces/base_38.obj
7.11 x 38.7 x 4.76
