generalroboticslab/Cartesian_Hand/assets/cartesian_hand/meshes/collision_pieces/bridge_01.obj

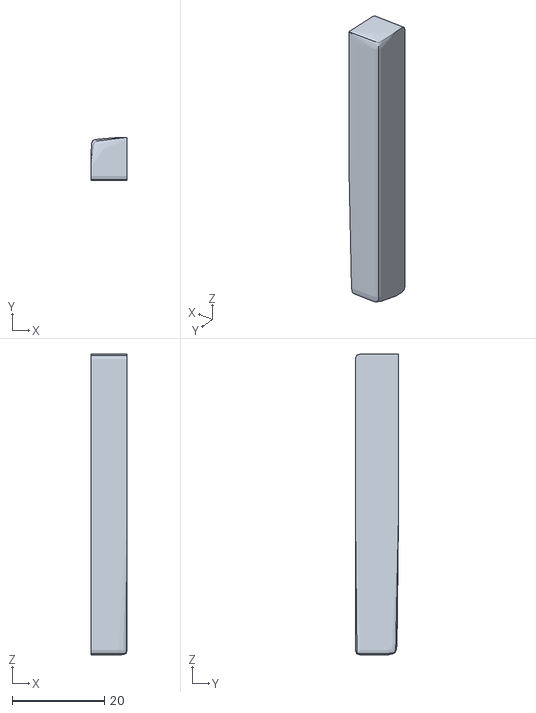
[picture p129: CAD file, 2026-09-22]
assets/cartesian_hand/meshes/collision_pieces/bridge_01.obj
7.88 x 9.37 x 65.1
