generalroboticslab/Cartesian_Hand/assets/cartesian_hand/meshes/collision_pieces/bridge_56.obj

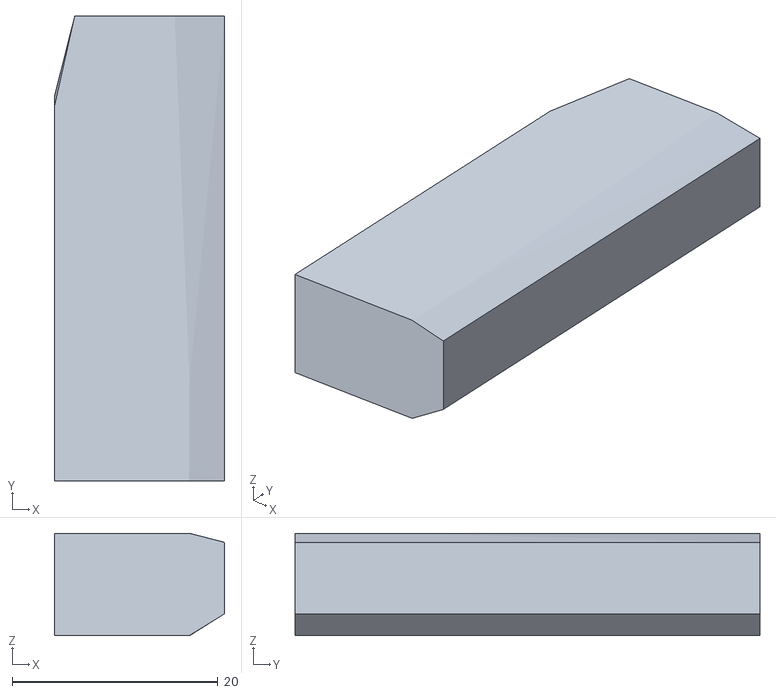
[picture p130: CAD file, 2026-09-22]
assets/cartesian_hand/meshes/collision_pieces/bridge_56.obj
16.5 x 45.2 x 9.97
