generalroboticslab/Cartesian_Hand/assets/cartesian_hand/meshes/collision_pieces/bridge_75.obj

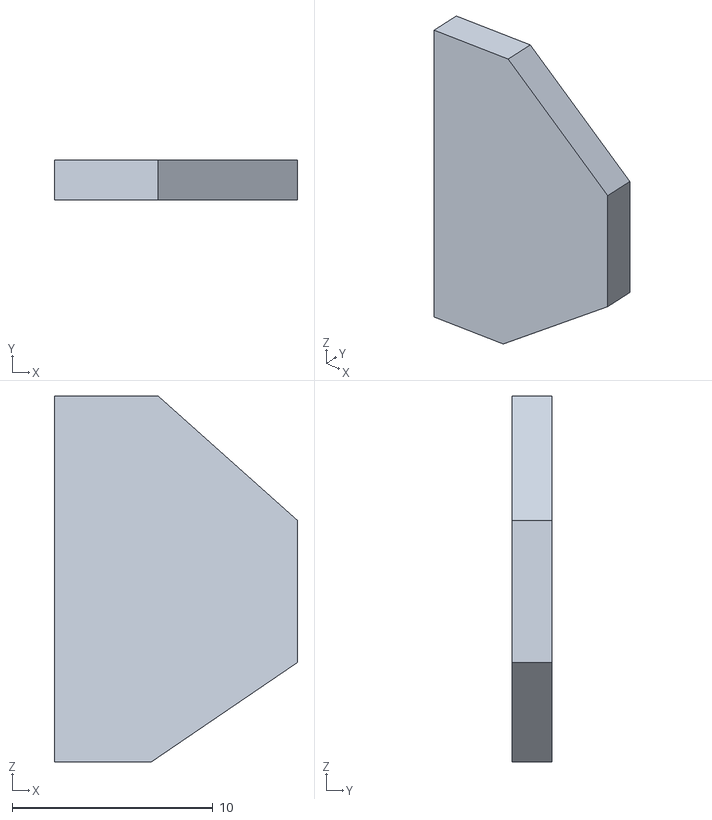
[picture p131: CAD file, 2026-09-22]
assets/cartesian_hand/meshes/collision_pieces/bridge_75.obj
12.1 x 1.98 x 18.3
