generalroboticslab/Cartesian_Hand/assets/cartesian_hand/meshes/collision_pieces/base_42.obj

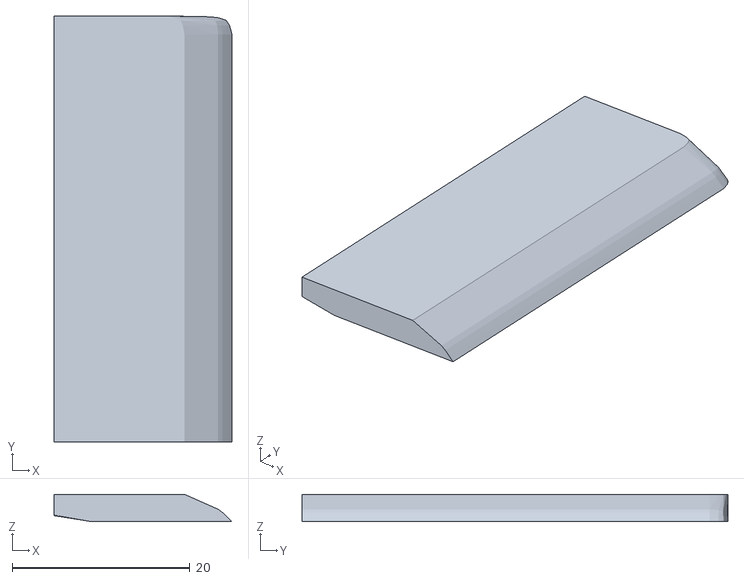
[picture p132: CAD file, 2026-09-22]
assets/cartesian_hand/meshes/collision_pieces/base_42.obj
20.0 x 47.9 x 3.08
