generalroboticslab/Cartesian_Hand/assets/cartesian_hand/meshes/collision_pieces/bridge_42.obj

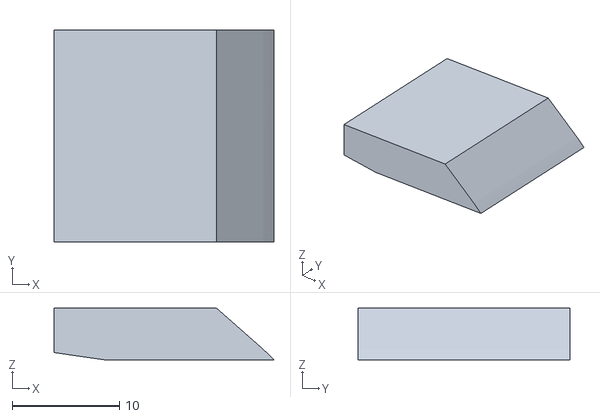
[picture p133: CAD file, 2026-09-22]
assets/cartesian_hand/meshes/collision_pieces/bridge_42.obj
20.5 x 19.8 x 4.84
