generalroboticslab/Cartesian_Hand/assets/cartesian_hand/meshes/collision_pieces/bridge_39.obj

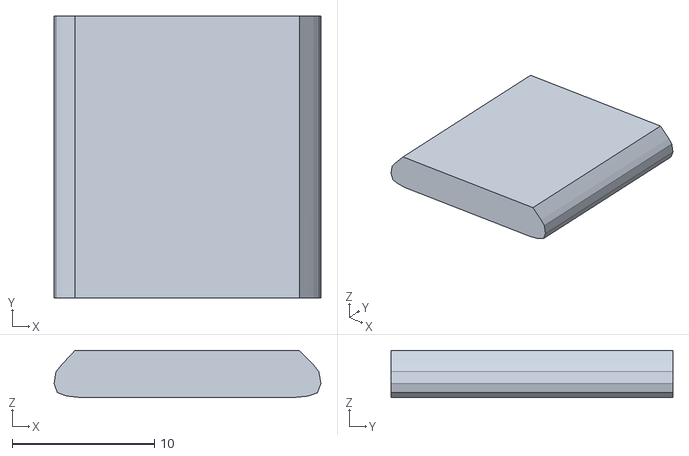
[picture p134: CAD file, 2026-09-22]
assets/cartesian_hand/meshes/collision_pieces/bridge_39.obj
18.7 x 19.8 x 3.30
