generalroboticslab/Cartesian_Hand/assets/cartesian_hand/meshes/collision_pieces/bridge_64.obj

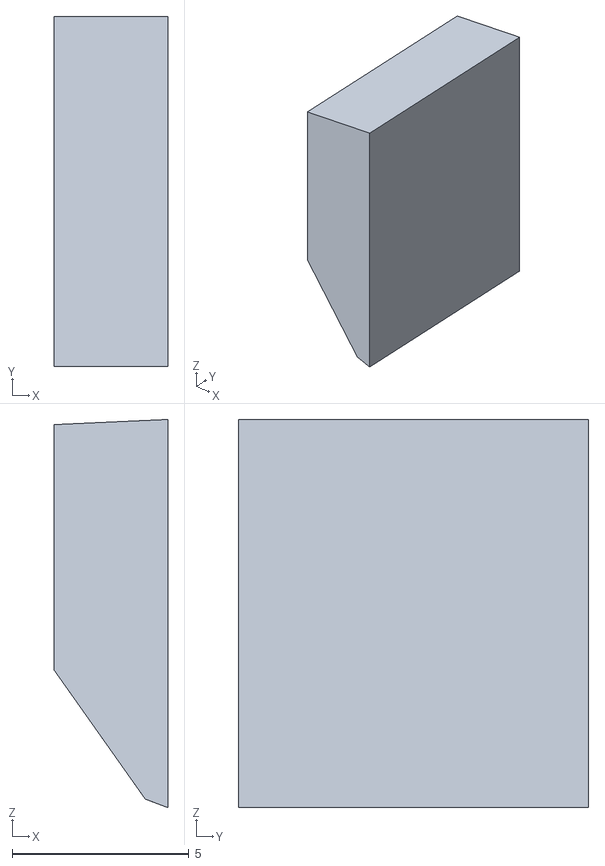
[picture p135: CAD file, 2026-09-22]
assets/cartesian_hand/meshes/collision_pieces/bridge_64.obj
3.22 x 9.91 x 11.0
