generalroboticslab/Cartesian_Hand/assets/cartesian_hand/meshes/collision_pieces/bridge_28.obj

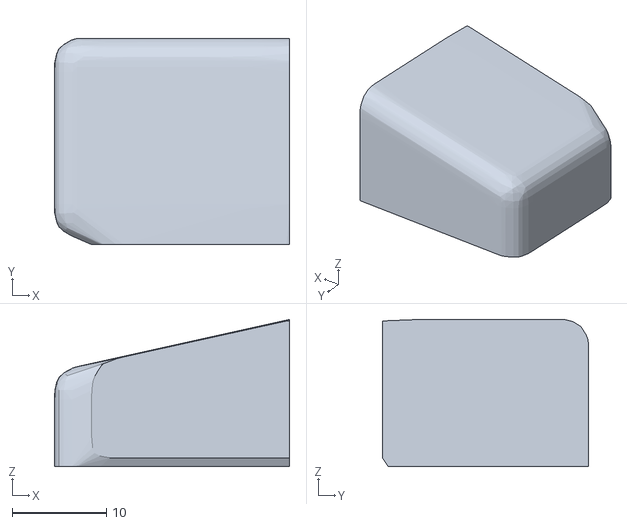
[picture p136: CAD file, 2026-09-22]
assets/cartesian_hand/meshes/collision_pieces/bridge_28.obj
24.9 x 21.9 x 15.6
