generalroboticslab/Cartesian_Hand/assets/cartesian_hand/meshes/collision_pieces/bridge_38.obj

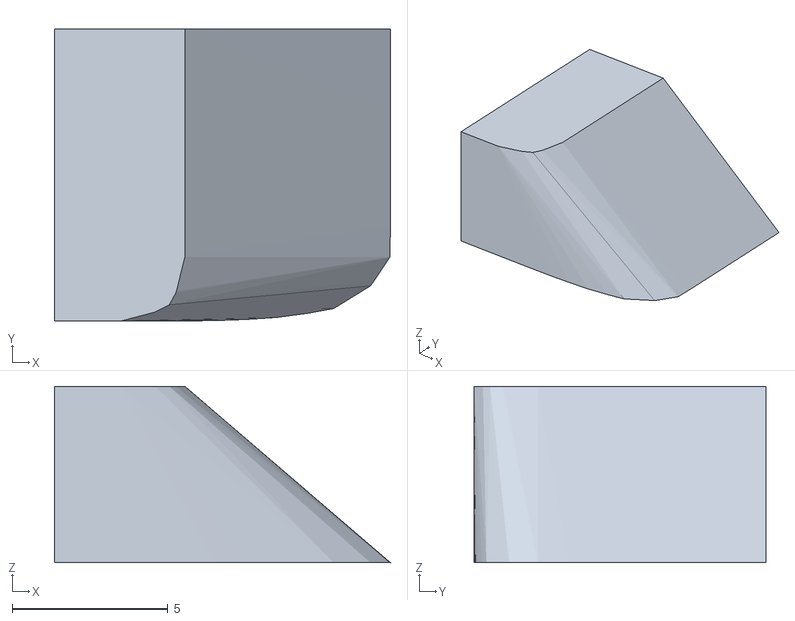
[picture p137: CAD file, 2026-09-22]
assets/cartesian_hand/meshes/collision_pieces/bridge_38.obj
10.8 x 9.37 x 5.65
