generalroboticslab/Cartesian_Hand/assets/cartesian_hand/meshes/collision_pieces/base_75.obj

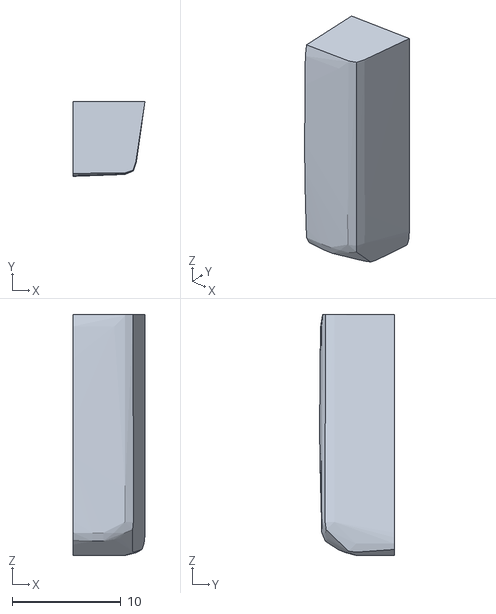
[picture p138: CAD file, 2026-09-22]
assets/cartesian_hand/meshes/collision_pieces/base_75.obj
6.62 x 6.88 x 22.2
