generalroboticslab/Cartesian_Hand/assets/cartesian_hand/meshes/collision_pieces/bridge_51.obj

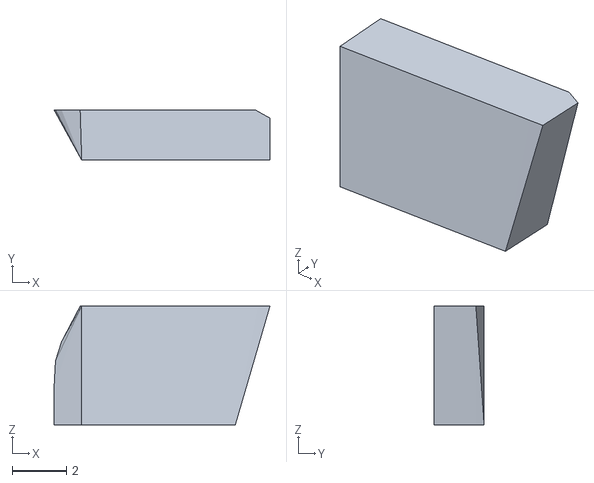
[picture p139: CAD file, 2026-09-22]
assets/cartesian_hand/meshes/collision_pieces/bridge_51.obj
7.97 x 1.85 x 4.39
