generalroboticslab/Cartesian_Hand/assets/cartesian_hand/meshes/collision_pieces/bridge_72.obj

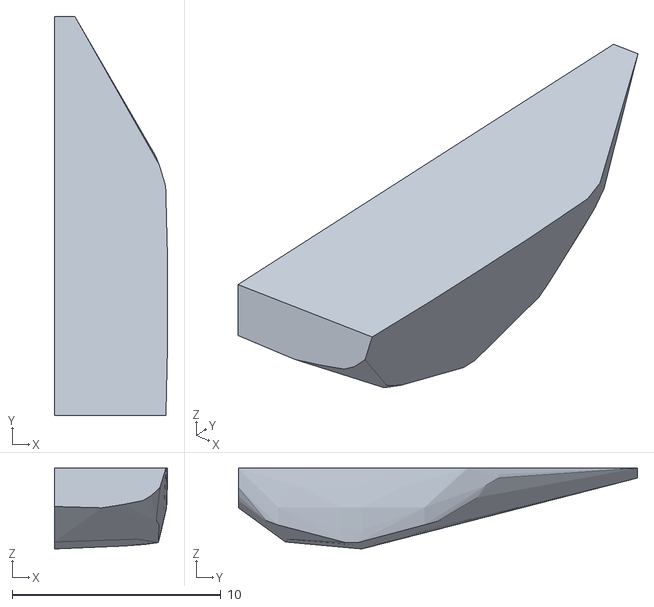
[picture p140: CAD file, 2026-09-22]
assets/cartesian_hand/meshes/collision_pieces/bridge_72.obj
5.41 x 19.1 x 3.87
