generalroboticslab/Cartesian_Hand/assets/cartesian_hand/meshes/collision_pieces/bridge_16.obj

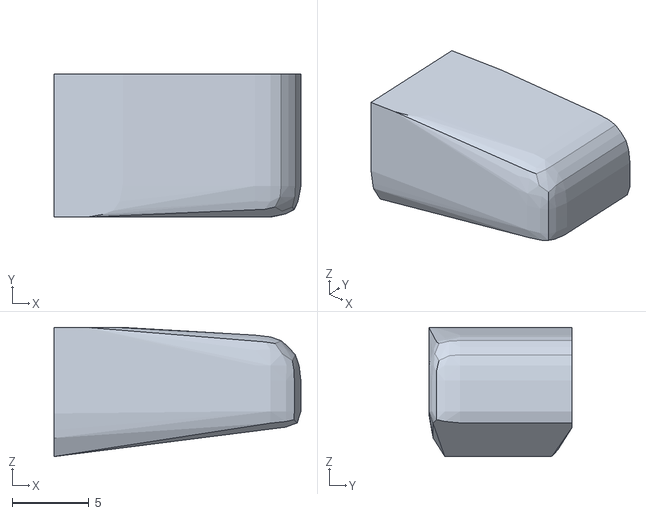
[picture p141: CAD file, 2026-09-22]
assets/cartesian_hand/meshes/collision_pieces/bridge_16.obj
16.1 x 9.37 x 8.44
