generalroboticslab/Cartesian_Hand/assets/cartesian_hand/meshes/collision_pieces/base_87.obj

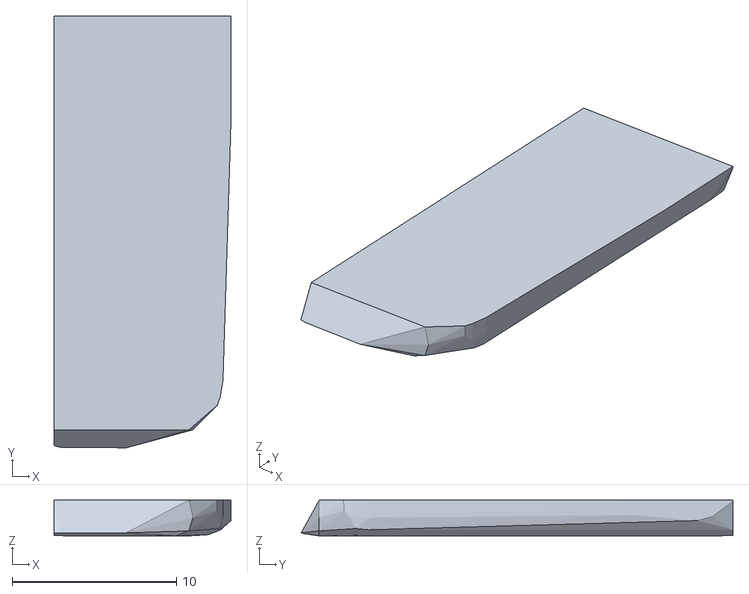
[picture p142: CAD file, 2026-09-22]
assets/cartesian_hand/meshes/collision_pieces/base_87.obj
10.8 x 26.3 x 2.19
