generalroboticslab/Cartesian_Hand/assets/cartesian_hand/meshes/collision_pieces/base_19.obj

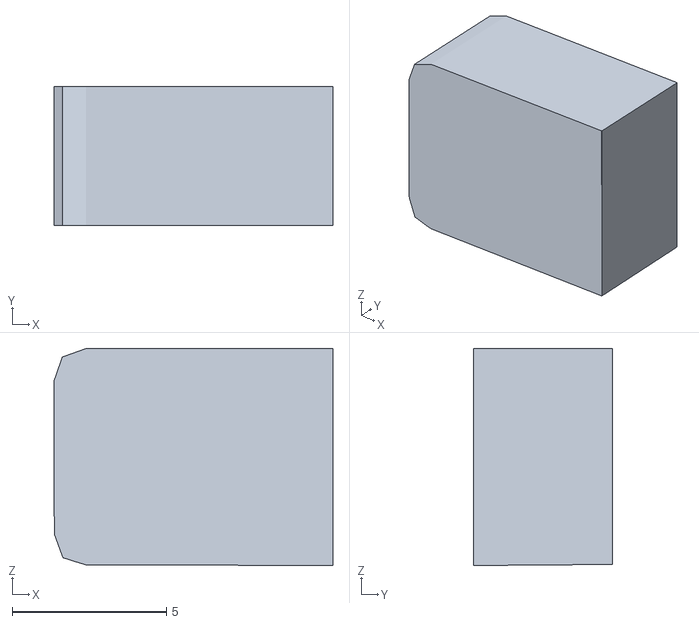
[picture p143: CAD file, 2026-09-22]
assets/cartesian_hand/meshes/collision_pieces/base_19.obj
9.04 x 4.52 x 7.03
