generalroboticslab/Cartesian_Hand/assets/cartesian_hand/meshes/collision_pieces/bridge_20.obj

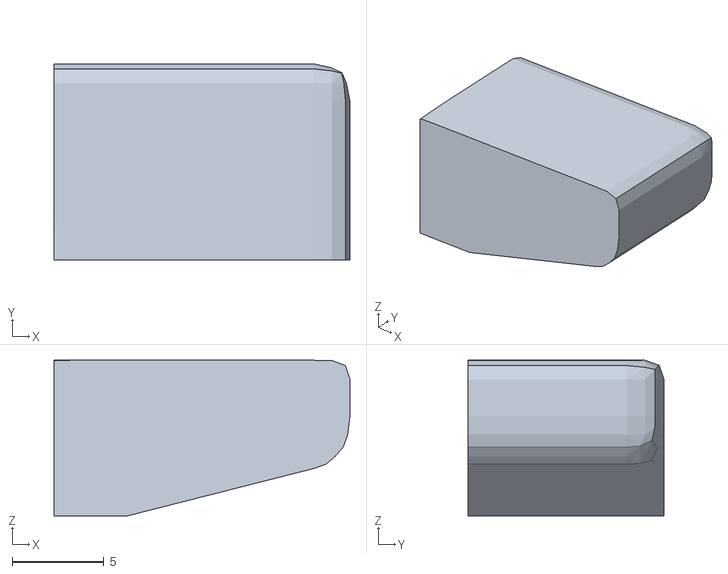
[picture p144: CAD file, 2026-09-22]
assets/cartesian_hand/meshes/collision_pieces/bridge_20.obj
16.1 x 10.7 x 8.48
