generalroboticslab/Cartesian_Hand/assets/cartesian_hand/meshes/collision_pieces/base_61.obj

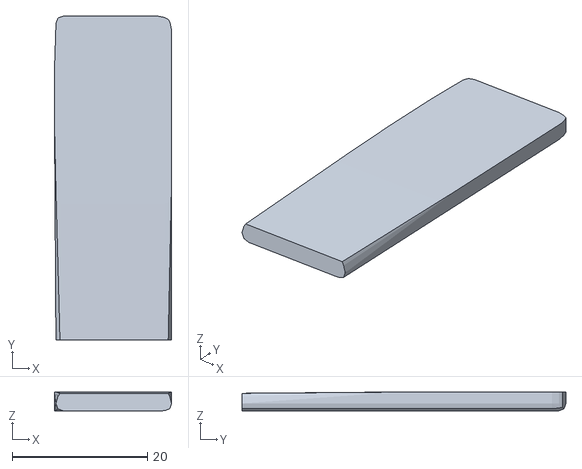
[picture p145: CAD file, 2026-09-22]
assets/cartesian_hand/meshes/collision_pieces/base_61.obj
17.3 x 47.9 x 2.77
