generalroboticslab/Cartesian_Hand/(list of files, cad)

Other CAD files:
hardware/CAD/finger tip.step
assets/cartesian_hand/meshes/right_down_rack__nylon.obj
assets/cartesian_hand/meshes/base__red.obj
assets/cartesian_hand/meshes/right_up_rack__red.obj
assets/cartesian_hand/meshes/left_down_finger__nylon.obj
assets/cartesian_hand/meshes/left_down_rack__red.obj
assets/cartesian_hand/meshes/right_down_finger__nylon.obj
assets/cartesian_hand/meshes/base__steel.obj
assets/cartesian_hand/meshes/right_down_rack__steel.obj
assets/cartesian_hand/meshes/right_up_finger__nylon.obj
assets/cartesian_hand/meshes/right_down_rack__red.obj
assets/cartesian_hand/meshes/left_up_rack__nylon.obj
assets/cartesian_hand/meshes/right_up_rack__nylon.obj
assets/cartesian_hand/meshes/left_down_rack__steel.obj
assets/cartesian_hand/meshes/collision_pieces/base_44.obj
assets/cartesian_hand/meshes/collision_pieces/base_05.obj
assets/cartesian_hand/meshes/collision_pieces/base_06.obj
assets/cartesian_hand/meshes/collision_pieces/base_07.obj
assets/cartesian_hand/meshes/collision_pieces/base_11.obj
assets/cartesian_hand/meshes/collision_pieces/base_14.obj
assets/cartesian_hand/meshes/collision_pieces/base_22.obj
assets/cartesian_hand/meshes/collision_pieces/base_25.obj
assets/cartesian_hand/meshes/collision_pieces/base_26.obj
assets/cartesian_hand/meshes/collision_pieces/base_27.obj
assets/cartesian_hand/meshes/collision_pieces/base_28.obj
assets/cartesian_hand/meshes/collision_pieces/base_29.obj
assets/cartesian_hand/meshes/collision_pieces/base_34.obj
assets/cartesian_hand/meshes/collision_pieces/base_39.obj
assets/cartesian_hand/meshes/collision_pieces/base_43.obj
assets/cartesian_hand/meshes/collision_pieces/base_48.obj
assets/cartesian_hand/meshes/collision_pieces/base_49.obj
assets/cartesian_hand/meshes/collision_pieces/base_50.obj
assets/cartesian_hand/meshes/collision_pieces/base_51.obj
assets/cartesian_hand/meshes/collision_pieces/base_60.obj
assets/cartesian_hand/meshes/collision_pieces/base_67.obj
assets/cartesian_hand/meshes/collision_pieces/base_70.obj
assets/cartesian_hand/meshes/collision_pieces/base_84.obj
assets/cartesian_hand/meshes/collision_pieces/base_86.obj
assets/cartesian_hand/meshes/collision_pieces/base_88.obj
assets/cartesian_hand/meshes/collision_pieces/base_89.obj
assets/cartesian_hand/meshes/collision_pieces/bridge_03.obj
assets/cartesian_hand/meshes/collision_pieces/bridge_05.obj
assets/cartesian_hand/meshes/collision_pieces/bridge_08.obj
assets/cartesian_hand/meshes/collision_pieces/bridge_09.obj
assets/cartesian_hand/meshes/collision_pieces/bridge_10.obj
assets/cartesian_hand/meshes/collision_pieces/bridge_14.obj
assets/cartesian_hand/meshes/collision_pieces/bridge_15.obj
assets/cartesian_hand/meshes/collision_pieces/bridge_17.obj
assets/cartesian_hand/meshes/collision_pieces/bridge_19.obj
assets/cartesian_hand/meshes/collision_pieces/bridge_23.obj
assets/cartesian_hand/meshes/collision_pieces/bridge_25.obj
assets/cartesian_hand/meshes/collision_pieces/bridge_30.obj
assets/cartesian_hand/meshes/collision_pieces/bridge_32.obj
assets/cartesian_hand/meshes/collision_pieces/bridge_33.obj
assets/cartesian_hand/meshes/collision_pieces/bridge_35.obj
assets/cartesian_hand/meshes/collision_pieces/bridge_40.obj
assets/cartesian_hand/meshes/collision_pieces/bridge_44.obj
assets/cartesian_hand/meshes/collision_pieces/bridge_48.obj
assets/cartesian_hand/meshes/collision_pieces/bridge_53.obj
assets/cartesian_hand/meshes/collision_pieces/bridge_55.obj
assets/cartesian_hand/meshes/collision_pieces/bridge_67.obj
assets/cartesian_hand/meshes/collision_pieces/bridge_71.obj
assets/cartesian_hand/meshes/collision_pieces/bridge_73.obj
assets/cartesian_hand/meshes/collision_pieces/bridge_74.obj
assets/cartesian_hand/meshes/collision_pieces/left_down_finger_00.obj
assets/cartesian_hand/meshes/collision_pieces/left_down_finger_01.obj
assets/cartesian_hand/meshes/collision_pieces/left_down_finger_02.obj
assets/cartesian_hand/meshes/collision_pieces/left_down_finger_03.obj
assets/cartesian_hand/meshes/collision_pieces/left_down_finger_04.obj
assets/cartesian_hand/meshes/collision_pieces/left_down_finger_05.obj
assets/cartesian_hand/meshes/collision_pieces/left_down_finger_06.obj
assets/cartesian_hand/meshes/collision_pieces/left_down_finger_07.obj
assets/cartesian_hand/meshes/collision_pieces/left_down_finger_08.obj
assets/cartesian_hand/meshes/collision_pieces/left_down_finger_09.obj
assets/cartesian_hand/meshes/collision_pieces/left_down_finger_10.obj
assets/cartesian_hand/meshes/collision_pieces/left_down_finger_11.obj
assets/cartesian_hand/meshes/collision_pieces/left_down_finger_12.obj
assets/cartesian_hand/meshes/collision_pieces/left_down_finger_13.obj
assets/cartesian_hand/meshes/collision_pieces/left_down_finger_14.obj
assets/cartesian_hand/meshes/collision_pieces/left_down_finger_15.obj
assets/cartesian_hand/meshes/collision_pieces/left_down_finger_16.obj
assets/cartesian_hand/meshes/collision_pieces/left_down_finger_17.obj
assets/cartesian_hand/meshes/collision_pieces/left_down_finger_18.obj
assets/cartesian_hand/meshes/collision_pieces/left_down_finger_19.obj
assets/cartesian_hand/meshes/collision_pieces/left_down_finger_20.obj
assets/cartesian_hand/meshes/collision_pieces/left_down_finger_21.obj
assets/cartesian_hand/meshes/collision_pieces/left_down_finger_22.obj
assets/cartesian_hand/meshes/collision_pieces/left_down_finger_23.obj
assets/cartesian_hand/meshes/collision_pieces/left_down_finger_24.obj
assets/cartesian_hand/meshes/collision_pieces/left_down_finger_25.obj
assets/cartesian_hand/meshes/collision_pieces/left_down_finger_26.obj
assets/cartesian_hand/meshes/collision_pieces/left_down_finger_27.obj
assets/cartesian_hand/meshes/collision_pieces/left_down_finger_28.obj
assets/cartesian_hand/meshes/collision_pieces/left_down_rack_00.obj
assets/cartesian_hand/meshes/collision_pieces/left_down_rack_01.obj
assets/cartesian_hand/meshes/collision_pieces/left_down_rack_02.obj
assets/cartesian_hand/meshes/collision_pieces/left_down_rack_03.obj
assets/cartesian_hand/meshes/collision_pieces/left_down_rack_04.obj
assets/cartesian_hand/meshes/collision_pieces/left_down_rack_05.obj
assets/cartesian_hand/meshes/collision_pieces/left_down_rack_06.obj
assets/cartesian_hand/meshes/collision_pieces/left_down_rack_07.obj
assets/cartesian_hand/meshes/collision_pieces/left_down_rack_08.obj
assets/cartesian_hand/meshes/collision_pieces/left_down_rack_09.obj
assets/cartesian_hand/meshes/collision_pieces/left_down_rack_10.obj
assets/cartesian_hand/meshes/collision_pieces/left_down_rack_11.obj
assets/cartesian_hand/meshes/collision_pieces/left_down_rack_12.obj
assets/cartesian_hand/meshes/collision_pieces/left_down_rack_13.obj
assets/cartesian_hand/meshes/collision_pieces/left_down_rack_14.obj
assets/cartesian_hand/meshes/collision_pieces/left_down_rack_15.obj
assets/cartesian_hand/meshes/collision_pieces/left_down_rack_16.obj
assets/cartesian_hand/meshes/collision_pieces/left_down_rack_17.obj
assets/cartesian_hand/meshes/collision_pieces/left_down_rack_18.obj
assets/cartesian_hand/meshes/collision_pieces/left_down_rack_19.obj
assets/cartesian_hand/meshes/collision_pieces/left_down_rack_20.obj
assets/cartesian_hand/meshes/collision_pieces/left_down_rack_21.obj
assets/cartesian_hand/meshes/collision_pieces/left_down_rack_22.obj
assets/cartesian_hand/meshes/collision_pieces/left_down_rack_23.obj
assets/cartesian_hand/meshes/collision_pieces/left_down_rack_24.obj
assets/cartesian_hand/meshes/collision_pieces/left_down_rack_25.obj
assets/cartesian_hand/meshes/collision_pieces/left_down_rack_26.obj
assets/cartesian_hand/meshes/collision_pieces/left_down_rack_27.obj
assets/cartesian_hand/meshes/collision_pieces/left_down_rack_28.obj
assets/cartesian_hand/meshes/collision_pieces/left_down_rack_29.obj
assets/cartesian_hand/meshes/collision_pieces/left_down_rack_30.obj
assets/cartesian_hand/meshes/collision_pieces/left_down_rack_31.obj
assets/cartesian_hand/meshes/collision_pieces/left_down_rack_32.obj
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
