generalroboticslab/Cartesian_Hand/cartesian_hand/src/ft_servo/SCSerial.h

/*
 * SCSerial.h
 * 飞特串行舵机硬件接口层程序
 * 日期: 2022.3.29
 * 作者: 
 */

#ifndef _SCSERIAL_H
#define _SCSERIAL_H

#include "SCS.h"
#include <stdio.h>
#include <termios.h>
#include <fcntl.h>
#include <unistd.h>
#include <string.h>
#include <sys/select.h>

class SCSerial : public SCS
{
public:
	SCSerial();
	SCSerial(u8 End);
	SCSerial(u8 End, u8 Level);

protected:
	int writeSCS(unsigned char *nDat, int nLen);//输出nLen字节
	int readSCS(unsigned char *nDat, int nLen);//输入nLen字节
	int readSCS(unsigned char *nDat, int nLen, unsigned long TimeOut);
	int writeSCS(unsigned char bDat);//输出1字节
	void rFlushSCS();//
	void wFlushSCS();//
public:
	unsigned long int IOTimeOut;//输入输出超时
public:
	int setBaudRate(int baudRate);
	bool begin(int baudRate, const char* serialPort);
	void end();
protected:
    int fd;//serial port handle
    struct termios orgopt;//fd ort opt
	struct termios curopt;//fd cur opt
	unsigned char txBuf[255];
	int txBufLen;
};

#endif
