generalroboticslab/Cartesian_Hand/cartesian_hand/sim.py

"""The other backend: run a task against mujoco instead of against servos.

    python -m cartesian_hand.sim --task zero
    python -m cartesian_hand.sim --task cap

Same task and direct-policy files as `studio.live`, not ports of them. Existing
tasks yield `Motions` programs; a direct policy instead receives the canonical
typed observation and returns goal, speed, and effort every tick. What differs
between here and hardware is the adapter around either controller -- `mj_step`
and a `qpos` read where the other has `set_positions` and `read_all`.

Deliberately not covered
------------------------
**Effort is dropped on the floor here.** `Motions` torque and direct-policy
`Action.effort_limit` both reach this adapter, which cannot apply either: the
MJCF's actuators are `<position>` with a fixed `kp`, so there is no
per-environment force cap to write. Every
`stop="stuck"` in a task therefore fires against a joint limit rather than
against a grip that yields at a tuned force. That is enough to prove a task
runs, and not enough to transfer a *force*; the sim's own README calls its
dynamics placeholder, so the missing piece is upstream of this file.

Two backends, one loop
----------------------
`run` is CPU MuJoCo at N=1 -- the reference, and the fallback on a box with no
CUDA. `run_warp` is `mujoco_warp` at any N. Neither is a port of the other:
both hand `drive` the same four verbs and it owns the loop, so there is exactly
one place where a tick is decided.

What makes the batched one worth having is that `Motions` is already torch, and
`wp.to_torch` views Warp's `qpos`/`ctrl` with no copy, so the whole control loop
stays resident on the GPU -- measured millimetres in and goals out never touch
the host. Measured on an RTX 4090 with the shipped model: 74.6k steps/s on CPU
at N=1 against 8.1M steps/s at N=4096, a 109x speedup. That figure is an upper
bound: the model has no objects in it yet, so `ncon` is 0 and collision is doing
no work. Re-measure once there is something to grasp.

**`mj_step`, not `mj_forward`.** The opposite of `studio.live`, and for the
opposite reason: there the physics *is* the hand and re-simulating would
overwrite what it reported, here the physics is all there is. Stepping is also
what applies the `<equality>` couplings, so a rack pair's follower moves on its
own rather than needing the explicit write the studio loop does.
"""
import mujoco
import numpy as np
import torch
import tyro
from collections.abc import Callable

from .config import DEFAULT_HAND, HandConfig, get_hand
from .mjcf import MM_PER_M, mjcf_path, narrow_ctrlrange, qpos_addrs
from .motions import Task, TaskRunner
from .policy import Policy, PolicyRunner, PolicyState
from . import tasks


def step_limit_mm(cfg: HandConfig,
                  device: str | torch.device = "cpu") -> torch.Tensor:
    """`[1, J]` millimetres a joint may be commanded to advance in one tick.

    The servo profiles internally: `set_positions(..., speed=300)` means the
    joint tracks a setpoint that walks toward the goal at 300 counts/s, not that
    it appears there. mujoco's `<position>` actuators model none of that -- they
    are handed a target and the solver drives to it as hard as `kp` allows -- so
    without this a sim joint crosses 55 mm in the same tick it crosses 5.

    That is not a cosmetic difference, it is the one that made time meaningless
    in sim: zeroing finished in 45 ticks here against roughly 4000 on the bench,
    every distance and every timeout cost the same, and a search over travel and
    budgets found a completely flat objective (measured 2026-09-03). Stall
    detection is affected too -- `STUCK_WINDOW_STEPS` is 10 ticks of *travel*,
    and a joint that arrives instantly never spends them.
    """
    return (cfg.gain_vector("speed").to(device=device, dtype=torch.float32)
            / cfg.counts_per_mm / cfg.control_hz)[None, :]


def profile(goal_mm: torch.Tensor, command_mm: torch.Tensor,
            limit_mm: torch.Tensor) -> torch.Tensor:
    """Walk the *commanded* setpoint toward `goal_mm` at no more than `limit_mm`/tick.

    The setpoint is what the servo ramps, and the joint follows it with whatever
    error the load imposes. Ramping from the measured position instead would
    model a joint that cannot be pushed off course -- the opposite of a stall --
    and, more importantly, it can never let the setpoint outrun the joint by
    more than one step, which is exactly what `acc` does on a real servo and
    what is needed for a gravity-loaded DOF to develop enough force to lift.
    z could not rise against gravity here before this fix: against the bench it
    took `acc=200` to free the z stage.

    The first call seeds the setpoint with the joint's measured position, so a
    sim run starts from where it actually is.
    """
    return command_mm + (goal_mm - command_mm).clamp(-limit_mm, limit_mm)


def drive(controller: Task | Policy, cfg: HandConfig,
          read_mm: Callable[[], torch.Tensor],
          write_goal: Callable[[torch.Tensor], None],
          advance: Callable[[], None],
          sense: Callable[[], torch.Tensor | None],
          report: Callable[[], None],
          limit_mm: torch.Tensor, hold_torque: torch.Tensor,
          max_seconds: float) -> torch.Tensor | PolicyState:
    """The control loop both backends run, and the only copy of it.

    A backend supplies four verbs -- read millimetres, write a goal, advance the
    physics, sample an external contact signal -- and differs in nothing else.
    Keeping the loop here is what stops a fix landing in one backend only.

    `report` runs after the loop and *before* the failure check, so a run that
    ends badly still prints where the hand got to.

    A legacy generator returns its measurement; a direct policy its typed final
    state. Raises `RuntimeError` if any env failed -- a probe that closed on
    air, a DOF that never found its stop. Tasks report that as `Result.ok`
    rather than raising (see `motions.Result`); turning it back into an
    exception is this backend's policy, not the task's, since a CLI that printed
    a radius after measuring nothing is worse than one that stops. A caller
    wanting the flags per env drives `TaskRunner` and reads `runner.result`.
    """
    hz = cfg.control_hz
    direct = (PolicyRunner(controller, hz)
              if isinstance(controller, Policy) else None)
    runner = (None if direct is not None else
              TaskRunner(controller, hold_torque=hold_torque))
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
