generalroboticslab/Cartesian_Hand/(commit log)

2026-08-28 submodule: bump hardware_bindings to ft_servo fixes
    Two upstreamed fixes that this repo consumes:
    79ad05a bind write_id, fix negative-position encoding
    7f2402c correct INST_RESET opcode, drop fabricated opcodes
    write_id was previously only reachable through the pure-Python driver,
    so any caller holding the C++ extension had to open a second connection
    to rename a servo. Negative target positions were packed as two's
    complement where the servo expects sign-magnitude.
    The INST_RESET opcode was 0x0A; the Feetech protocol manual V1.01 §1.3
    defines it as 0x06. INST_CAL (0x0B) and INST_RECOVERY (0x06) don't exist
    on the bus. Nothing in this repo was bound to the affected C++ entry
    points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
2026-08-28 restructure: cartesian_hand package, configurable hands, sim/real contract
    Cartesian_Hand previously exposed a single argparse-style script per task,
    with hand wiring, control-loop threading, policy runner, mock driver, and
    zero-offset persistence split across one cartesian_hand.py and a flat
    commons/ and tasks/ tree. Most of it was hardcoded.
    Restructure:
    cartesian_hand/
    hands.py HandConfig + HandDef, the file you edit
    hand.py CartesianHand + zero-offset persistence
    policy.py Policy contract, run_policy, Rollout, replay
    driver.py extension shim, MockServo
    __main__.py tyro CLI over Config dataclasses
    ft_servo_python.py EPROM fallba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
2026-08-28 First hardware bring-up: per-DOF gains, travel measurement, fixes it found
    Ran the stack against hand_2 (servo IDs 7-13) for the first time. Everything
    here is either something that run broke or something it measured.
    scan reported pos=0 for every servo. It called get_position, which serves the
    async poll cache and reads 0 until start_poll runs; the mock driver aliases
    that to read_position, so it only ever showed up on hardware.
    hand_2's port was /dev/ttyACM1 but it enumerated as ACM0. ACM numbers are
    handed out in plug order, so a fixed number silently addresses whichever hand
    came up first. Pinned to the adapter's by-id path.
    Commanding all seven DOFs to 30mm left the z stage at 22.8mm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
    [__main__.py, hand.py]
2026-08-28 CartesianHand: vector joint interface, fixes found on hardware
    _step() is now two bus packets regardless of gains: one sync-read covering
    all servos, one sync-write carrying per-joint positions and gains. Earlier
    this looped seven reads and branched on gain uniformity to flatten a per-
    joint sync-write into per-servo unicasts.
    hand.py
    - _step() rewritten: read_positions(ids), vector unit conversion, one
    set_positions(ids, pos, speed[], acc[], torque[]) call. Stale readings
    retained for any servo that does not answer.
    - enable() now seeds target from hardware. The loop writes the whole
    target vector each step and target starts as zeros, so without seeding
    the first step d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
    [hand.py]
2026-08-28 README: vectorized control, hardware timings, three documented faults
    Motion gains
    - Replaced the 'mixing values has a cost' warning. SyncWritePosEx carries
    per-servo Speed/ACC/Torque arrays natively; per-joint gains are free.
    - Bisect table for the z-stage lift torque. STALLS at 150 (1.50mm of 5),
    lifts fully at 200+ (4.54mm). Updated hands.py accordingly; old value
    of 150 came from a different load condition.
    Hardware status
    - Per-direction timings from hand_2:
    7 unicast 1 sync
    read 1.97ms 1.47ms (TX only — replies still per servo)
    write 2.35ms ~0ms (broadcast, unacked)
    Sync-read saves less than it looks because the replies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
2026-08-29 set_pos: accept per-DOF gain vectors
    Motion was vectorized so its gains became lists, but set_pos still did
    int(torque) on whatever it was handed. Any task passing m.torque through
    hit a TypeError, which is what broke caps_contact_based.
    Gains now follow the same scalar-or-per-DOF rule as Motion: a scalar
    broadcasts to every commanded DOF, a length-n_dof sequence applies per
    DOF, anything else raises rather than silently truncating.
    [hand.py]
2026-08-29 zeroing: per-DOF creep torque, one sync-write per phase
    Flat zero_torque=50 was wrong for five of seven DOFs. The fingers
    registered a stall short of the end of travel (DOF 1 by roughly 9mm) and
    the z stage stopped in mid-air, so both recorded an offset that was not a
    hard stop. ZEROING_TORQUE puts the fingers at 30 and z at 150, leaving
    the jaws at the 50 that already worked.
    Phases now issue one sync-write for all their DOFs instead of one unicast
    per servo. Within-phase parallelism is safe because a phase only ever
    groups DOFs on independent axes; the phase ordering that keeps the
    mechanism from binding on itself is unchanged.
    --zero-torque N still broadcasts a single value for bringing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
2026-08-29 Collapse set_dofs and hold into set_pos
    Four methods wrote the same two arrays. set_dofs built a vector of Nones
    so set_pos could strip them back out, and hold was set_pos with wait=False
    plus a torque. set_pos now takes a {dof_id: mm} mapping directly and both
    wrappers are gone.
    This removes a double write in approach(), which called set_gains and then
    hold and so set torque twice in consecutive lines -- hold had no speed
    argument, which is the only reason set_gains was there. One set_pos now
    carries position, speed and torque together under a single lock.
    Behaviour change worth noting: hold did not clamp its target and set_pos
    does. Every caller passes 0.0, which is min_mm, so nothing mo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
2026-08-29 primitives: stall threshold is a rate, not a per-poll distance
    wait_for_stall compared per-poll travel against a 0.5mm default over a
    0.05s poll. That is 10mm/s. The hand's fastest commanded speed is 3.7mm/s
    and approach() creeps at 0.61mm/s, so every DOF satisfied the condition on
    every poll and was declared stalled after confirm_count polls -- about
    0.15s -- before it had travelled anywhere.
    approach() consequently returned its starting position as the contact
    point, which means caps_contact_based has been sizing its grip from the
    pre-probe jaw position rather than from the object. It never raised,
    because a plausible number came back.
    Threshold is now mm/s and the elapsed interval is me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
    [primitives.py]
2026-08-29 zeroing: count stall threshold is a rate too
    wait_for_stall_counts took 5 counts per 0.1s poll, which is 50 counts/sec --
    exactly the creep speed zeroing commands. A DOF travelling at precisely the
    commanded rate sat on the boundary and either reading could win; it happened
    to fall the right way. Same shape as the mm-level bug fixed in 710e40f, sitting
    at the margin instead of an order of magnitude past it.
    The threshold is now counts/sec against a measured interval, defaulting to half
    the creep speed, so travelling and stalled are a factor of two apart in both
    directions. The elapsed time has to be measured rather than assumed here for a
    second reason: this variant does one bus read per DO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
    [primitives.py]
2026-08-29 Rebase saved offsets onto the servo's current turn accumulator
    A servo reports (turns since power-up * counts_per_rev) + the angle within the
    current turn. Only the second term survives a power cycle: it comes off a
    magnetic encoder and is valid the instant power arrives, while the turn count
    restarts at zero. So a saved zero offset is stale by a whole number of turns,
    and every mm command after a power cycle is off by that much -- silently, since
    the numbers stay plausible.
    The angle alone places the joint exactly, provided travel is shorter than one
    turn: then only one reachable position matches. load_calibration now recovers
    the offsets from it:
    k = ((raw - offsets) * orientation) %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
    [hand.py]
2026-08-29 README: record the turn-accumulator fault and close two open items
    Three edits to Known issues:
    - The stall threshold in counts is now a rate, so the paragraph saying it
    "should get the same rate treatment" describes work that is done.
    - New entry for the turn accumulator: what the servo actually reports, what
    survives a power cycle, the arithmetic that recovers the offsets, and why the
    ambiguous case refuses instead of choosing.
    - max_mm is no longer only a bookkeeping question. Whether travel sits above or
    below one revolution decides whether stale offsets are recoverable at all, so
    the unmeasured 60mm now blocks something concrete.
2026-08-29 Delete the travel task: there is no far stop to find
    travel drove each DOF away from its zero until it stalled, and called the
    distance the axis travel. That assumes a hard stop at both ends. There is one,
    the one zeroing seeks. The far end of each rail is open by design.
    Run on hand_2 it took six of seven carriages off their sliders. The servos then
    spun free, tracked the command exactly, and reported a span of precisely
    OVERTRAVEL_COUNTS -- the number that was commanded, not one that was measured.
    The task's own _reached_command check flags that case, but it runs on the
    results, after the write.
    No constant fixes this and neither does load feedback: load drops to zero when
    the carriage i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
2026-08-29 Point the docs at the merged ft_servo bench CLI
    The submodule's three bench scripts became `python -m hardware_bindings.ft_servo
    {scan,set-id,gui}`. Update the quickstart commands, and fix the surrounding
    paragraphs, which described ft_servo_python.py as living in cartesian_hand/ when
    it has been in the submodule as ft_servo_python_only.py for some time.
    That driver now has no importers at all: change_id.py was the last one, and the
    merged CLI runs on the compiled extension.
2026-08-30 Delete unused third driver copy and franky_tests/
    cartesian_hand/ft_servo_python.py: zero importers; byte-identical to
    hardware_bindings/ft_servo/ft_servo_python_only.py minus that copy's
    main() demo. README's 'two drivers' note already pointed at the
    surviving copy.
    franky_tests/: Franka arm code predating the FT-servo restructure.
    No importers in the cartesian_hand stack or in pyproject.toml.
    Relocating into the package would have added Franka deps for code
    with no caller.
2026-08-30 Fix hand_1 stall-detector false positives in zeroing
    wait_for_stall_counts scored each poll as |dcounts|/dt with a
    25 counts/sec threshold and confirm_count=2. Encoder quantization at
    the 0.1s poll gave steps of 10 counts/sec, leaving 2.5 steps of margin.
    hand_1's higher friction meant its creep landed below the threshold,
    so pairs of polls on the same count read as a stall and recorded
    mid-rail hard stops.
    Rewrote as a tumbling-window detector: net displacement over
    confirm_s seconds, threshold 5 counts/sec. The window widens the gap
    by an order of magnitude and a dropped read contributes nothing
    rather than scoring as zero. --stall-speed exposed on the CLI.
    ZEROING_TORQUE doubled to [150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
    [primitives.py]
2026-08-30 Per-DOF travel table, hoisted tunables to top of hand.py
    The hand's travel was a single 60mm scalar stamped across all seven
    DOFs in standard_dofs. The per-DOF plumbing (lower, upper, clamp,
    normalize, contract) was already there; one function collapsed it.
    Result: over-travel on every DOF, by 10mm on the jaws and z.
    New STANDARD_TRAVEL = [50, 55, 55, 50, 50, 55, 55] matches the v2 CAD.
    Shared between hands because the limit belongs to the model and the
    two hands are two realizations of it. Length check on standard_dofs'
    input so a short table doesn't silently hand the trailing DOFs the
    Dof dataclass default.
    The fingers at 55mm exceed 50.27mm (one motor turn at the derived
    counts_per_mm),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
    [hand.py]
2026-08-30 Simplify __main__.py: drop _annotate/_task_command wrappers
    The two helpers and the Flat class-with-__class_getitem__ now live
    inline: build_cli() reads as one list-comprehension union, tyro.conf
    .subcommand is applied as a comprehension, Flat is a 2-line class.
    Drop the import re-export in __init__.py ('hands' no longer exists).
    Widen except in main() to plain Exception so OSError (serial port
    unplugged), TimeoutError, and tyro's own parser errors reach the
    user instead of dying with a traceback.
    [__main__.py]
2026-08-30 README: per-DOF travel, two-file history, stale 60mm references
    - Travel section: explain STANDARD_TRAVEL, retract 'config says 60'
    since it now says 50/55 per CAD.
    - Layout block: hands.py removed; hand.py opens with tunables.
    - Turn-boundary analysis: rewritten to use the new per-DOF numbers,
    noted that the worst DOF (fingers at 55mm = 1.09 turns) decides
    for all seven.
    - Slew-limit arithmetic: 3mm/step -> 2.5mm/step at 50mm travel.
    - Removed the line telling you to run the deleted travel task.
2026-08-30 update servo binding
2026-09-05 README: drop deleted tests/ and bulb.py, correct z torque floor
2026-09-05 Add golden-trace check for all eight tasks
2026-09-05 sim: one control loop shared by the CPU and warp backends
    [sim.py]
2026-09-05 Document the trace check; record why studio.live was left alone
2026-09-05 sim: ramp the setpoint, not the joint, so z can rise against gravity
    The old profile clamped (goal - measured_position), so a gravity-loaded DOF
    could never build the position error that drives torque and lifts it. z was
    stuck at -0.3 mm in every sim run; bench history records that acc=200 was what
    freed the real z stage.
    Carry the setpoint across ticks, seeded from the first reading. ready now
    passes in sim where it raised before. syringe's tick count shifts (3583 to
    3273) because z is no longer silently parked; the other seven traces are
    byte-identical.
    [sim.py]
2026-09-05 update camera
2026-09-17 code clean up to prepare release
    [base.obj, base_00.obj, base_01.obj, base_02.obj, base_03.obj, base_04.obj, base_05.obj, base_06.obj]
2026-09-17 update the joint monkey, primitive tour, workspace sweep
2026-09-20 Prepare the repo for public release
    De-anonymize the README, commit the stale submodule pointer, declare torch
    as a dependency and mujoco/viser as extras, move the bench scripts under
    scripts/, untrack CLAUDE.md, and track the camera test.
2026-09-20 README: triggers has a task file now
    The Objects table listed Trigger with no --task name and the note below it
    said trigger actuation had no task file at all. tasks/triggers.py has existed
    since the task rewrite; --task triggers builds and carries the label
    "Pull trigger". Also name pump alongside syringe, which is now a pump variant.
2026-09-20 Re-encode the README clips to a third of their weight
    The three animated WebP came to 13.7 MB, all of it downloaded before a reader
    sees the first heading. Now 5.2 MB.
    Two levers. Each clip was stored above the width its <img> tag displays it at
    -- hero and humanoid at 880 shown at 640, objects at 1100 shown at 820 -- so
    the browser was downsampling pixels the reader had already paid for; they are
    now encoded at display width. Quality was not the fat: at 2x zoom on the
    objects grid, q24 is hard to tell from the original, and per-pixel
    compression was already near its floor. The rest is frame count, so hero and
    humanoid drop 12 -> 6 fps with each remaining frame's duration doubled.
    Playback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
2026-09-22 Vendor the sim-asset builder and refresh from it
    The sim asset under assets/cartesian_hand/ is generated; commit 0035209 had
    drifted past the source it claims in its header comment. Vendor the build
    pipeline so a future drift can be caught and fixed in-repo:
    python assets/cartesian_hand/cartesian_hand_creation.py # regen XML
    python assets/cartesian_hand/cartesian_hand_creation.py --check # exit 1 on drift
    The builder reads source/kinematics.json + source/body_inertia.json +
    meshes/ and writes cartesian_hand.xml. The constants-module cross-check
    is now optional (that module lives in mjlab, not this repo). STEP and
    collision pieces stay committed inputs -- step_to_obj.py nee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
    [base.obj, base_00.obj, base_01.obj, base_02.obj, base_03.obj, base_04.obj, base_05.obj, base_06.obj]
2026-09-22 Re-record traces.json and document the asset build
    tests/traces.json was stale (5 of 8 tasks failed test_trace.py because
    the engine has drifted since the last record at commit 8199263, +3994
    lines in tasks/ since). --update against the current engine; all 8
    traces now match.
    assets/cartesian_hand/BUILD.md: short doc for the regen commands and
    their extra dependencies. The README points readers at the sim model
    without explaining it is a build artifact.
2026-09-22 Add bug report issue template
    Six required fields (hand, OS, Python version, pip freeze for the
    relevant packages, the exact command, and observed output) and two
    optional ones (zeroing date, hardware state). A hardware repo's bug
    reports are useless without the servo state, the bus path, and the
    version pins -- this is the form that catches the questions that have
    to be asked before any diagnosis is possible.
2026-09-22 BUILD.md: name where the CAD and the OBJs live
    Mention the STEP path under source/ and the OBJ layout under meshes/
    explicitly, so a reader rebuilding the asset can find the inputs without
    grepping for them.
2026-09-22 BUILD.md: tighten prose
2026-09-22 README: tighten prose
    Em dashes throughout. Section headings to sentence case to match the
    docs/. A few passive constructions swapped to active where the actor
    was clear.
2026-09-23 Citation: switch to arXiv BibTeX with eprint + primaryClass
2026-09-23 De-link hardware_bindings submodule
    The submodule pointer forced every cloner to run --recurse-submodules,
    or to remember to fix it after the fact, and it gave us no way to fix
    typos in the C++ driver without a coordinated push to two repositories.
    Vendor it: the 1daf7d8 contents now live directly under hardware_bindings/
    with the same layout they had as a submodule.
    README install steps no longer mention --recurse-submodules, the
    project-structure block drops the 'submodule:' label, and the bench CLI
    hint in docs/hardware.md points at './hardware_bindings[cli]' instead
    of a separate clone.
    [HLSCL.cpp, HLSCL.h, INST.h, SCS.cpp, SCS.h, SCSerial.cpp, SCSerial.h, __main__.py]
2026-09-23 README: shorten (970 words, ~half)
    Cut the hand-specs table (the CAD render says it), the DOF table (the
    formula in docs/hardware.md is the right home), and the project-structure
    block (incomplete and lives in docs/ in spirit). Folded the two blockquote
    warnings into inline prose. Reordered Tests and Status so Status comes
    first -- the reader's first question after 'what is this' is 'can I trust
    it'.
2026-09-23 README: name the three backend entry points in the intro
    The intro paragraph said 'three backends that execute it on servos, on
    CPU MuJoCo, or on batched GPU MuJoCo' but never named cartesian_hand.studio
    / cartesian_hand.sim / sim --warp. A reader who reads the intro and then
    jumps to Quick start has to map the prose to the commands themselves.
    Inline the entry points so the prose and the commands share the same
    names.
2026-09-23 Absorb hardware_bindings/ into the repo
    The runtime control stack imports `cartesian_hand.ft_servo_ext`; only
    the bench CLI and `scripts/bench_servo_check.py` ever reached into the
    `hardware_bindings` Python package. Move the C sources under
    cartesian_hand/src/ft_servo/ so the build is self-contained, move the
    bench CLI to scripts/ft_servo_tools/ (loading through the same
    `cartesian_hand.servo` entry point), drop motor/ imu/ common/ and the
    dead ft_servo_python_only driver, and drop the now-empty
    hardware_bindings/.
    The pyproject `serial` extra is gone with the dead driver. The bench
    CLI's GUI now hangs off a `gui` extra. All doc references to the old
    paths in README.md, docs/hardware.md, a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
2026-09-23 Fix stale references left by the hardware_bindings absorb
    Drop the nonexistent [cli] extra from install docs (tyro is a core dep),
    point the turn-recovery note at docs/hardware.md, and drop the CMake
    comment about a driver.py search fallback that no longer exists.
2026-09-23 Make README and docs match the code for a no-hardware first run
    - README: a no-hardware quick start (studio --mock, sim), what each can
    and cannot show, Python 3.10+/Linux requirement, and the fact that
    every install compiles the extension. Add release_torque.
    - requires-python >=3.10: config.py evaluates float | None at runtime.
    - hardware.md: drop the claim that --mock completes cap (the object stops
    lived in a deleted test); document hand_3 and the real servo-ID blocks;
    replace the nonexistent torque field and TORQUE_* constants with the
    real torque_min_to_move/torque_stuck; note torque_stuck is unused.
    - scripts/README: list ft_servo_tools/.
    - Delete CMakePresets.json: machine-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
2026-09-23 Say that hand_1..hand_3 are our lab's units, not presets
    A builder reading config.HANDS had no way to tell the three entries are
    specific machines with their own measured torques. Document how to add
    their own entry, and that without one a fresh build on IDs 0-6 is
    silently identified as hand_3.
2026-09-23 Make a new hand one line to configure, and document the steps
    - config: drop torque_stuck (nothing read it) and give torque_min_to_move
    a default, STANDARD_TORQUE_MIN_TO_MOVE, the un-bisected values hand_1
    and hand_3 run. A new entry is now name, port and first servo ID. The
    lab hands still state their own floor, so changing the default does
    not retune them.
    - hardware.md: a numbered 'Configuring a new hand' procedure (IDs with a
    DOF table, the entry, direction check, torque floor, travel, zero);
    explain that an overlapping ID block works only with --hand.
    - README: hardware commands pass --hand my_hand and link the procedure.
2026-09-28 Add CAD, BOM, and assembly instructions
    [auxiliary gripper rail.step, base gripper rail.step, cartesian_hand_v14_latest.f3z, finger tip.step, finger.step, franka_mount.f3d, franka_mount.step, gear.step]
